Gsmads/EV-Controller/docs/images/Схема_Контроллера.png

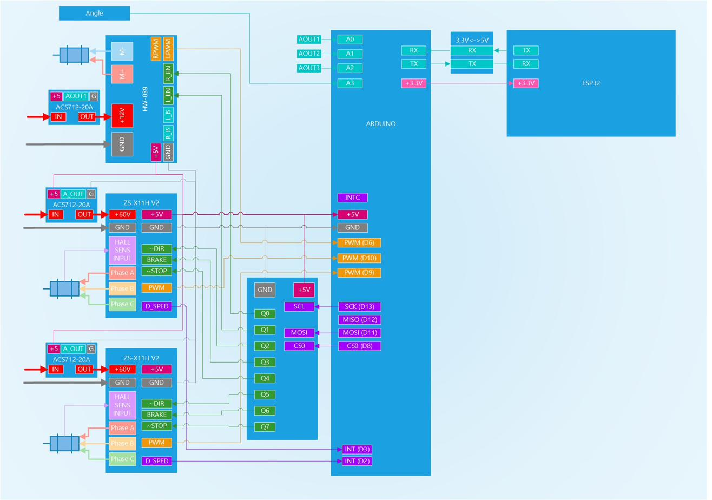
docs/images/Схема_Контроллера.png
