Gsmads/EV-Controller/docs/adr/README.md

# Архитектурные решения (ADR)

Записи решений, которые дороже отменить, чем принять. Формат и правила —
`../CONVENTIONS.md` §4. Шаблон — `0000-template.md`.

ADR не редактируются после принятия. Изменение решения оформляется новым
ADR со ссылкой «заменяет ADR-NNNN».

| № | Решение | Статус |
|---|---|---|
| [0001](0001-chetyre-sloya.md) | Четырёхслойная архитектура с изоляцией платформы | принято |
| [0002](0002-otkaz-ot-funkcij-arduino.md) | Отказ от функций Arduino, HAL на регистрах | принято |
| [0003](0003-nastrojki-v-eeprom.md) | Настройки в EEPROM, изменяемые по UART | принято |
| [0004](0004-sloistaya-model-pedalej.md) | Слоистая модель педалей с комбинатором | принято |
| [0005](0005-reestr-parametrov.md) | Реестр параметров как единый контракт | принято (ADR-0017) |
| [0006](0006-politika-poteri-svyazi.md) | Три таймаута, политика потери связи настраивается | предложено |
| [0007](0007-gibridnyj-raschet-skorosti.md) | Гибридный расчёт скорости | предложено |
| [0008](0008-bezopasnoe-sostoyanie-apparatno.md) | Безопасное состояние задаётся аппаратно | принято |
| [0009](0009-analogovye-kanaly-nastraivaemy.md) | Аналоговые каналы настраиваемы, цифровые нет | принято |
| [0010](0010-timer0-ostayotsya-pod-tik.md) | Timer0 под системный тик, ШИМ руля 976 Гц | принято |
| [0011](0011-binarnyj-protokol.md) | Бинарный протокол с CRC16 | принято |
| [0012](0012-vanilla-js-i-abstraktnyj-transport.md) | Vanilla JS с абстрактным транспортом | принято |
| [0013](0013-licenziya-gpl-v3.md) | Лицензия проекта — GPL v3 | принято |
| [0014](0014-vremennye-isklyucheniya-storozhej.md) | Сторожа границ платформы со списком временных исключений | принято |
| [0015](0015-skorost-uart-250000.md) | Скорость UART — 250000 бод | принято |
| [0016](0016-politika-perepolneniya-tx.md) | Политика при переполнении TX выбирается настройкой | принято |
| [0017](0017-izmenyaemaya-konstanta-zhivyot-v-nastrojkah.md) | Изменяемая константа живёт в настройках, а не в коде | принято |
| [0018](0018-sobstvennyj-drajver-uart.md) | Собственный драйвер UART вместо адаптации Grbl | принято |
| [0019](0019-skorost-uart-nastrojka-s-otkatom.md) | Скорость UART — настройка с испытательным периодом и откатом | принято |
| [0020](0020-domennye-imena-signalov.md) | Основной код называет сигналы, слой железа их привязывает | принято |
| [0021](0021-hranilishcha-abstragirovany.md) | Программа знает «постоянное» и «долговременное», а не PROGMEM и EEPROM | принято |

**Статусы:** предложено — решение сформулировано, но не реализовано;
принято — реализовано или обязательно к соблюдению; заменено — см. ссылку.
