Gsmads/EV-Controller/docs/adr/0014-vremennye-isklyucheniya-storozhej.md

# ADR-0014: Сторожа границ платформы вводятся со списком временных исключений

**Статус:** принято
**Дата:** 12.09.2026
**Заменяет:** —
**Заменён:** —

## Контекст

Задачи 0.2.4 и 0.2.5 (`docs/SLICE_0_PLAN.md:68-69`) требуют завести двух сторожей:
`Arduino.h` и `avr/*` не встречаются нигде, кроме `hal_atmega328p.cpp` (ADR-0001),
и функции Arduino не вызываются нигде, включая HAL (ADR-0002). Этап 0.2 идёт
до исправления дефектов намеренно: «Сначала проверки, потом исправления. Иначе
первое же исправление окажется непроверяемым» (`docs/SLICE_0_PLAN.md:60-61`).

На снимке `8f16d9c` оба правила уже нарушены, и оба нарушения — не свежие ошибки,
а унаследованный код:

**Заголовки — два файла.** `firmware/MICRO_UART.h:22` и `firmware/PRINT.h:1`
включают `Arduino.h`. Оба пришли из Grbl вместе с кодом UART. Через них Arduino Core
доходит до `firmware/app_debug.cpp:7-8` — файла слоя `app_*`, прямо названного
в запрете `docs/CONVENTIONS.md:15`.

**Функции — семь вызовов, все в `hal_atmega328p.cpp`:** `pinMode` (строки 41-43),
`digitalWrite` (49), `digitalRead` (54), `millis` (289), `delayMicroseconds` (294).

Из этого следует выбор, которого не было бы на чистом дереве: сторож, введённый
как есть, красный с первого дня — на всё время этапов 0.3 и 0.4, то есть ровно тогда,
когда по красному CI предстоит судить об исправлениях блокирующих дефектов.

Убрать нарушения сразу тоже нельзя целиком. GPIO-часть переписывается на регистры
без внешних условий, а `hal_system_millis` — нет: замена требует выбрать таймер
системного тика, а пункт C-2 `docs/HARDWARE_BRINGUP.md:483-498` не закрыт («**Решено:**
\_\_\_\_», сводка `:609` — «⬜ решение владельца»), и сам код противоречит ADR-0010
(комментарии `hal_atmega328p.cpp:12`, `:277`, `:283` называют Timer2, ADR-0010 и
`HARDWARE_BRINGUP.md:485-486` — Timer0). Кроме того, вся правка лежит в HAL,
а `docs/CONVENTIONS.md:220` относит проверку HAL на железо, которого сейчас нет:
этап 0.1 не выполнен, поле «Сделано» в `docs/HARDWARE_BRINGUP.md:230` пусто.

`docs/CONVENTIONS.md:23` допускает отступление от правил раздела 1 только с ADR.
Настоящая запись и есть это решение.

## Решение

Сторожа вводятся сейчас, со списком исключений, зафиксированным в самом стороже —
`tools/ci/check_layer_boundaries.py`.

**Исключения по заголовкам** (проверка `headers`): `firmware/MICRO_UART.h`,
`firmware/PRINT.h`. Снимаются задачей
[#31](https://github.com/Gsmads/EV-Controller/issues/31).

**Исключения по функциям** (проверка `functions`): в `firmware/hal_atmega328p.cpp`
допускаются `pinMode` — не более 3 вхождений, `digitalWrite` — 1, `digitalRead` — 1,
`millis` — 1, `delayMicroseconds` — 1. Снимаются задачей
[#32](https://github.com/Gsmads/EV-Controller/issues/32).

Исключения заданы **числом вхождений, а не файлом целиком**. Восьмой вызов в том же
файле сторож уже отвергает; список может только сокращаться. Проверено намеренным
нарушением: добавленный `millis()` в `hal_atmega328p.cpp` роняет проверку с указанием
«исключение допускает 1 вхождений, найдено больше».

Каждое исключение несёт в коде сторожа ссылку на снимающую его issue. Исключение
без такой ссылки не добавляется: у компромисса должен быть срок, а не только причина.

## Последствия

**Что становится проще.** Правило начинает действовать на весь остальной код
немедленно: любое новое нарушение в `svc_*`, `util_*`, `cfg_*`, `app_*` и в самом HAL
роняет CI. Этапы 0.3 и 0.4 идут при зелёном CI, поэтому красный на них означает
настоящую поломку, а не унаследованный фон.

**Что становится сложнее.** В проекте появляется место, где правило записано
дважды: в `CONVENTIONS.md` §1 и в списке исключений сторожа. Пока исключения живы,
утверждения `README.md:163-164`, `docs/MVP1_API.md:30` и `firmware/hal_atmega328p.cpp:9`
остаются неверными — это зафиксировано в #31 и #32, а не замолчано.

**Что мы обязаны поддерживать.** Список исключений сокращается вместе с закрытием
#31 и #32 и не растёт: новое исключение потребует нового ADR. Раздел «чего сторож
не покрывает» в шапке `check_layer_boundaries.py` обновляется вместе с самим сторожем —
этого требует `docs/SLICE_0_PLAN.md:76-77`.

**Чего решение не даёт.** Сторожа текстовые. Косвенное включение (`app_debug.cpp`
получает Arduino Core через `MICRO_UART.h`), использование платформенных имён без
включения их заголовка (`ISR`, `UDR0`, `PSTR`, `pgm_read_byte_near`), макросы `A0`…`A7`
в `cfg_board.h` и подстановка `Arduino.h` в `.ino` силами Arduino IDE не ловятся
ни одной из двух проверок. Полный перечень — в шапке сторожа.

## Отклонённые варианты

| Вариант | Почему отклонён |
|---|---|
| Переписать HAL и заголовки сейчас, ввести сторожа без исключений | Правило соблюдалось бы буквально, но `hal_system_millis` упирается в незакрытый C-2: таймер системного тика не выбран, а это решение владельца. Вся правка лежит в HAL и проверяется только на железе (`CONVENTIONS.md:220`), которого нет: этап 0.1 не выполнен. Этап «сначала проверки» превратился бы в правку прошивки вслепую |
| Ввести сторожа красными, чинить по ходу | Красный CI на всё время этапов 0.3-0.4 перестаёт быть сигналом. Ровно то, ради чего сторожа заводились, было бы потеряно: на красном фоне новое нарушение не видно |
| Отложить сторожей до конца 0.3-0.4 | Прямо противоречит порядку плана (`SLICE_0_PLAN.md:60-61`): исправления блокирующих дефектов пошли бы без проверки, которая их страхует. Первое же исправление оказалось бы непроверяемым |
| Исключить `hal_atmega328p.cpp` из проверки функций целиком | Проще в коде, но прячет будущие нарушения в единственном файле, где они наиболее вероятны: HAL и пишется вокруг работы с платформой. Счётчик вхождений даёт то же удобство, не теряя надзора |
| Отключить правило в `CONVENTIONS.md` §1.2 для HAL | Меняет само решение ADR-0002 ради удобства одного этапа. Переносимость — причина, по которой проект вообще разделён на слои; отказываться от неё из-за семи унаследованных строк несоразмерно |
| Пометить нарушения комментарием `// NOLINT` в коде | Исключение расползается по файлам прошивки и перестаёт быть видимым списком. Здесь оно собрано в одном месте, с числами и ссылками на issue |

## Проверка

Критерий приёмки этапа (`docs/SLICE_0_PLAN.md:72-74`) и проверки сверх него.
Все выполнены на снимке перед принятием решения:

| Случай | Ожидание | Факт |
|---|---|---|
| Текущее дерево, обе проверки | зелёный | зелёный, исключения перечислены в выводе |
| `#include <Arduino.h>` в `svc_ramp.cpp` | красный, назван файл и строка | `firmware/svc_ramp.cpp:10`, найдено `Arduino.h` |
| откат той же строки | зелёный | зелёный |
| `#include <avr/io.h>` в `svc_speed.cpp` | красный | `firmware/svc_speed.cpp:30`, найдено `avr/io.h` |
| `#include <avr/pgmspace.h>` в `app_protocol.cpp` | красный | `firmware/app_protocol.cpp:21` — файл не собирается тестами, десктопная сборка его не проверила бы |
| `digitalWrite(9, HIGH);` в `svc_ramp.cpp` | красный | `firmware/svc_ramp.cpp:71`, найдено `digitalWrite` |
| лишний `millis()` в `hal_atmega328p.cpp` | красный, несмотря на исключение | `:291`, «исключение допускает 1 вхождений, найдено больше» |
| то же нарушение внутри комментария | зелёный | зелёный, обе проверки |

Исключение считается снятым, когда соответствующая запись удалена из
`tools/ci/check_layer_boundaries.py` и обе проверки зелёные без неё.
