Gsmads/EV-Controller/docs/adr/0002-otkaz-ot-funkcij-arduino.md

# ADR-0002: Отказ от функций Arduino, собственный HAL на регистрах

**Статус:** принято
**Дата:** 2026-09-09

## Контекст
Первая реализация HAL внутри себя вызывала Arduino: `digitalWrite`,
`analogRead`, `millis`, `delayMicroseconds`. Формально правило «платформа
только в HAL» соблюдалось, но фактически проект оставался привязан
к Arduino Core.

Три проблемы:
1. `digitalWrite` выполняется около 50 тактов из-за поиска в таблицах
   и отключения ШИМ — для сигналов, дёргаемых в цикле 100 Гц, это расход
   без пользы.
2. `millis` завязан на таймер, который ядро настраивает по-своему,
   и это ограничивает свободу в распределении таймеров.
3. Переезд на STM32 требовал бы не замены файла, а разбирательства,
   какие ещё зависимости от ядра просочились.

## Решение
Функции Arduino не используются нигде, включая HAL. Внутри
`hal_atmega328p.cpp` реализуются собственные эквиваленты на прямой работе
с регистрами: порты, АЦП, таймеры, системный тик, внешние прерывания,
задержка микросекундного порядка.

Интерфейс HAL при этом не меняется — правка внутренняя.

## Последствия
- Прошивка перестаёт зависеть от Arduino Core, кроме тулчейна сборки.
- Время выполнения операций становится предсказуемым.
- Растёт ответственность: ошибки в работе с регистрами не поймает
  ядро, их поймает только стенд.
- Скетч по-прежнему собирается в Arduino IDE — это удобно и остаётся.

## Отклонённые варианты
| Вариант | Почему отклонён |
|---|---|
| Оставить Arduino внутри HAL | Скрытая привязка к ядру, непредсказуемое время выполнения |
| Перейти на PlatformIO с чистым avr-gcc | Полезно, но это отдельное решение про инструменты; сейчас важнее избавиться от зависимости в коде, а не сменить IDE |
| Сразу писать под STM32 HAL | Железо есть в руках именно ATmega, переезд гипотетичен |

## Проверка
Сторож в CI дополняется списком запрещённых идентификаторов Arduino.
Замер: время выполнения `hal_gpio_write` на осциллографе — ожидается
единицы тактов вместо десятков.
