Gsmads/EV-Controller/docs/adr/0010-timer0-ostayotsya-pod-tik.md

# ADR-0010: Timer0 остаётся под системный тик, ШИМ руля работает на 976 Гц

**Статус:** принято
**Дата:** 2026-09-09

## Контекст
ШИМ электроусилителя руля выведен на D6, то есть на вывод сравнения
Timer0. Этот же таймер традиционно обслуживает системный тик.

Перенастройка Timer0 ради произвольной частоты ШИМ руля сломала бы
отсчёт времени, на котором держится весь планировщик.

## Решение
На текущем этапе Timer0 сохраняет роль системного тика. ШИМ руля
работает на частоте, которую даёт стандартная конфигурация — около
976 Гц.

Решение принимается как временное и пересматривается, если на стенде
выяснится, что писк редукторного мотора руля неприемлем.

## Последствия
- Планировщик и все измерения времени остаются работоспособными.
- Мотор руля будет слышно. Для редукторного привода детского автомобиля
  976 Гц — рабочая частота, шум терпим.
- Свобода выбора частоты ШИМ руля отсутствует, пока решение не изменено.
- Разрешение ШИМ руля — 8 бит вместо 10 у моторов колёс. Для позиционного
  контура этого достаточно.

## Отклонённые варианты
| Вариант | Почему отклонён |
|---|---|
| Перенастроить Timer0 под ШИМ | Ломает системный тик, от которого зависит весь планировщик |
| Перенести тик на Timer2 заранее | Оправданно, но это отдельная работа с риском; делать её до первого запуска руля нет причин |
| Перенести ШИМ руля на другой вывод | Выводы сравнения Timer1 заняты моторами, Timer2 — не разведён на нужный вывод |

## Проверка
После сборки узла руля: измерить уровень шума на слух и осциллографом
проверить, что тик не сбивается при работе ШИМ руля.
