Gsmads/EV-Controller/docs/design/mockup.html

EV CONTROL ROOM

PORT/dev/ttyUSB0 UPTIME00:00:00 PWM7812 Hz FAULTS · 0

### Control Source

PEDALS live

UART override

### External Inputs MVP-3

Ignition

Neutral

Handbrake

Eco

Sport

Reverse

Turn L

Turn R

### Lights MVP-2

◯

HEAD OFF

◯

TAIL OFF

◉

BRAKE ON

◯

REV OFF

◯

TURN L —

◯

TURN R —

### Communication

TX rate10 / s

RX rate0 / s

CRC errors0

Latency2.4 ms

Baud9600

BATTERY

72%

24.8V

2.1A

MVP-3

000

PWM ‰

ECO

PEDALS · LIVE

CURRENT TARGET

PWM SPEED

PWM Pedals Power L/R Current Speed Steering

PWM TARGET / CURRENT 000 000

PEDAL INPUT 000 000

POWER PER WHEEL MVP-2 L R

GAS

0000/1023

BRAKE

0000/1023

LCK NEU HBR ECO NRM SPT REV PRT

RELEASE
TO PEDALS E·STOP
