Gsmads/EV-Controller/CLAUDE_CODE_START.md

# Стартовое сообщение для Claude Code

Распаковать архив, открыть папку `EV_Controller` в Claude Code,
скопировать блок ниже целиком в первое сообщение.

---

```
Привет. Начинаем работу над контроллером детского электромобиля.

СНАЧАЛА ПРОЧИТАЙ, НИЧЕГО НЕ МЕНЯЯ:
  1. CLAUDE.md                  — правила проекта, что требует моего решения
  2. docs/CONVENTIONS.md        — код, комментарии, ADR, коммиты, DoD
  3. docs/SLICE_0_PLAN.md       — план работ, которым мы займёмся
  4. docs/AUDIT.md              — что сломано и почему
  5. docs/HARDWARE_BRINGUP.md   — что уже измерено на железе, что нет
  6. docs/adr/README.md         — принятые архитектурные решения
  7. README.md                  — обзор проекта

Ключевой контекст: в машине ездит ребёнок. Код никогда не запускался
на реальном железе. Документация местами расходится с кодом — истина
всегда код, но расхождение чинится, а не обходится.

ЗАДАЧА ЭТОЙ СЕССИИ — только репозиторий. Дефекты НЕ чиним.

  1. Инициализируй git-репозиторий в текущей папке.

  2. Первый коммит — снимок как есть, без единой правки кода.
     Сообщение должно честно фиксировать состояние: код на железе
     не проверялся, известны блокирующие дефекты, см. docs/AUDIT.md

  3. Заведи issues по docs/SLICE_0_PLAN.md — по одной на задачу
     этапов 0.2–0.7. Метки как в docs/CONVENTIONS.md §5:
     blocker, safety, hw-unknown, debt, docs.
     Формулировка — наблюдаемым поведением, не «переписать модуль».
     Каждая issue содержит: что наблюдается, что ожидается, как проверить.
     Задачи со safety дополнительно — что происходит в худшем случае.

     Этап 0.1 (аппаратный) issues не требует — это моя работа с паяльником.

  4. Покажи мне:
     - дерево репозитория
     - git log
     - список заведённых issues с метками

ЧЕГО НЕ ДЕЛАТЬ В ЭТОЙ СЕССИИ:
  - не исправлять дефекты
  - не трогать firmware/
  - не переписывать документацию
  - не добавлять зависимости
  - не создавать CI (следующая сессия)

Если возникнет вопрос, ответ на который меняет структуру или поведение —
останови работу и покажи развилку таблицей «что делает / чем платим»
с твоей рекомендацией. Жди моего ответа.
```

---

## План следующих сессий

Каждая начинается с «прочитай CLAUDE.md, docs/CONVENTIONS.md и текущий
этап из docs/SLICE_0_PLAN.md», дальше — одна тема.

### Сессия 2 — этап 0.2, сторожа

> Заводим проверки до исправлений, иначе первое же исправление
> окажется непроверяемым.
>
> Задачи 0.2.3–0.2.6 из плана среза.
>
> Критерий приёмки строгий: намеренно добавленный `#include <Arduino.h>`
> в `firmware/svc_ramp.cpp` роняет CI с внятным сообщением; после отката —
> зелёный. То же для `digitalWrite` в любом файле сервисов.
>
> Сторож должен в комментарии честно писать, чего он не покрывает.

### Сессия 3 — этап 0.3, блокирующие дефекты

> Строго по одному дефекту за коммит, каждый начинается с красного теста.
>
> 0.3.1 TX-буфер, 0.3.2 сентинел 0xFF, 0.3.3 формула скорости,
> 0.3.4 аппаратный watchdog.
>
> По 0.3.1 и 0.3.4 сначала покажи развилку — там выбор политики,
> он описан в плане.

### Сессия 4 — этап 0.4, безопасность

> 0.4.1 аварийная остановка как защёлкивающееся состояние,
> 0.4.2 асимметрия watchdog газа и тормоза,
> 0.4.3 минимальный валидатор настроек,
> 0.4.4 смена режима.
>
> 0.4.1 и 0.4.2 меняют поведение безопасности: сначала развилка,
> потом ADR, потом код. ADR-0006 уже описывает целевую модель.

### Сессия 5 — этап 0.5, точность управления

> 0.5.1 фактический шаг времени вместо предполагаемого — развилка
> в плане, я склоняюсь ко второму варианту.
> 0.5.2 счётчик пропущенных дедлайнов в телеметрии.

### Сессия 6 — этап 0.6, ввод железа в строй

> Замеры делаю я, ты готовишь диагностические скетчи: подсчёт импульсов
> энкодера, развёртка АЦП по всем каналам, генератор ШИМ заданной частоты.
> Результаты вносим в docs/HARDWARE_BRINGUP.md, заводские значения
> в cfg_settings.cpp заменяем на измеренные.

### Сессия 7 — этап 0.7, документация

> Привести PROTOCOL.md и ARCHITECTURE.md в соответствие с кодом.
> Добавить в шапки версии, даты и список документов-оснований.
> Проверка: пять произвольных утверждений из документации
> подтверждаются кодом.

---

## Что делаю параллельно я

| Когда | Что |
|---|---|
| **До сессии 3** | Резисторы на D9, D10, D6 — иначе перепрошивка даёт полный газ |
| До сессии 3 | Решить уровень покоя BRAKE (HARDWARE_BRINGUP A-5) |
| До сессии 3 | Проверить загрузчик — от этого зависит включение watchdog |
| До сессии 6 | Прозвонка HC595, осциллограф на оптопарах |
| До сессии 6 | Замеры: аналоговые каналы, диапазон АЦП, импульсы на оборот |
