Gsmads/EV-Controller/docs/AUDIT.md

# Технический аудит проекта EV Controller

**Дата:** 09.09.2026
**Объём:** firmware (37 файлов), web GUI (17 файлов), тесты (71), документация
**Метод:** чтение кода, проверка формул расчётами, сквозная сверка слоёв протокола, сверка с `Методология_разработки_v1.0.md`
**Статус проверки на железе:** прошивка не запускалась на реальном контроллере ни разу

---

## 0. Вердикт

**Структура — хорошая. Реализация — не поедет.**

Разделение на слои, изоляция платформы в одном файле, настройки в EEPROM с CRC, конфигурируемый комбинатор педалей, модульный фронтенд — это правильные решения уровня senior. Они не потребуют переписывания.

Но внутри этой структуры находятся дефекты, из-за которых система в текущем виде **не заработает при первом включении**, а три из них — вопросы безопасности ребёнка. Причина одна и та же: код писался «вперёд», без единого прогона на железе и без тестов на критических модулях. Всё, что покрыто тестами (`util_math`, `cfg_settings`, `svc_ramp`), — корректно. Всё, что не покрыто (`svc_speed`, `svc_pedals`, протокол, UART), — содержит дефекты.

Это ровно то, о чём говорит методология: **«держится сборкой, а не памятью»**. Здесь оно держалось памятью — и не удержалось.

---

## 1. Блокирующие дефекты

### B-1. TX-буфер UART в 9 байт вместо 64 — телеметрия физически не пролезает

`cfg_board.h` объявляет `TX_BUFFER_SIZE 64`. Но `MICRO_UART.cpp` **не включает `cfg_board.h`** — только собственный заголовок. В этой единице трансляции срабатывает `#ifndef` по умолчанию: `TX_BUFFER_SIZE = 8`, кольцевой буфер = 9 байт.

Пакет телеметрии — 36 байт данных + 5 служебных = **41 байт**.

Хуже: из `serial_write()` **удалена проверка переполнения**, которая есть в оригинальном Grbl:

```c
void serial_write(uint8_t data) {
  uint8_t next_head = serial_tx_buffer_head + 1;
  if (next_head == TX_RING_BUFFER) { next_head = 0; }

  /* ← здесь в Grbl стоит:
       while (next_head == serial_tx_buffer_tail) { ... }
     в этом коде — пустая строка */

  serial_tx_buffer[serial_tx_buffer_head] = data;   // затирает неотправленные данные
  serial_tx_buffer_head = next_head;
}
```

**Следствие:** каждый пакет телеметрии затирает сам себя в буфере. CRC не сойдётся, веб не получит ничего. Разработчик увидит «Arduino подключён, данных нет» и будет искать проблему в Python.

**Исправление:** добавить `#include "cfg_board.h"` первой строкой `MICRO_UART.cpp` **и** вернуть проверку заполнения. Вопрос политики при переполнении — отдельное решение: блокировать (как Grbl) нельзя в цикле управления 100 Гц; правильнее отбрасывать пакет целиком и считать счётчик потерь как перечислимый исход.

**Решение владельца (ADR-0016).** Политика выбирается настройкой: отбрасывать пакет (умолчание) либо ждать. Счётчик `uart_tx_dropped` уходит в телеметрию. Довод «блокировать нельзя» относился к 9600, где пакет занимал 42,71 мс — четыре цикла управления. На 250000 (ADR-0015) тот же худший случай — 1,64 мс, то есть 16,4 % одного периода, и ожидание ограничено сверху скоростью линии.

**Состояние: исправлено.** `MICRO_UART.*` удалены (ADR-0018). Кольцевой буфер переехал в переносимый `util_ring` и покрыт десктопными тестами: запись в полное кольцо отвергается и не затирает ранее записанные байты. Кадр собирается целиком в `app_protocol.cpp` и уходит одним вызовом `hal_uart_write_buf()` — только там известна его длина. Обе политики ADR-0016 реализованы в `hal_atmega328p.cpp`.

Попутно найдено и исправлено: `TX_BUFFER_SIZE` был равен 64, то есть полезная ёмкость кольца — ровно 64 байта, а максимальный кадр протокола — 1 + 1 + 1 + 60 + 2 = **65 байт**. Самые длинные кадры отбрасывались бы всегда. Поднято до 72.

---

### B-2. Байт 0xFF в пакете уничтожает пакет

`SERIAL_NO_DATA = 0xFF` — сигнал «буфер пуст» из Grbl, где по UART шёл ASCII и 0xFF не встречался. В бинарном протоколе 0xFF — обычный байт данных.

```c
uint8_t byte = hal_uart_read();
if (byte == HAL_UART_NO_DATA) break;   // ← байт уже вынут из буфера и потерян
parser_feed(byte);
```

`serial_read()` **уже удалил байт** из кольцевого буфера, прежде чем вернуть его. Байт 0xFF молча исчезает, пакет рвётся, CRC не сходится.

Что ломается на практике:

| Команда | payload | Результат |
|---|---|---|
| `setGasVirtual(1023)` | `FF 03` | **никогда не доходит** |
| `setGasVirtual(767)` | `FF 02` | никогда не доходит |
| `setGasVirtual(511)` | `FF 01` | никогда не доходит |
| `setGasVirtual(255)` | `FF 00` | никогда не доходит |
| любая команда | CRC = `??FF` | теряется примерно 1 из 128 |

Полный газ по UART скомандовать невозможно. Остальные команды теряются случайно — самый неприятный класс отказов: «иногда работает».

**Исправление:** `hal_uart_read()` должен вернуть `int16_t` (−1 = пусто) либо читать через `hal_uart_available()` перед чтением. Сентинел внутри диапазона данных — архитектурная ошибка, а не мелочь.

**Состояние: исправлено.** `hal_uart_read()` возвращает `int16_t`, −1 означает «данных нет»; `HAL_UART_NO_DATA` удалён вместе с `MICRO_UART.*` (ADR-0018). Проверено десктопным тестом на всех 256 значениях байта: ни одно не является для буфера особенным.

---

### B-3. Расчёт скорости занижен в 3,6 раза

`svc_speed.cpp`:

```c
kmh_x10 = (avg_rpm * WHEEL_DIAMETER_MM * 188UL) / 360000UL;
```

Проверка при D = 200 мм, RPM = 300:

| | значение |
|---|---|
| Физика: `RPM·π·D·60/10⁶` | 11,31 км/ч → `kmh_x10 = 113` |
| Формула в коде | `31` → показывает 3,1 км/ч |

Правильно: `kmh_x10 = RPM · D · 1885 / 1000000`.

Отдельно стоит отметить комментарий над формулой — он содержит «проверку», которая подтверждает неверный результат:

```
(проверка: 3.1 км/ч × 200мм × π × 60 / 1000 = 3.14 км/ч ✓)
```

Это не арифметика, а совпадение с числом π. **Комментарий-самоподтверждение опаснее отсутствия комментария**: он выключает подозрение у следующего читателя. Именно поэтому методология требует эталонных фикстур, а не рассуждений в комментариях.

Дуга скорости на циферблате — центральный диагностический элемент всего дашборда (разница «скорость vs ШИМ» = нагрузка). Сейчас она врала бы втрое.

**Состояние: исправлено.** Формула выведена заново от физики: `kmh_x10 = RPM × D × 1885 / 1 000 000`, где 1885 ≈ 60 × π × 10 (ошибка коэффициента +0,0024 %). Добавлено округление к ближайшему вместо усечения: усечение занижает всегда, а систематически заниженный спидометр — не та ошибка, которую стоит иметь. Комментарий-самоподтверждение удалён, вместо него — вывод в четыре строки.

Модуль до этого не был покрыт ничем; появился `tests/test_svc_speed.c` с эталонными точками, посчитанными вручную от физики. Красный тест показывал ровно числа аудита: `exp=113 got=31`. Заодно проверен одометр — его формула оказалась верной, погрешность усечения 1 мм на полоборота (0,3 %), зафиксирована числом.

---

### B-4. Смена режима не работает, но интерфейс показывает, что работает

```c
static void handle_set_mode(...) {
    if (payload[0] >= DRIVE_MODE_COUNT) { send_nack(...); return; }
    /* TODO: интеграция с svc_drive_mode в MVP-3+ */
    send_ack(CMD_SET_MODE);     // ← ACK на невыполненную команду
}
```

`current_profile` присваивается один раз в `setup()` и больше не меняется. В телеметрии `t.drive_mode = DRIVE_MODE_ECO` захардкожен.

Родитель нажимает SPORT → кнопка подсвечивается, контроллер отвечает ACK, машина остаётся в ECO. Обратная ситуация опаснее: нажали ECO, чтобы ограничить ребёнка, — ограничение не применилось.

**Это нарушение принципа «система думает на глазах»** из методологии: интерфейс показывает не состояние системы, а собственное намерение. ACK на невыполненное действие — худший вариант: он гасит подозрение.

**Минимальное исправление до появления `svc_drive_mode`:** обновлять `current_profile` в обработчике и возвращать реальный режим в телеметрии. Либо честно отвечать `NACK(ERR_NOT_IMPLEMENTED)` — но тогда веб должен это показать.

---

---

### B-5. Прошивка не собирается: два модуля не компилируются ни одним компилятором

Обнаружено при вводе покомпонентной проверки (задача #33). До неё девять
модулей из тринадцати не видел ни один компилятор: в `tests/Makefile`
участвуют четыре файла, остальные проверялись только чтением.

Два модуля не компилируются — и это не особенность десктопной сборки,
а отказ в любой среде, включая Arduino IDE:

```
firmware/app_protocol.cpp:190:59: error: 'NULL' was not declared in this scope
firmware/cfg_board.h:41:33:       error: 'A0' was not declared in this scope
firmware/cfg_board.h:42:33:       error: 'A1' was not declared in this scope
```

`NULL` объявлен в `stddef.h`, которого `app_protocol.cpp` не включает;
`A0`/`A1` объявлены в `Arduino.h`, которого не включает `svc_pedals.cpp`.
Arduino IDE подставляет `Arduino.h` **только в `.ino`**, отдельные `.cpp`
обязаны включать его сами. Ни один из двух файлов этого не делает.

Третий отказ сборки уже был известен и записан в шапке `ci.yml`:
`EV_Controller.ino:152` вызывает `hal_uart_init(UART_BAUD_DEBUG)`, а макроса
`UART_BAUD_DEBUG` нет ни в одном заголовке репозитория.

**Следствие:** утверждение «код никогда не исполнялся на реальном железе»
точнее звучит как «код никогда не был собран». Любая оценка правок в этих
модулях до сих пор была оценкой текста, а не программы.

**Исправление.** `app_protocol.cpp` — включить `stddef.h`, правка механическая.
`svc_pedals.cpp` — решение владельца: `A0`…`A7` в `cfg_board.h` это константы
ядра Arduino, и чем их заменить, зависит от того, что принимает `hal_adc_read()` —
номер канала АЦП (0…7) или номер вывода платы (14…21). Разница молчаливая:
неверный выбор даст чтение не того входа, то есть педаль газа с чужого датчика.
Пока вопрос открыт, `svc_pedals.cpp` числится в списке известных падений
`tools/ci/check_modules_compile.sh`.

**Состояние: все три причины закрыты.** `app_protocol.cpp` — включён `stddef.h`.
`UART_BAUD_DEBUG` в `EV_Controller.ino` заменён на `UART_BAUD_DEFAULT`
из `cfg_board.h` (ADR-0015). `svc_pedals.cpp` — макросы `A0`…`A7` удалены
из `cfg_board.h` вместе с переездом карты каналов АЦП в настройки (ADR-0009).
Список известных падений `tools/ci/check_modules_compile.sh` пуст, компилируется
10 модулей из 13; три оставшихся платформенные и собираются AVR-тулчейном.

Ответ на вопрос «канал АЦП или вывод платы» был записан заранее: ADR-0009
называет эти числа индексами каналов и переносит их в настройки, потому что
соответствие сигналов входам определяется монтажом, а не схемой.

Оговорка: сам `EV_Controller.ino` десктопной проверкой не покрыт и покрыт
быть не может — Arduino IDE подставляет в скетч `Arduino.h` сама. Утверждать
«прошивка собирается» можно будет только после сборки в IDE.

## 2. Дефекты безопасности

### S-1. Аварийная остановка снимается сама через 200 мс

```c
handle_emergency_stop():
    svc_pedals_set_uart_gas(0);
    svc_pedals_set_uart_brake(1023);   // ставит uart_last_ms = now
```

и в `svc_pedals_update()` тот же watchdog применяется к обеим педалям:

```c
apply_watchdog(&gas,   now, timeout);   // 200 мс
apply_watchdog(&brake, now, timeout);   // 200 мс  ← и к тормозу тоже
```

Веб отправляет `emergencyStop()` **один раз** по нажатию. Через 200 мс `brake_uart` обнуляется. Если ребёнок держит педаль газа — машина поедет снова.

Ошибка в основе: **watchdog применён симметрично к асимметричным по безопасности величинам**. Обнуление газа при потере связи — безопасно (fail-safe). Обнуление тормоза — опасно (fail-dangerous). Один таймаут на оба.

**Исправление — два решения, оба нужны:**
1. Аварийная остановка должна **защёлкиваться** (latch) и сниматься только явной командой + подтверждением. Это отдельное состояние машины, а не «значение педали 1023».
2. Watchdog тормоза не должен обнулять тормоз. При потере связи корректное поведение — *удерживать* торможение, а не снимать.

По методологии это «необратимое/критичное действие с одной охраняемой дверью»: E-STOP — не педаль, а состояние.

---

### S-2. Аппаратный watchdog никогда не включается

ТЗ §8.3 требует: *«Watchdog Arduino: аппаратный, 8 сек»*.
`ARCHITECTURE.md` перечисляет `hal_system_wdt_reset` как задачу с приоритетом «Критический», интервал 10 мс.

В коде: `hal_system_wdt_enable()` реализован в HAL и **не вызывается ниоткуда**. `wdt_reset()` в планировщик не добавлен.

Зависание прошивки при поданном ШИМ = машина едет без управления до разряда батареи или физического E-Stop.

Отдельно: включение watchdog требует аккуратности со старыми загрузчиками Arduino Nano (после сброса по watchdog устройство может уйти в бесконечный ребут). Это надо решать вместе с выбором загрузчика, а не «дописать строчку».

**Статус: закрыто в части, не требующей железа (ADR-0022).** Код есть: задача `task_watchdog` с тактом 100 мс, включение в конце `setup()`, таймаут 8 с. Всё это под флагом `WATCHDOG_ENABLED` в `cfg_board.h`, по умолчанию `0`, — на стоковом загрузчике watchdog не включается ни при каких условиях. Сброс делает задача планировщика, а не `loop()`: зависание внутри любой задачи означает, что до сброса дело не дойдёт. Расхождение с `ARCHITECTURE.md` (задача `wdt_reset`, такт 10 мс) закрыто тем же изменением. Остаётся прошить optiboot и поставить флаг в `1` — критерий приёмки на железе описан в ADR-0022.

Найдено попутно: `hal_system_reset()` реализован через `wdt_enable(WDTO_15MS)` и вечный цикл, то есть на стоковом загрузчике выводит плату из строя точно так же. Функция не вызывается ниоткуда; в коде теперь стоит предупреждение.

---

### S-3. Настройки принимают любые значения и уходят в EEPROM

```c
uint8_t cfg_settings_set_field(uint16_t offset, const void *data, uint8_t size)
{
    if (offset + size > sizeof(settings_t)) return 1;   // единственная проверка
    memcpy(ptr + offset, data, size);
    return 0;
}
```

Проверяется только выход за границы структуры. Не проверяется ничего по смыслу:

| Запись | Последствие |
|---|---|
| `brake_rate_max = 0` | **тормоз перестаёт работать**, сохраняется в EEPROM |
| `brake_rate_min = 0` | то же при слабом нажатии |
| `max_pwm = 65535` | выход за диапазон, спасает только клэмп ниже по цепочке |
| `motor_deadzone = 200` | резкий старт с 20 % ШИМ |
| `uart_pedal_timeout_ms = 65535` | watchdog виртуальных педалей отключён |
| `gas_combinator = 4` (UART_ONLY) | физическая педаль ребёнка перестаёт действовать |

Смещения приходят из веба «как есть». Ошибка в схеме на фронтенде (сдвиг на два байта при добавлении поля в `settings_t`) тихо запишет мусор в соседнее поле и **сохранит его в EEPROM**.

Это прямое нарушение принципа **«единственный писатель»** и **«опасные способности — за шлюзом»**: у настроек нет валидатора, нет одной охраняемой двери.

**Исправление:** таблица дескрипторов полей (offset, размер, min, max, «требует остановки»), разделяемая между прошивкой и вебом. Запись только через идентификатор параметра, а не сырое смещение. Это же снимет проблему рассинхронизации схемы.

**Состояние: исправлено в прошивке.** Реестр `firmware/cfg_params.*` по ADR-0005: 43 дескриптора, 688 байт флеша (2,1 %). Запись идёт через него — поле должно существовать, размер совпадать, значение лежать в границах. Красный тест показывал ровно дефект: прежний код принимал `brake_rate_max = 0` и записывал его.

Границы взяты из устройства системы, не из вкуса: АЦП десятибитный — значит 0…1023; кривых отклика три — значит 0…2; каналов АЦП восемь; датчик ACS712-20A меряет до 20 А; темп торможения ноль означает отсутствие торможения — значит минимум единица. Где честной границы нет, стоит предел типа с пометкой `PARAM_FLAG_TYPE_MAX`: выдуманное «разумное» ограничение хуже отсутствующего, оно выглядит проверкой, не будучи ей.

**Не закрыто:** параметры с пометкой `PARAM_FLAG_TYPE_MAX` ждут замеров на железе — коэффициенты PID руля, таймауты связи, время до аварийного отключения по току. И веб по-прежнему пишет по сырому смещению: чтение реестра по UART и генерация формы — часть той же правки протокола, что и счётчики `uart_tx_dropped`/`uart_baud_reverts`.

---

### S-4. Нулевой ШИМ в режиме Fast PWM даёт импульсы

В Phase-Correct при `OCR = 0` выход постоянно в нуле — корректно. В Fast PWM при `OCR = 0` на выходе остаётся импульс шириной один такт каждый период (особенность ATmega328P). Профиль `SPORT` в дефолтах настроен на 15625 Гц; при переходе на Fast PWM «ноль» перестанет быть нулём.

Для контроллера мотора свойство «ШИМ = 0 означает выключено» должно быть гарантией, а не следствием выбранного режима. Сейчас оно не проверяется ни тестом, ни кодом.

---

### S-5. Лёгкое нажатие тормоза тормозит слабее, чем отпущенный газ

Найдено тестами `svc_ramp`, не исправлено.

`svc_ramp_update()` разводит два пути. Если `brake_value == 0`, замедление идёт со скоростью `decel_rate`. Если `brake_value > 0` — со скоростью `brake_decel_rate()`, линейно интерполированной от `brake_rate_min` до `brake_rate_max`. Обе скорости берутся из профиля, и во **всех** пяти ходовых профилях умолчаний `brake_rate_min` меньше `decel_rate`:

| Профиль | `decel_rate` | `brake_rate_min` |
|---|---|---|
| Eco | 400 | 300 |
| Normal | 600 | 400 |
| Sport | 800 | 500 |
| Reverse | 400 | 300 |
| Parent | 500 | 400 |

Численно на Eco, от 300 единиц ШИМ при контуре 100 Гц:

- газ отпущен, тормоз не нажат → 400/с = 4 ед/тик → **75 тиков, 0,75 с**;
- тормоз нажат на единицу (`brake_value = 1`) → 300 + 1200·1/1023 = 301/с → **100 тиков, 1,00 с**.

Касание тормоза удлиняет остановку на треть по сравнению с тем, чтобы не трогать его вовсе. Ребёнок нажимает педаль тормоза и едет дольше, чем если бы просто снял ногу с газа.

Причина в том, что `brake_rate_min` задумывался как «слабое торможение», но сравнивать его не с чем: путь тормоза начинается с нуля нажатия, а путь без тормоза стартует сразу с `decel_rate`.

Поведение зафиксировано тестом `test_light_brake_is_weaker_than_coasting` — тест утверждает то, что есть, а не то, что должно быть.

**Возможные решения (решает владелец, CLAUDE.md §5):**

| Вариант | Что делает | Чем платим |
|---|---|---|
| `brake_rate_min ≥ decel_rate` в дефолтах | нажатый тормоз никогда не слабее отпущенного газа | тормоз перестаёт иметь «мягкий» нижний край |
| Брать `max(decel_rate, brake_rate)` в коде | то же, но независимо от значений в EEPROM | настройка `brake_rate_min` ниже `decel_rate` молча перестаёт действовать |
| Ввести порог на нажатие | тормоз считается нажатым только с некоторого значения | добавляется ещё один параметр и ещё одна зона нечувствительности |

Рекомендация: второй вариант плюс проверка в реестре параметров — тогда обещание «тормоз не бывает слабее наката» держится кодом, а не аккуратностью дефолтов.

---

## 3. Точность управления

### T-1. Планировщик даёт систематический сдвиг, а рампа этого не знает

```c
uint32_t elapsed = now - tasks[i].last_run_ms;
if (elapsed >= tasks[i].interval_ms) {
    tasks[i].last_run_ms = now;      // ← не += interval_ms
    tasks[i].func();
}
```

`last_run_ms = now` вместо `+= interval_ms` означает: период всегда **не меньше** заданного и накапливает остаток. При интервале 10 мс и джиттере цикла реальная частота будет 90–99 Гц, а не 100.

При этом `svc_ramp` инициализируется числом `100` и считает, что вызывается ровно 100 раз в секунду:

```c
svc_ramp_init(CONTROL_FREQ_HZ);   // аккумулятор делит на 100
```

Значит `accel_rate = 200 PWM/сек` на самом деле даст 180–198 PWM/сек. Красивая целочисленная арифметика аккумулятора в `util_math` (которая протестирована и корректна) обеспечивает точность, которую система всё равно не выдерживает — потому что нижележащее допущение о постоянстве шага неверно.

~~То же касается `svc_speed_update(SPEED_FREQ_HZ)` — RPM считается из предположения, что прошло ровно 100 мс.~~ **Половина дефекта закрыта (ADR-0023):** скорость считается временем между импульсами и от частоты вызова не зависит вовсе. Параметр из сигнатуры убран, константа `SPEED_FREQ_HZ` удалена. Такт планировщика задаёт теперь только свежесть телеметрии.

Остаётся `svc_ramp`: там допущение о постоянном шаге по-прежнему живёт, и это уже вопрос безопасности — скорость нарастания ШИМ не должна зависеть от загрузки процессора.

**Два варианта решения, выбор архитектурный:**
- `last_run_ms += interval_ms` с ограничением догона — сохраняет среднюю частоту, но при перегрузке даёт пачку вызовов подряд;
- передавать в сервисы фактический `dt` — честнее, устойчивее к джиттеру, но меняет сигнатуры `svc_ramp_update` и `svc_speed_update`.

Для транспортного средства я бы выбрал второй: скорость нарастания ШИМ — параметр безопасности, он не должен зависеть от загрузки процессора.

Дополнительно: **пропуск дедлайна ничем не фиксируется**. Нет ни счётчика, ни флага. Методология: *«перечислимые исходы вместо молчаливых пустот»* — просроченный тик критической задачи это исход, у него должно быть имя и счётчик в телеметрии.

### T-4. Оборванный кадр съедает начало следующего

Найдено при написании тестов парсера, не исправлено.

`app_protocol.cpp` кадрирует поток по синхробайту и длине, но не имеет межкадрового таймаута. Если кадр оборвался — линия моргнула, мост перезапустился, — парсер остаётся в середине разбора и продолжает принимать байты как продолжение старого кадра.

Последовательность:

| Состояние парсера | Приходит | Что делает |
|---|---|---|
| жду младший байт CRC | `0xAA` — синхробайт нового кадра | принимает за младший байт CRC |
| жду старший байт CRC | длина нового кадра | принимает за старший байт CRC |
| проверка | — | CRC не сходится, сброс |

К моменту сброса голова второго кадра уже проглочена, и он теряется целиком. Проверено тестом: после оборванного кадра следующий не доходит, а доходит только третий.

**Худший случай:** на линии рядом с мощными моторами обрывы не единичны. Каждый обрыв стоит двух кадров вместо одного, а при частоте телеметрии 10 Гц это заметная доля. Для команд управления — хуже: команда «отпустить газ» может потеряться дважды подряд.

**Исправление:** межкадровый таймаут. Молчание дольше времени передачи самого длинного кадра означает конец кадра, что бы ни говорило состояние разбора. На 250000 бод кадр в 65 байт идёт 2,6 мс — порог в 10 мс даёт четырёхкратный запас и не мешает нормальному обмену.

Требует решения владельца: значение порога — параметр настроек, а сам таймаут меняет поведение приёма (`CLAUDE.md` §5).

---

### T-3. Переполнение счётчика оборотов может показать высокую скорость как низкую

Найдено при исправлении B-3, не исправлено.

`svc_speed.cpp` считает `rpm[] = pulses × freq × 60 / pulses_per_rev` и кладёт результат в `uint16_t`. При 12 импульсах на оборот и частоте 10 Гц значение `pulses = 65535` даёт 3 276 750 — это усекается до 65 486, то есть выглядит как правдоподобное большое число, а не как отказ.

Следом `kmh_x10 = avg_rpm × D × 1885 / 1 000 000` при таком `avg_rpm` и D = 200 даёт 2,47·10¹⁰ — переполнение `uint32_t`. Результат заворачивается в малое число.

**Худший случай:** помеха на линии энкодера приводит к тому, что быстро вращающееся колесо показывает низкую скорость. Родитель на телефоне видит, что машина едет медленно.

Реальные значения далеки от опасных: при 400 RPM и тике 100 мс это 8 импульсов, запас четыре порядка. Поэтому дефект не блокирующий. Но отказ здесь молчаливый, а `CONVENTIONS.md` §10 требует имени и счётчика.

**Исправление:** ограничить `rpm` сверху осмысленной величиной и считать срабатывания; величину взять из замеров на железе, а не выдумывать.

**Статус: закрыто (ADR-0023).** Счёт импульсов как способ измерения скорости удалён, вместе с ним исчез и путь переполнения через `pulses`. В новом расчёте тот же класс отказа возможен с другой стороны: фильтр дребезга пропускает период от 200 мкс, и при периоде 287 мкс точное `км/ч×100` равно 65 679 — усечение до `uint16` дало бы 143, то есть колесо на 17 422 об/мин показало бы **1,4 км/ч**. Вместо усечения стоит насыщение по пределу типа: упёршееся значение заведомо абсурдно и видно, завёрнутое — правдоподобно и невидимо. Настоящий потолок по-прежнему неизвестен и сузит границу после замеров. Проверено тестом `test_absurdly_fast_saturates_instead_of_wrapping`.

---

### T-2. Аккумулятор рампы общий для разгона, торможения и оттормаживания

`apply_step()` использует один `accum` для трёх разных скоростей. При переключении «разгон → торможение» дробный остаток от предыдущей скорости переносится в новый режим. Величина эффекта мала (< 1 единица ШИМ), но это скрытая связанность: три независимых процесса делят одно состояние.

---

### T-5. `svc_ramp_init(0)` — деление на ноль

Найдено тестами `svc_ramp`, не исправлено, сегодня недостижимо.

`util_ramp_accum_step()` делит на `ra->freq` без проверки. Сейчас `svc_ramp_init()` вызывается ровно один раз, из `EV_Controller.ino`, с `#define CONTROL_FREQ_HZ 100` — нулём частота стать не может.

По ADR-0017 изменяемые константы переезжают в настройки. В тот момент, когда частота контура станет полем `settings_t`, значение 0 станет достижимым по UART, а деление на ноль на ATmega328P не ловится — `__udivmodhi4` вернёт мусор, и рампа за один тик прыгнет на любую величину.

**Исправление:** при переносе частоты в настройки завести её в реестр `cfg_params` с нижней границей не меньше 1 и проверить `freq != 0` в `util_ramp_accum_init()`. Отдельной правки до этого переноса не требуется.

---

### T-6. Фильтр педали никогда не доходит до верхнего упора

Найдено тестами `svc_pedals`, не исправлено.

`util_ema_update()` делает шаг `filtered_fp + ((delta * alpha) >> 8)`. Сдвиг обнуляет шаг, как только `delta * alpha < 256`: при умолчании `alpha = 40` это `delta <= 6` сотых долей единицы АЦП. Фильтр замирает, не дойдя до цели.

Измеримое следствие: педаль, прижатую к верхнему упору калибровки (`pedal_gas_max = 1000`), сервис показывает как **1020 из 1023**, и в рампу при `max_pwm = 400` уходит 398, а не 400. Тот же вход с точным засевом фильтра даёт ровно 1023 — недобор даёт именно фильтр, а не калибровка или мёртвая зона.

Величина — 0,3 %, на поведение машины не влияет. Но «педаль в полу» перестаёт означать «полный ход», а это ровно тот сорт молчаливой неточности, который потом объясняет странные числа в телеметрии. Снизу эффекта нет: при движении вниз шаг округляется в минус, ноль достижим.

Зафиксировано тестом `test_ema_never_reaches_the_top`.

**Возможное исправление:** округление к ближайшему вместо усечения — `filtered_fp + ((delta * alpha + 128) >> 8)` для положительной дельты. Правка трогает фильтр педалей, поэтому решает владелец (CLAUDE.md §5).

---

### T-7. Кривая отклика из профиля не читает никто

Найдено тестами `svc_pedals`, не исправлено.

`drive_profile_t` содержит поле `pedal_curve` с документированным смыслом «переопределение кривой, `0xFF` = брать общую». Умолчания это поле заполняют: Eco и Reverse — `PEDAL_CURVE_QUADRATIC` с комментарием «спокойный отклик», Normal — `PEDAL_CURVE_LINEAR`.

Поле не читает ни один модуль. `svc_pedals_update()` профиля вообще не получает и всегда берёт глобальную `settings_t.pedal_gas_curve`. Сквозной поиск по прошивке даёт три места: объявление в структуре, присвоение в умолчаниях и дескриптор в реестре параметров — ни одного чтения.

Следствия:

- обещание «в Eco спокойный отклик» не выполняется, отклик везде одинаковый;
- веб может записать `pedal_curve` в профиль, получить `ACK` и не увидеть никакой разницы — это прямое нарушение правила «не отвечать ACK на невыполненное действие» (CLAUDE.md §7);
- поле занимает место в `settings_t` и в EEPROM, то есть уже вошло в раскладку.

Зафиксировано тестом `test_profile_pedal_curve_is_never_applied`.

**Возможные решения (решает владелец, CLAUDE.md §5):**

| Вариант | Что делает | Чем платим |
|---|---|---|
| Передавать профиль в `svc_pedals_update()` | поле начинает работать как обещано | сервис педалей получает зависимость от режима вождения |
| Разрешать `0xFF` заранее и передавать готовый номер кривой | то же, но `svc_pedals` о профилях не узнаёт | разрешение живёт в вызывающем коде, ещё одно место с логикой |
| Убрать поле из профиля | честная структура без мёртвых настроек | правка раскладки EEPROM и миграция |

Рекомендация: второй вариант. Кривую выбирает тот, кто уже знает текущий профиль, а `svc_pedals` остаётся в своём слое.

---

## 4. Полнота протокола

Сквозная проверка трёх слоёв показала расхождения:

| Команда | `app_protocol.h` | обработчик в прошивке | `server.py` | `protocol.js` |
|---|---|---|---|---|
| `SET_TELEM_RATE` | объявлена | **отсутствует** | есть в payload-builder | вызывается |
| `GET_TELEMETRY` | объявлена | **отвечает ACK, телеметрию не шлёт** | есть | есть |
| `GET_PARAM` / чтение настроек | **не существует** | — | — | — |

Первые две — мёртвые пути: JS может отправить команду, которая гарантированно вернёт NACK.

Третья важнее. **Прочитать настройки из контроллера нечем.** Следующая запланированная задача — вкладка Settings — требует «прочитать текущие значения → показать форму → записать изменённые». Первый шаг невозможен без новой команды и, вероятно, нового формата ответа (182 байта не влезают в один пакет с текущим `PROTO_MAX_PAYLOAD = 60` — нужна пагинация или чтение по полям).

Это ровно та находка, которую методология ловит **на бумаге**: раздел «Карта API: сценарии → команды и события» существует именно для того, чтобы экран, которому не хватает команды, вскрылся до написания кода.

Прочее по протоколу:
- нет номеров пакетов и сопоставления ACK с запросом — на RS485 рядом с моторами это понадобится;
- нет версии протокола в пакете — при обновлении прошивки старый веб будет молча неправильно разбирать телеметрию;
- `RSP_NACK` не имеет кода «не реализовано»;
- сохранение в EEPROM (`CMD_SAVE_SETTINGS`) не ограничено по частоте — веб может исчерпать ресурс ячеек (100 тыс. циклов).

---

## 5. Веб-часть

Структура правильная: `transport` / `protocol` / `store` / изолированные виджеты. Замена транспорта на ESP32 действительно потребует правки одного файла. Это решение окупится.

Дефекты:

**W-1. Графики пишут точку на любое изменение состояния.**
```js
store.subscribe((s) => this._push(s));   // charts.js
```
`store.appendLog()` тоже вызывает `_notify()`. Любое отладочное сообщение от контроллера добавляет лишнюю точку на все три графика. Ось времени перестаёт быть равномерной — а именно по ней предполагается сравнивать реакцию системы на нажатие педали. Нужна подписка на конкретный срез (телеметрию), а не на весь store.

**W-2. Счётчик «RX rate» считает уведомления store, а не пакеты** — по той же причине завышен.

**W-3. Нет авторизации и подтверждения происхождения команд.** Сейчас сервер слушает `localhost` — приемлемо. Но `--ws-host 0.0.0.0` открывает управление транспортным средством в сеть без единой проверки. Для ESP32 (ТЗ §3.3 требует пароль и защиту от несанкционированного запуска) это придётся проектировать заново. Лучше заложить границу доверия сейчас, чем встраивать её в готовый интерфейс.

**W-4. `ev_control.py` использует протокол v1** (`CMD_SET_SPEED`), которого в прошивке больше нет. Утилита нерабочая, но лежит в репозитории и упоминается в README как рабочая.

---

## 6. Сверка с методологией

Документ «Методология разработки v1.0» — сильный и применимый здесь почти целиком. Ниже — где проект ему соответствует и где нет.

| Принцип | Состояние |
|---|---|
| **Ядро отделено от интерфейса** | ✅ Соблюдён. Прошивка не знает про веб, веб — про Serial. |
| **Единственный писатель** | ❌ Нарушен для настроек: писать может любой пакет по сырому смещению, без валидатора. |
| **Расширяемость через контракты** | ⚠️ Частично. Слои разделены, но контракт «настройки» описан только структурой C, без схемы, разделяемой с клиентом. |
| **Опасные способности — за шлюзом** | ❌ Нет шлюза ни у настроек, ни у команд движения. |
| **Перечислимые исходы вместо молчаливых пустот** | ❌ Пропуск дедлайна, переполнение TX, потерянный байт 0xFF, невыполненная смена режима — всё молча. |
| **Осмысленные состояния вместо заглушек** | ❌ `drive_mode` захардкожен, `faults` всегда 0, токи всегда 0 — заглушки выдаются за данные. |
| **Система думает на глазах** | ❌ Интерфейс показывает намерение, а не состояние (режим, E-STOP). |
| **Держится сборкой, а не памятью** | ❌ CI нет. Правило «в сервисах нет Arduino.h» соблюдается (проверил), но ничем не закреплено. |
| **Property-тесты инвариантов там, где цена ошибки — данные/безопасность** | ❌ Протестировано ровно то, что и так корректно. Комбинатор педалей — модуль, решающий, поедет ли машина, — не покрыт ни одним тестом. |
| **Эталонные фикстуры** | ❌ Формула скорости не имеет ни одной проверочной точки; ошибка в 3,6 раза жила в комментарии-«проверке». |
| **ADR-культура** | ❌ Решений принято много (комбинатор педалей, слоистая модель, 4 слоя, бинарный протокол, vanilla JS), ни одно не записано как ADR с отклонёнными альтернативами. |
| **Definition of Done наблюдаемым поведением** | ❌ «Готово» означало «код написан». Ни один MVP не имеет критерия приёмки, который можно показать. |
| **Доверие ступенями (read-only → планы → действия с откатом)** | ❌ Пропущено. Первая же версия веб-интерфейса умеет двигать машину. Разумнее было начать с режима наблюдения. |

Самое ценное, что даёт методология этому проекту, — **порядок фаз**. Здесь фактически прыгнули из ТЗ сразу в архитектуру и код, пропустив «сценарии по экранам» и «карту API». Обе пропущенные фазы вскрыли бы дефекты B-4 (режим), раздел 4 (нет чтения настроек) и S-1 (E-STOP как состояние, а не значение) **на бумаге, за час**.

---

## 7. Что в проекте сделано хорошо

Это не формальность — перечисленное ниже не надо трогать при исправлениях.

- **Изоляция платформы в одном файле** — сделана честно. Проверено: ни один сервисный модуль не включает `Arduino.h` или `avr/io.h`. Портирование на STM32 действительно сведётся к замене `hal_atmega328p.cpp`.
- **Настройки в EEPROM с magic + version + CRC16** и корректным откатом к дефолтам при повреждении. Проверено тестом с порчей байта.
- **Слоистая модель педалей с настраиваемым комбинатором** — сильное продуктовое решение. Оно точно описывает реальный сценарий («родитель подтормаживает, отпускает, ребёнок едет дальше») и делает его настраиваемым без перепрошивки. Это лучшая идея в проекте.
- **Целочисленная арифметика везде**, аккумулятор рампы с точной средней скоростью, PID с anti-windup — реализовано корректно и покрыто тестами.
- **Модульность фронтенда** с абстрактным транспортом — окупится при переходе на ESP32.
- **Документация** — подробная и структурированная. Проблема не в её отсутствии, а в том, что она местами описывает намерение как факт (watchdog в таблице задач, «не используем digitalWrite» при том, что HAL им и реализован).

---

## 8. План исправлений

### Очередь 0 — до любого включения на столе
Без этого проверять нечего.

1. ~~`MICRO_UART.cpp`: включить `cfg_board.h`, вернуть проверку переполнения TX, добавить счётчик отброшенных байт.~~ **Сделано** — драйвер переписан по ADR-0018, буфер в `util_ring`, счётчик `util_ring_dropped`.
2. ~~Убрать сентинел 0xFF: `hal_uart_read()` → `int16_t` или чтение через `available()`.~~ **Сделано** — вместе с пунктом 1.
3. ~~Исправить формулу `kmh_x10`, добавить тест с тремя эталонными точками.~~ **Сделано** — выведена от физики. По ADR-0023 способ измерения сменился на период между импульсами; та же эталонная точка (300 об/мин = 11,3 км/ч) проверяется и в новом расчёте.
4. ~~Включить аппаратный watchdog + `wdt_reset()` в планировщике (с проверкой поведения загрузчика).~~ **Сделано наполовину (ADR-0022)** — задача `task_watchdog` и включение написаны, закрыты флагом `WATCHDOG_ENABLED = 0`. Остаётся прошить optiboot и поставить `1`: на стоковом загрузчике включение выводит плату из строя.
5. ~~Довести прошивку до состояния «собирается».~~ **Сделано** — `stddef.h`
   в `app_protocol.cpp`, `UART_BAUD_DEFAULT` вместо несуществующего
   `UART_BAUD_DEBUG`, карта каналов АЦП из `cfg_board.h` в настройки
   (ADR-0009). Остаётся подтвердить сборкой в Arduino IDE: скетч десктопом
   не покрывается.

### Очередь 1 — до первого запуска с мотором
5. E-STOP как защёлкивающееся состояние, снимаемое явной командой.
6. Watchdog тормоза не обнуляет тормоз (асимметрия fail-safe).
7. ~~Валидатор настроек: таблица дескрипторов полей с диапазонами; запись по идентификатору, не по смещению.~~ **Сделано наполовину** — реестр `cfg_params` проверяет запись по смещению (ADR-0005). Запись по идентификатору требует правки протокола и делается вместе с ней.
8. Смена режима: либо реально работает, либо честный NACK и веб это показывает.

### Очередь 2 — до расширения функциональности
9. Решить вопрос `dt`: фактическое время шага в `svc_ramp` и `svc_speed`; счётчик пропущенных дедлайнов в телеметрии.
10. Команды чтения настроек + версия протокола в пакете.
11. ~~Тесты на `svc_pedals`, `svc_speed` (эталонные точки), парсер протокола (битый CRC, обрыв пакета, мусор перед SYNC, байт 0xFF в payload).~~ **Сделано** — `test_svc_pedals.c` (54), `test_svc_speed.c` (18), `test_app_protocol.c` (20), `test_svc_ramp.cpp` (39). Все пять комбинаторов педалей покрыты, плюс кривые отклика, мёртвая зона и пересчёт в ШИМ. Тесты парсера нашли дефект T-4, тесты рампы — S-5 и T-5, тесты педалей — T-6 и T-7.
12. CI-сторож: «в `svc_*`/`util_*`/`cfg_*` нет `Arduino.h`/`avr/`», сборка тестов, прогон.

### Очередь 3 — процесс
13. Завести `docs/adr/`, записать задним числом принятые решения с альтернативами.
14. Написать пропущенные документы: сценарии по экранам и карту API (§1 методологии). Это займёт день и закроет вопрос «чего ещё не хватает в протоколе».
15. Definition of Done для каждого MVP — наблюдаемым поведением.

---

## 9. Незакрытые вопросы к владельцу

1. **`ENCODER_PULSES_PER_REV` и `WHEEL_DIAMETER_MM`** — сейчас 12 и 200 мм, оба выдуманы. Пока они неизвестны, скорость и одометр не имеют смысла. Замер: прокрутить колесо ровно на оборот, посчитать импульсы. По ADR-0023 формула стала точной, но масштаб задают именно эти две константы — точность измерения их не заменяет. Просится перенести обе в настройки (ADR-0017), чтобы калибровать без перепрошивки.
2. ~~**Скорость UART** — 9600 бод.~~ **Закрыто** — ADR-0015: 250000 бод (делитель ровный, ошибка 0,0 %). По ADR-0019 станет настройкой с испытательным периодом и откатом.
3. **Отладочный текст и бинарный протокол в одном порту** — работает случайно (ASCII не содержит 0xAA). Оставляем как есть или разводим по признаку сборки?
4. ~~**Поведение при переполнении TX**~~ **Закрыто** — ADR-0016: пакет отбрасывается целиком и считается в счётчике потерь; счётчик уходит в телеметрию (ждёт ревизии протокола).
5. ~~**Загрузчик Nano** — старый или новый?~~ **Закрыто** — владелец ответил: старый, готов прошить optiboot. По ADR-0022 watchdog заведён под флаг `WATCHDOG_ENABLED = 0`; после смены загрузчика достаточно поставить `1`. Дефект **S-2** (а не B-4, как значилось здесь раньше) ждёт именно этого.
6. **Что должно происходить при потере связи с вебом** во время активного UART-газа: плавное снятие газа (сейчас) или ещё и подтормаживание?
7. **Кривая отклика из профиля не действует** (дефект T-7) — поле `pedal_curve` в `drive_profile_t` не читает никто, обещание «в Eco спокойный отклик» не выполняется. Три варианта разобраны в T-7; рекомендация — разрешать `0xFF` в вызывающем коде и передавать в `svc_pedals` готовый номер кривой.
8. **Лёгкое нажатие тормоза слабее отпущенного газа** (дефект S-5) — во всех ходовых профилях `brake_rate_min` меньше `decel_rate`. Три варианта правки с ценой каждого разобраны в S-5; рекомендация — брать `max(decel_rate, brake_rate)` в коде, чтобы обещание держалось кодом, а не аккуратностью дефолтов.
9. **Фильтр педали не доходит до верхнего упора** (дефект T-6) — педаль в полу даёт 1020 из 1023 и 398 ШИМ вместо 400. Величина 0,3 %, на поведение не влияет. Округлять к ближайшему в `util_ema_update()` или оставить как есть?

---

## 10. Итог

Проект не нужно начинать заново. Скелет выдержит и MVP-2, и MVP-3.

Но нужно принять, что **текущий код — это черновик, который никогда не исполнялся**, и относиться к нему соответственно: не «допилить фичи», а сначала довести до состояния «включается и не врёт», закрыв очереди 0 и 1.

Главный системный вывод: в проекте отсутствует механизм, который ловит расхождение между тем, что написано в документации, и тем, что делает код. Watchdog в таблице задач, но не в коде. Буфер 64 в конфиге, но 8 в сборке. Режим в интерфейсе, но не в контроллере. Скорость с формулой и «проверкой», но в 3,6 раза мимо.

Методология называет это одним предложением, и оно должно стать правилом проекта:

> **Держится сборкой, а не памятью.**
