Gsmads/EV-Controller/docs/METHODOLOGY.md

# Методология разработки: правила, выработанные на «Архивариусе»

**v1.0 — август 2026. Переносимый документ: не привязан к конкретному проекту. Происхождение — концептуальная фаза и срезы 0–2 «Архивариуса»; предназначение — следующий десктоп-проект и интернет-платформа. Кладётся в `docs/` каждого нового репозитория и служит стартовым контекстом для ИИ-ассистентов проекта.**

---

# Часть I. Фаза замысла

## 1. Комплект документов, где каждый проверяет предыдущий

Код не начинается, пока не собран комплект. Порядок не случаен — это цепочка проверок, и дыры вскрываются на бумаге, а не в коде:

1. **Концепция** — проблема, переформулировка цели, принципы, режимы работы. Принципы формулируются как критерии, по которым проверяется каждая будущая функция («нарушение — повод остановить merge»), а не как пожелания.
2. **Сценарии «по экранам»** — что человек видит и нажимает. Сценарии *проверяют концепцию*: механика, которую нельзя показать экраном, недодумана.
3. **Форматы данных** — файлы и пакеты, которыми проект говорит с миром (у «Архивариуса» — паспорт и экспортный пакет). Форматы проверяют переносимость: «тест выключенной программы» — ценность должна переживать сам продукт.
4. **Архитектура** — принципы, модули с зонами ответственности, контракты, стек с записью решения (ADR), вертикальные срезы. Не код: имена модулей и контракты обязательны, реализация — свобода исполнителя.
5. **Карта API: сценарии → команды и события** — каждый экран разложен на вызовы. Карта *проверяет полноту API*: экран, которому не хватает команды, вскрывается здесь. Раздел «Находки картирования» обязателен — каждый проектный документ отчитывается, что он вскрыл.
6. **Схема данных + нагрузки событий** — один документ: они определяют друг друга.
7. **Бриф-передача** — карточка проекта, инвентарь документов, решения в один экран, чек-лист первого сеанса, готовый стартовый промпт для ИИ-агента.

## 2. Правила ведения документов

- Каждый документ версионируется (v0.x) и начинается со строки изменений; шапка называет документы, на которые он опирается, с версиями.
- В каждом — раздел **«Принятые решения и открытые вопросы»**: решённое не перечитывается заново, открытое не теряется. При закрытии вопроса он переезжает в решения с формулировкой, а не удаляется.
- **Живые документы**: правило «изменил экран — обнови строку карты». Документы живут в `docs/` репозитория и правятся PR-ами наравне с кодом; чаты — архив, репозиторий — истина.
- Несколько сфокусированных файлов лучше одного мастер-тома: с ними удобнее работать и человеку, и модели.

## 3. Роли: владелец решает, ИИ предлагает

- Существенные решения — только владельца: смена обещания пользователю, новые зависимости, правки сторожей, контрактов и форматов. ИИ-ассистент оформляет **развилку**: варианты таблицей «что делает / цена», с рекомендацией и звёздочкой — но ждёт слова. Формула культуры: *«правка меняет обещание, данное пользователю, а такое походя не делается»*.
- Ответы владельца оформляются **документами-решениями**: вердикты по PR, ADR-проекты без номеров (номера — при слиянии), порядок применения. Документ кладётся в `docs/` — ассистент ссылается на него сам и не переспрашивает пройденные развилки.
- Отклонённые варианты записываются в ADR с причинами: следующий человек (или модель) не пройдёт этот круг заново.

# Часть II. Архитектурные принципы (переносимые)

1. **Ядро отделено от интерфейса.** Безголовый движок со стабильным API; GUI, CLI, будущие клиенты — равноправные потребители. В клиентах нет ни одного доменного решения.
2. **Единственный писатель.** У каждого критичного ресурса (данные пользователя, база) — ровно один модуль с правом записи; остальные — читатели или заказчики. Инвариант с одной охраняемой дверью проверяем; с десятью — нет.
3. **Всё длинное — возобновляемая задача** с чекпоинтами, прогрессом и переживанием перезапуска. **Чекпоинт хранит место, а не память**: восстановление — из хранилища по позиции, а не десериализация внутреннего состояния.
4. **Команды и события через шину.** Модули не импортируют друг друга; события — факты прошедшего времени; событие — единственный способ узнать, что что-то произошло. Реактивный интерфейс и наблюдаемость получаются из архитектуры, а не дописываются.
5. **Опасное — вне процесса.** Модели, распаковщики, конвертеры: изоляция памяти и сбоев, независимое обновление, лицензии вне нашего бинаря. Дочерний процесс падает — программа живёт.
6. **Опасные способности — за шлюзом.** Всё, что покидает машину (или иную границу доверия), проходит одну дверь с журналом и предпросмотром. Local-first / privacy обеспечиваются конструкцией, а не обещанием.
7. **Расширяемость через контракты.** Ядро знает интерфейсы («извлеки», «распознай»), не форматы. Плагины: декларативный манифест (идентичность, claims, permissions, схема настроек, точки вклада), ленивая активация, **вкладывают данные, а не виджеты** — интерфейс рисует вклад своими компонентами. Настройки плагина — схемой, страница настроек генерируется.
8. **Журнал — доменные данные.** Обратимость и история — часть модели, не логи. Всякое автоматическое действие видимо и откатываемо; прозрачность автоматики — условие её существования.
9. **Выводы — гипотезы, а не факты.** Всё, что произвёл ИИ или эвристика, хранится с уверенностью и основаниями («почему я так решил») и пересматривается при новых данных; пересмотры не стирают историю (цепочка supersedes). Поздний глубокий проход вправе отменить ранний быстрый.
10. **Перечислимые исходы вместо молчаливых пустот.** «Не прочитали» — это исход с именем (нет текстового слоя, защищён, не разобрать, упал, слишком большой), а не ноль байтов. Непрозрачные указатели: подсистема не выдумывает чужие абстракции («страницы» там, где их нет).
11. **Осмысленные состояния вместо заглушек.** Пустое значение либо объявляется состоянием с определённой семантикой, либо не существует. Один сбой не роняет массовый проход: пользователь просил тысячу результатов, а не сообщение об ошибке на первом битом.

# Часть III. Культура надёжности

**Главный лозунг: держится сборкой, а не памятью.** Любое правило, живущее только в голове или в тексте, однажды нарушат молча. Формы:

- **Сторожа на CI**: проверка границ ролей и зависимостей по графу; вопрос сторожа формулируется точно по обещанию («есть ли путь в обход плагина?», а не «есть ли путь?»). Сторож честно документирует, чего он не покрывает.
- **Отсутствие способности надёжнее запрета**: чего нет в сборке, нельзя сделать по ошибке. Где способность нужна одному месту — она живёт только там (dev-зависимости фикстур не попадают в поставку).
- **Ловушки записываются заранее**: если обещание держится случайностью (версии не слились), это фиксируется в ADR с правилом, какой PR имеет право её тронуть; где можно — намерение закрепляется манифестом (ограничение версии с комментарием-ссылкой).
- **Экзамен вместо доверия названию**: способности внешних компонентов (моделей, библиотек) проверяются прогоном при подключении, результат хранится в профиле.
- **Property-тесты инвариантов** там, где цена ошибки — данные пользователя, включая злые случаи (обрыв процесса посреди батча). **Эталонные фикстуры с известной разметкой** и **бенчмарк качества** для всего, где работает ИИ: смена модели — это цифра до и после, а не мнение.
- **Политика зависимостей**: PR обязан декларировать новые зависимости (зачем, лицензия, вес, альтернативы); решение — владельца; allowlist лицензий держит `cargo-deny`-класс инструмента. Пересмотр — один раз, перед открытием кода.

# Часть IV. Процесс

- **Монорепо**; роли пакетов (contract / platform / module / support / plugin / client) с проверяемыми правилами видимости; зависимости направлены только внутрь; каждый пакет собирается и тестируется отдельно.
- **ADR-культура**: одно решение — один короткий файл (контекст, решение, последствия, отклонённые варианты); разделы «Принятые решения» документов — готовые ADR-кандидаты.
- **Вертикальные срезы**: каждый срез — работающий продукт, названный продуктовой фразой («программа рассказывает, что у вас есть»). Инфраструктура, на которой стоит всё (шина, задачи, хранилище, исполнитель), пишется первой и обкатывается на безопасных срезах. **Не-цели среза перечисляются явно** — это защита от расползания.
- **План среза**: эпики → задачи с критериями приёмки, переносимые в issues один-в-один; чек-лист предпосылок от прошлых срезов (недостающее — долг с меткой, закрывается до зависимых эпиков); порядок итераций, каждая заканчивается демо; вопросы для сверки с реальностью.
- **Definition of Done** формулируется наблюдаемым поведением («задача возобновляется после перезапуска на глазах у пользователя»), а не «код написан».

# Часть V. Продуктовые принципы (переносимы шире, чем кажется)

- **Доверие зарабатывается ступенями**: сначала режим только-чтения с немедленной пользой, потом планы без действий, потом действия с откатом, и лишь затем — автономия. Ни на одном экране нет необратимого действия без явной воли.
- **Экономия внимания**: единица решения — группа, не элемент; «отложить» — легальный исход; программа не ставит человека перед стеной решений и не стыдит.
- **Информационная тишина** — ограничение дизайн-системы, а не пожелание: работа в фоне тихая, предложения копятся до сессии, исключения из тишины перечислимы.
- **Цена названа числом**: настройка, включающая дорогое (полное чтение, модальности), показывает стоимость — время, место, нагрузку. Осознанное решение вместо сюрприза.
- **Приоритеты — по данным, а не по догадке**: очередь поддержки форматов диктует отчёт слепых зон (сколько гигабайт реально не прочитано), петли обучения (правки, «это не то», отклонения) — материал правил, а не потерянные клики.
- **Система думает на глазах**: журнал действий агента, пометки пересмотров, объяснения результатов. Наблюдаемый ИИ вместо оракула.

# Часть VI. Мост к командной разработке

Для платформы на миллионы строк и независимых разработчиков всё выше остаётся в силе и *усиливается* — устная культура не масштабируется, поэтому доля правил, которые держатся сборкой, должна вырасти. Что добавится (предмет отдельного разговора, здесь — только направления): версионирование контрактов и событий как публичных API с гарантиями совместимости; владельцы модулей и RFC-процесс поверх ADR для межмодульных изменений; контрактные тесты между командами; шлюзы и сторожа как замена договорённостям «на словах»; бриф-передача — в форму онбординга. Принцип отбора любой новой практики тот же: *проверяемо ли это сборкой, и у какого решения один охраняемый вход?*

# Часть VII. Стартовый чек-лист нового проекта

1. Концепция v0.1 → итерации с владельцем до закрытия главных развилок.
2. Сценарии по экранам → находки → правки концепции.
3. Форматы данных (если проект говорит с миром файлами/пакетами).
4. Архитектура: принципы, модули, стек как ADR-1, срезы.
5. Карта API → находки → правки сценариев и архитектуры.
6. Схема данных + события.
7. Бриф-передача → репозиторий: `docs/` + `docs/adr/`, сторожа и CI с первого дня, срез 0.
8. Этот документ — в `docs/` рядом с остальными.
