Gsmads/EV-Controller/docs/SLICE_0_PLAN.md

# Срез 0: «Включается и не врёт»

**Версия:** 1.0 · 09.09.2026
**Опирается на:** `AUDIT.md` v1.0, `HARDWARE_BRINGUP.md` v1.3, `METHODOLOGY.md`, `CONVENTIONS.md`

---

## Цель среза

Довести систему до состояния, в котором **можно доверять тому, что она
показывает и делает**. Не добавить функциональность, а убрать расхождение
между заявленным и действительным.

Сейчас код никогда не исполнялся на железе, документация описывает три
разные версии системы, а четыре дефекта делают запуск невозможным.
Пока это так, любая новая функция строится на песке.

**Срез закрыт, когда:** машину можно поставить на подставку, подключить
веб-интерфейс, покрутить педаль — и всё, что видно на экране,
соответствует тому, что происходит в железе.

---

## Что НЕ входит в срез

Явно вынесено за пределы, чтобы не расползлось:

- электроусилитель руля;
- HC595, PCA9535, режимы движения с панели;
- защита по току;
- реестр параметров и вкладка настроек в вебе;
- ESP32 и всё, что на нём;
- электронный дифференциал, ABS, парктроники.

---

## Этап 0.1 — Аппаратная страховка

**Выполняется владельцем, до любой работы с кодом.**

Пока не сделано, каждый сброс контроллера подаёт на моторы команду полной
скорости, включая сброс по watchdog, который в этом же срезе включается.

| Задача | Действие |
|---|---|
| 0.1.1 | Резисторы 4,7–10 кОм с D9, D10, D6 на землю (сторона MCU) |
| 0.1.2 | Подтяжка `~STOP` к `GND_ISO` на изолированной стороне, обе стороны |
| 0.1.3 | Решить, какой уровень покоя у `BRAKE` — см. `HARDWARE_BRINGUP.md` A-5 |

**Критерий приёмки.** Осциллограф на `PWM_R_OUT`. Нажать reset на Nano.
На всём протяжении сброса и работы загрузчика уровень остаётся низким.
До правки на том же месте видно высокий уровень в течение одной-двух секунд.

**Основание:** ADR-0008, `HARDWARE_BRINGUP.md` A-4.

---

## Этап 0.2 — Репозиторий и сторожа

**Сначала проверки, потом исправления.** Иначе первое же исправление
окажется непроверяемым.

| Задача | Содержание |
|---|---|
| 0.2.1 | Инициализировать репозиторий, первый коммит — снимок как есть, без правок |
| 0.2.2 | Вторым коммитом добавить документы: `CLAUDE.md`, `docs/`, ADR |
| 0.2.3 | `.github/workflows/ci.yml`: сборка и прогон `tests/`, падение при любом failed |
| 0.2.4 | Сторож границ слоёв: `Arduino.h`, `avr/*` не встречаются вне `hal_atmega328p.cpp` |
| 0.2.5 | Сторож функций Arduino: `digitalWrite`, `analogRead`, `millis`, `delay` и прочие из списка ADR-0002 не встречаются нигде |
| 0.2.6 | Проверка, что `tests/` не содержит скомпилированных бинарников |

**Критерий приёмки.** Намеренно добавленный `#include <Arduino.h>`
в `svc_ramp.cpp` роняет сборку с внятным сообщением. После отката — зелёная.
То же для `digitalWrite` в любом файле сервисов.

Сторож должен в комментарии честно писать, чего он **не** покрывает —
например, что косвенное включение через третий заголовок он не поймает.

---

## Этап 0.3 — Блокирующие дефекты

Строго по одному дефекту на коммит. Каждый начинается с теста, который
воспроизводит проблему и краснеет.

### 0.3.1 — TX-буфер девять байт вместо шестидесяти четырёх

`MICRO_UART.cpp` не включает `cfg_board.h` и компилируется с умолчанием
`TX_BUFFER_SIZE = 8`. Пакет телеметрии — 41 байт. Из `serial_write`
удалена проверка переполнения, поэтому каждый пакет затирает сам себя.

**Развилка для владельца:** политика при переполнении.

| Вариант | Поведение | Цена |
|---|---|---|
| Блокировать до освобождения (как в Grbl) | Данные не теряются | Останавливает цикл управления на десятки миллисекунд |
| **Отбросить пакет целиком** ★ | Цикл не блокируется | Пакет теряется, но телеметрия избыточна |
| Отбросить байты | Проще | Битый пакет пройдёт как усечённый |

Рекомендация — отбрасывать пакет целиком и увеличивать счётчик потерь.
Счётчик уходит в телеметрию: у отказа должно быть имя (`CONVENTIONS.md` §10).

**Критерий приёмки.** Скетч шлёт телеметрию 10 Гц, Python-мост принимает
сто пакетов подряд без единой ошибки CRC.

### 0.3.2 — Байт 0xFF уничтожает пакет

`SERIAL_NO_DATA = 0xFF` — признак «буфер пуст», унаследованный от Grbl,
где по линии шёл текст. В бинарном протоколе 0xFF — обычные данные,
и `serial_read()` уже удалил байт из буфера, прежде чем вернуть его.

Следствие: команда `setGasVirtual(1023)` с полезной нагрузкой `FF 03`
не доходит никогда. Прочие команды теряются, когда 0xFF попадает в CRC.

Решение: `hal_uart_read()` возвращает `int16_t`, где −1 означает
отсутствие данных, либо чтение через `hal_uart_available()`.

**Критерий приёмки.** Тест разбора: пакет с байтом 0xFF в полезной
нагрузке разбирается корректно. На железе: `setGasVirtual(1023)`
приводит к ШИМ, равному максимуму профиля.

### 0.3.3 — Скорость занижена в 3,6 раза

Формула `RPM · D · 188 / 360000` вместо `RPM · D · 1885 / 1000000`.
Комментарий над ней содержит «проверку», подтверждающую неверный результат.

Одновременно: `ENCODER_PULSES_PER_REV` вводится через число пар полюсов,
чтобы исключить путаницу между «12 импульсов» и «12 пар полюсов»:

```c
#define MOTOR_POLE_PAIRS        12
#define ENCODER_PULSES_PER_REV  (3 * MOTOR_POLE_PAIRS)
```

**Критерий приёмки.** Тест с тремя эталонными точками, посчитанными
вручную. Для 300 об/мин и колеса 255 мм ожидается 14,4 км/ч.

### 0.3.4 — Аппаратный watchdog не включается

Реализован в HAL, не вызывается ниоткуда. `ARCHITECTURE.md` перечисляет
задачу сброса watchdog в таблице планировщика — в коде её нет.

Требует внимания к загрузчику: на старом загрузчике сброс по watchdog
может увести плату в бесконечный перезапуск. В начале инициализации,
до всего остального: сбросить флаг причины сброса и выключить watchdog,
затем включить заново с нужным периодом.

**Критерий приёмки.** Тестовый скетч с намеренным бесконечным циклом
в задаче: контроллер перезагружается через восемь секунд. Осциллограф
подтверждает, что ШИМ уходит в ноль и остаётся там (этап 0.1).

---

## Этап 0.4 — Дефекты безопасности

### 0.4.1 — Аварийная остановка снимается сама

`EMERGENCY_STOP` выставляет виртуальный тормоз в максимум, а watchdog
виртуальных педалей обнуляет его через 200 мс. Веб отправляет команду
однократно. Ребёнок с нажатой педалью газа поедет дальше.

Решение: аварийная остановка — **защёлкивающееся состояние**, а не
значение педали. Снимается явной командой. Watchdog на него не действует.

**Критерий приёмки.** Нажать E-STOP в вебе, закрыть вкладку, подождать
десять секунд, нажимать физическую педаль газа — ШИМ остаётся нулевым.
Снимается только явной командой снятия.

**Основание:** `AUDIT.md` S-1. Требует ADR.

### 0.4.2 — Асимметрия watchdog газа и тормоза

Один таймаут применён к величинам с противоположной логикой отказа.
Снятие газа при потере команд безопасно, снятие тормоза — нет.

Реализуется вместе с политикой из ADR-0006: различать «команда не
повторилась» и «линия мертва».

**Критерий приёмки.** Отключить сетевой кабель при нажатом виртуальном
тормозе — торможение продолжается. Отключить при нажатом виртуальном
газе — газ снимается за 200 мс.

### 0.4.3 — Настройки принимают любое значение

`cfg_settings_set_field` проверяет только выход за границы структуры.
`brake_rate_max = 0` отключает тормоз и сохраняется в EEPROM.

В рамках среза 0 достаточно **минимального валидатора**: таблица
диапазонов для полей, которые могут привести к опасному поведению.
Полный реестр параметров (ADR-0005) — задача следующего среза.

**Критерий приёмки.** Попытка записать нулевой темп торможения
возвращает `NACK`, значение в настройках не меняется.

### 0.4.4 — Смена режима не работает, но интерфейс показывает, что работает

Обработчик отвечает `ACK` и ничего не делает; профиль присваивается
однократно при старте; в телеметрии режим захардкожен.

Минимальное решение среза: обновлять действующий профиль в обработчике
и возвращать в телеметрии фактический режим. Полноценный конечный автомат
режимов с правилами переходов — срез 3.

**Критерий приёмки.** Выбрать Eco в вебе, нажать педаль до упора —
ШИМ не превышает предела Eco. Переключить на Sport — предел меняется.
Телеметрия показывает тот режим, который действует.

---

## Этап 0.5 — Точность управления

### 0.5.1 — Фактический шаг времени вместо предполагаемого

Планировщик присваивает `last_run = now` вместо `+= interval`, из-за чего
период всегда не меньше заданного и накапливает остаток. Рампа при этом
инициализируется числом 100 и считает, что вызывается ровно 100 раз
в секунду. Заявленный темп разгона 200 ШИМ/с фактически даёт 180–198.

**Развилка для владельца:**

| Вариант | Что делает | Чем платим |
|---|---|---|
| `last_run += interval` | Сохраняет среднюю частоту | При перегрузке даёт пачку вызовов подряд |
| **Передавать фактический `dt`** ★ | Темп не зависит от загрузки | Меняются сигнатуры `svc_ramp_update`, `svc_speed_update` |

Рекомендация — второй вариант. Темп нарастания ШИМ определяет, насколько
резко машина трогается под ребёнком; это параметр безопасности,
и он не должен зависеть от того, чем занят процессор.

**Критерий приёмки.** Тест: при заданном темпе 200 и шаге 10 мс за одну
секунду ШИМ вырастает ровно на 200. При искусственном джиттере шага
±3 мс результат остаётся в пределах ±2 единиц.

### 0.5.2 — Пропуск дедлайна получает имя и счётчик

Сейчас просроченный вызов критической задачи проходит молча.

Добавить счётчик пропусков на задачу и вывести суммарный в телеметрию.
`CONVENTIONS.md` §10: у любого отказа должно быть имя и счётчик.

**Критерий приёмки.** Задача, намеренно выполняющаяся 30 мс при интервале
10 мс, увеличивает счётчик, и это видно в веб-интерфейсе.

---

## Этап 0.6 — Ввод железа в строй

Замеры из `HARDWARE_BRINGUP.md`. Результаты вносятся в тот же документ.

| Задача | Замер | Что решает |
|---|---|---|
| 0.6.1 | Прозвонка HC595 (A-2) | подтверждение маппинга битов |
| 0.6.2 | Оптопары ШИМ на 8 и 16 кГц (A-3) | реализуемость профилей частоты |
| 0.6.3 | Соответствие аналоговых каналов (B-1) | калибровка педалей и токов |
| 0.6.4 | Диапазон АЦП после ОУ (B-2) | заводские значения калибровки |
| 0.6.5 | Фронт импульсов скорости (B-3) | настройка внешних прерываний |
| 0.6.6 | Импульсов на оборот, один поворот колеса (B-4) | скорость и одометр |
| 0.6.7 | Мёртвая зона моторов (B-5) | трогание с места |
| 0.6.8 | Версия загрузчика (D-1) | безопасность включения watchdog |

**Критерий приёмки этапа.** В `HARDWARE_BRINGUP.md` не осталось строк
со статусом «⬜» в приоритетах A и B. Заводские значения в `cfg_settings.cpp`
заменены на измеренные.

---

## Этап 0.7 — Синхронизация документации

Выполняется **последним**, когда протокол и поведение уже исправлены.
Раньше — значит писать дважды.

| Задача | Содержание |
|---|---|
| 0.7.1 | `PROTOCOL.md` привести к фактическому протоколу v2 |
| 0.7.2 | `ARCHITECTURE.md`: добавить слоистую модель педалей, `svc_speed`, убрать несуществующую задачу watchdog из таблицы |
| 0.7.3 | В шапку каждого документа — версия, дата, список документов-оснований с версиями |
| 0.7.4 | Сверить `MVP1_API.md` с фактическими сигнатурами |

**Критерий приёмки.** Выборочная проверка: пять произвольных утверждений
из документации подтверждаются кодом.

---

## Порядок выполнения

```
0.1 аппаратная страховка   ← владелец, до всего остального
      ↓
0.2 репозиторий и сторожа  ← до первого исправления
      ↓
0.3 блокирующие дефекты ──┐
      ↓                   │ можно параллельно
0.4 дефекты безопасности ─┘
      ↓
0.5 точность управления
      ↓
0.6 ввод железа в строй    ← требует стенда, часть можно раньше
      ↓
0.7 синхронизация документации ← последним
```

Этап 0.6 частично независим: прозвонку и осциллограф можно делать
параллельно работе с кодом. Но заводские значения калибровки правятся
после замеров, а не до.

---

## Критерий закрытия среза

Все пункты выполнены одновременно:

1. `make run` — 0 failed, тестов стало больше, чем 71.
2. CI зелёный, сторожа границ работают и проверены намеренным нарушением.
3. Ни одного «⬜» в приоритетах A и B `HARDWARE_BRINGUP.md`.
4. Машина на подставке: педаль газа вращает колёса, педаль тормоза
   останавливает, виртуальные педали из веба работают поверх физических,
   E-STOP останавливает и не снимается сам.
5. Показания в веб-интерфейсе соответствуют действительности: скорость
   совпадает с замером тахометром, режим совпадает с действующим профилем,
   счётчики отказов на нуле при нормальной работе.
6. Пять произвольных утверждений из документации подтверждаются кодом.

После этого можно браться за срез 1 — электроусилитель руля.
