Gsmads/EV-Controller/docs/adr/0022-watchdog-po-flagu.md

# ADR-0022. Аппаратный watchdog включается флагом, по умолчанию выключен

- Статус: принято
- Дата: 2026-09-13
- Решение владельца

## Контекст

Дефект S-2 аудита: `hal_system_wdt_enable()` существует в HAL, но не вызывается
ниоткуда. Аппаратный watchdog не работает. В `docs/ARCHITECTURE.md` задача
`wdt_reset` числится в таблице планировщика с тактом 10 мс — в коде её нет.

Просто включить watchdog нельзя. На стоковом загрузчике Arduino Nano это
приводит не к защите, а к выходу платы из строя:

1. watchdog срабатывает и перезагружает MCU;
2. управление получает загрузчик;
3. старый загрузчик **не выключает watchdog и не сбрасывает флаг WDRF**;
4. отсчёт продолжается с того места, где остановился, и watchdog срабатывает
   снова — до передачи управления скетчу дело не доходит;
5. плата в бесконечном цикле перезагрузок. Прошить по USB нельзя, потому что
   загрузчик не успевает принять команду. Выход — программатор по ICSP.

optiboot выключает watchdog и чистит `WDRF` в первых инструкциях, поэтому там
проблемы нет. Владелец подтвердил: загрузчик на плате старый, новый он готов
прошить, но не сейчас.

Отдельно: `hal_system_reset()` реализован тем же приёмом (`wdt_enable(WDTO_15MS)`
плюс вечный цикл) и на старом загрузчике так же выводит плату из строя. Сейчас
эта функция не вызывается ниоткуда.

## Решение

Аппаратный watchdog включается одним флагом `WATCHDOG_ENABLED` в `cfg_board.h`.
По умолчанию `0` — watchdog не включается ни при каких условиях.

При `WATCHDOG_ENABLED = 1`:

- таймаут 8 с (максимум ATmega328P);
- сброс делает **задача планировщика** `task_watchdog` с тактом 100 мс;
- `hal_system_wdt_enable()` вызывается последней строкой `setup()`, после всей
  инициализации, и сразу сопровождается первым сбросом.

Сброс делает именно задача планировщика, а не `loop()` напрямую. Смысл в
этом и состоит: если зависнет любая задача, планировщик до задачи сброса не
дойдёт, и MCU перезагрузится. Сброс в обход планировщика такой гарантии не
даёт — он продолжал бы работать, пока жив сам `loop()`.

Флаг компиляционный, а не настройка в EEPROM. Причина в цене ошибки: настройку
можно включить по UART из веба, находясь на старом загрузчике, и получить
неработающую плату без обратного хода. Компиляционный флаг требует осознанной
правки исходника и перепрошивки — а перепрошивка после смены загрузчика всё
равно неизбежна, так что удобства это не отнимает.

Такт 100 мс вместо 10 мс из `ARCHITECTURE.md`: при таймауте 8 с сброс раз в
100 мс даёт восьмидесятикратный запас. Сброс раз в 10 мс дал бы
восьмисоткратный и занял бы слот планировщика без выигрыша. Документ приведён
в соответствие.

## Критерий приёмки (проверяется на железе)

До включения:

- на стоковом загрузчике `WATCHDOG_ENABLED` равен `0`, и в прошивке нет ни
  одного вызова `wdt_enable()` на пути выполнения.

После прошивки optiboot и `WATCHDOG_ENABLED = 1`:

1. Машина едет, скорость и телеметрия идут — watchdog не мешает нормальной
   работе в течение не менее 10 минут непрерывно.
2. Во временно добавленную задачу вставляется `while (1) {}`. Наблюдаемо:
   ШИМ обнуляется, светодиод платы моргает стартом, телеметрия возобновляется.
   Время от зависания до возобновления — **не более 8 секунд** по секундомеру
   или осциллографу на выводе ШИМ.
3. Та же проверка при `WATCHDOG_ENABLED = 0` перезагрузки **не** даёт:
   машина остаётся в зависшем состоянии до снятия питания.

Пункт 2 и 3 вместе доказывают, что перезагружает именно watchdog, а не что-то
ещё.

## Последствия

- S-2 закрыт в той части, которая не требует железа: код есть, путь включения
  описан, случайное включение исключено умолчанием.
- B-4 (watchdog не включается) остаётся открытым до прошивки optiboot. Это
  теперь однострочная правка, а не задача.
- Расхождение `ARCHITECTURE.md` про задачу `wdt_reset` закрыто.
- Пока флаг равен нулю, зависание основного цикла по-прежнему ничем не
  лечится. Это осознанная цена: неработающая плата хуже зависшей, потому что
  зависшую спасает выключатель питания.

## Отклонённые варианты

**Включить watchdog безусловно.** Отклонено: на текущем загрузчике первое же
срабатывание выводит плату из строя, и восстановить её без программатора
нельзя.

**Сделать флаг настройкой в EEPROM.** Отклонено: включается по UART из веба,
в том числе по ошибке, и на старом загрузчике это необратимо. Выигрыш —
экономия одной перепрошивки, которая всё равно будет сделана при смене
загрузчика.

**Определять загрузчик из приложения и включать watchdog только на новом.**
Отклонено: надёжного способа нет. Признаки вроде «был ли WDRF сброшен» читаются
уже после того, как приложение получило управление, то есть после того, как
опасный сценарий не состоялся, — они говорят о прошлом, а не о будущем.
Получилась бы проверка, которая выглядит гарантией, не будучи ей.

**Сбрасывать watchdog в `loop()` после `app_scheduler_run()`.** Отклонено:
такой сброс продолжает работать, пока жив `loop()`, поэтому не ловит зависание
внутри задачи — то есть ровно тот случай, ради которого watchdog нужен.

**Таймаут меньше 8 с.** Отклонено на этом этапе: сначала нужно измерить на
железе, сколько реально занимает самая длинная задача (запись настроек в EEPROM
занимает до 3,3 мс на байт). Выдуманный таймаут, срабатывающий на штатной
операции, опаснее отсутствующего. Сужается после замеров.
