Gsmads/EV-Controller/docs/adr/0023-skorost-po-vremeni-mezhdu-impulsami.md

# ADR-0023. Скорость измеряется только временем между импульсами

- Статус: принято
- Дата: 2026-09-13
- Решение владельца

## Контекст

Скорость считалась подсчётом импульсов энкодера за окно планировщика:

```
об/мин = импульсов_за_окно × частота_окна × 60 / импульсов_на_оборот
```

При 12 импульсах на оборот и такте 10 Гц **один импульс равен 50 об/мин**,
то есть 1,9 км/ч при колесе 200 мм. Между 5,7 и 7,5 км/ч у такого способа нет
ни одного значения. Показать 7,4 км/ч он не может в принципе.

Владелец попросил показывать скорость с одним-двумя знаками после запятой —
«ребёнку интереснее». На счёте импульсов второй знак был бы выдумкой:
разрешение измерения в двадцать раз грубее той цифры, которую он изображает.

Обсуждался вариант оставить оба способа: счёт импульсов на низких скоростях,
период на высоких. Решение владельца: **не заводить два способа, тем более
когда один из них заведомо неточен.** Мощности ATmega328P достаточно, чтобы
измерять время точно.

## Решение

Скорость считается **только** по времени между соседними импульсами.

Обработчик прерывания на каждом фронте берёт метку `hal_system_micros()` и
запоминает разность с предыдущей меткой. Разрешение — 4 мкс (Timer0,
предделитель 64). На 400 об/мин период равен 12 500 мкс, то есть ошибка
измерения 0,03 % против 12,5 % у прежнего способа.

Формулы выведены от физики (вывод и проверочные числа — в шапке
`svc_speed.cpp`):

```
об/мин   = 60 000 000 / (период_мкс × импульсов_на_оборот)
км/ч×100 = D_мм × 1 131 000 / (период_мкс × импульсов_на_оборот)
```

Коэффициент `1 131 000 = 60 × π × 100 × 60` при точном 1 130 973,36 даёт
+0,0024 %. Километры в час считаются прямо из периода, а не из округлённых
оборотов: иначе округление происходило бы дважды и съедало ту самую десятую
долю, ради которой всё делается.

Подсчёт импульсов **остался**, но питает одометр. Пройденный путь — это
количество импульсов, умноженное на длину дуги; временем его считать нельзя.
Это не второй способ измерения скорости, а измерение другой величины.

### Что пришлось добавить вместе с периодом

**Фильтр дребезга.** При счёте импульсов лишний фронт от наводки добавлял доли
процента. При измерении периода один короткий интервал даёт выброс на порядок.
Фронт, пришедший раньше `ENCODER_MIN_PERIOD_US = 200 мкс`, не считается
импульсом вообще и увеличивает счётчик наводок. Граница выведена:
200 мкс при 12 импульсах на оборот — это 25 000 об/мин колеса, запас больше
тридцати раз к реальному потолку. Счётчик наводок доступен наверх и не
обнуляется: растущее значение означает проблему с проводкой, и это должно быть
видно (CLAUDE.md §7).

**Поправка на возраст измерения.** Если последний импульс был давно, настоящий
текущий период уже не меньше этого возраста. Поэтому в расчёт идёт
`max(измеренный период, возраст последнего импульса)`. Без поправки показание
замирало бы на последнем значении, пока колесо тормозит.

**Порог остановки.** Период длиннее `ENCODER_STOP_TIMEOUT_US = 500 мс` — это не
медленное движение, а остановка. Нижняя измеримая граница получается
`60 / (0,5 × 12) = 10 об/мин = 0,38 км/ч`. Медленнее машина честно показывает
«стоим». Тем же правилом без отдельного условия отсекается первый импульс
после простоя: его период охватывает весь простой.

**Три состояния вместо одного нуля.** `SPEED_NO_DATA` (импульсов не было с
запуска — стоящее колесо и молчащий датчик отсюда неразличимы),
`SPEED_STOPPED` (измерения были, сейчас колесо стоит), `SPEED_MOVING`.
Прежний код выдавал ноль во всех трёх случаях.

**Насыщение вместо усечения.** Это дефект T-3 в новом обличье. Фильтр
пропускает периоды от 200 мкс, и при периоде 287 мкс точное км/ч×100 равно
65 679 — в `uint16` не помещается. Усечение дало бы 143, то есть колесо на
17 422 об/мин показало бы **1,4 км/ч**. Быстрое выглядит медленным. Значение
ограничивается пределом типа: упёршееся в предел показание заведомо абсурдно и
видно, а завёрнутое — правдоподобно и невидимо. Настоящий потолок скорости
известен только после замеров на железе, выдумывать его здесь нельзя.

### Что изменилось в интерфейсе

`svc_speed_update()` больше не принимает частоту вызова. Измерение опирается на
метки времени, а не на интервал между вызовами, — от планировщика оно теперь не
зависит вовсе. Такт задаёт только свежесть телеметрии. Константа
`SPEED_FREQ_HZ` удалена: оставлять параметр, который ни на что не влияет,
значит обещать зависимость, которой нет.

Формат телеметрии не менялся: `speed_kmh_x10` как был `uint16`, так и остался.
Один знак после запятой помещается в него без правки протокола.

## Критерий приёмки

Десктопом (61 тест в `tests/test_svc_speed.c`):

- период 12 500 мкс даёт 400 об/мин и 15,1 км/ч; 25 000 — 200 и 7,5;
  6250 — 800 и 30,2. Все три посчитаны вручную от физики;
- точка, которой ловился B-3 (300 об/мин = 11,3 км/ч), даёт тот же ответ через
  период 16 667 мкс — смена способа физику не сдвинула;
- 400 и 410 об/мин различаются в показаниях (15,1 и 15,5 км/ч); прежний способ
  показывал бы их одинаково;
- показание падает по мере старения последнего импульса, а не замирает;
- на пороге 500 мс — `SPEED_STOPPED`, за такт до него — 10 об/мин и 0,4 км/ч;
- переполнение микросекундного счётчика не выглядит остановкой;
- период 287 мкс упирается в предел, а не заворачивается в 1,4 км/ч.

На железе (после подключения энкодеров):

1. Колесо прокручивается ровно на один оборот от руки — счётчик импульсов
   приращивается ровно на `ENCODER_PULSES_PER_REV`. Если нет — значение
   константы неверно, и до его уточнения скорость не имеет смысла (CLAUDE.md §8).
2. Машина катится с постоянной скоростью по размеченному участку: время
   прохождения мерного отрезка секундомером против показаний телеметрии.
   Расхождение больше 5 % означает ошибку в `ENCODER_PULSES_PER_REV` или
   `WHEEL_DIAMETER_MM`, а не в формуле.
3. Счётчик наводок за десять минут езды остаётся нулевым. Ненулевой —
   проблема проводки, и её видно до того, как она испортит показания.
4. Показания на постоянной скорости не дрожат больше чем на 0,2 км/ч. Дрожание
   означает неравномерный шаг прорезей диска — лечится усреднением по обороту
   (см. отклонённые варианты).

## Последствия

- Разрешение выросло с 1,9 км/ч до долей процента. Один знак после запятой
  теперь настоящий, а не изображаемый.
- Расчёт перестал зависеть от частоты вызова. Одним параметром и одним классом
  ошибок меньше.
- T-3 (переполнение счётчика оборотов) в прежнем виде исчез вместе со счётом
  импульсов; в новом виде закрыт насыщением.
- Появился фильтр дребезга со счётчиком — новая сущность, которой при счёте
  импульсов не требовалось. Это цена перехода, и она названа.
- `hal_system_micros()` добавлен в HAL. Реализован через Arduino `micros()`,
  то есть в списке исключений CI-сторожа стало шесть строк вместо пяти.
  Снимается вместе с остальными при отказе от ядра Arduino (задача #32).
- `ENCODER_PULSES_PER_REV` и `WHEEL_DIAMETER_MM` по-прежнему выдуманы. Точность
  измерения периода их не заменяет: формула теперь точная, но масштаб задают
  они. Пока не измерены, показания остаются непроверенными.

## Отклонённые варианты

**Оставить счёт импульсов и добавить период рядом.** Отклонено владельцем:
два способа измерения одной величины означают развилку в коде, два набора
ошибок и вопрос «какому верить» на каждой границе. Точность одного из них
заведомо недостаточна, поэтому выбор между ними не нужен.

**Усреднение по полному обороту** (кольцо из `ppr` последних меток, период
оборота как разность между импульсом N и N−ppr). Точнее: полностью снимает
ошибку неравномерного шага прорезей диска. Отклонено **на этом этапе**: стоит
64 байта ОЗУ из 2048 на два колеса, а выигрыш проявляется только если шаг
прорезей действительно неравномерен — это видно на железе за минуту (пункт 4
критерия приёмки). Вводить сейчас значит платить памятью за проблему, которой
может не быть.

**Экспоненциальное сглаживание показаний.** Отклонено на этом этапе по той же
причине: сглаживать нечего, пока не измерено дрожание. Вдобавок сглаживание
добавляет запаздывание, а коэффициент пришлось бы выдумать.

**Input Capture таймера 1.** Аппаратный захват точнее программной метки. Не
подходит: у ATmega328P один блок захвата на один вывод (ICP1/D8), а колёс два.
Вдобавок Timer1 занят ШИМ моторов.

**Отдельный таймер для меток времени (Timer2).** Отклонено: Timer0 уже
тикает ради `millis()`, и `micros()` берёт метку из него без единого лишнего
прерывания. Свой таймер с предделителем 64 дал бы то же разрешение 4 мкс ценой
977 прерываний в секунду и занятого Timer2.

**Хранить период в `uint16` (в единицах 4 мкс).** Экономит 4 байта на колесо.
Отклонено: потолок 262 мс на импульс означает нижнюю границу измерения
19 об/мин, то есть 0,72 км/ч. Порог остановки пришлось бы задирать под
ограничение типа, а не под физику.

**Выбрать потолок скорости и ограничивать им.** Отклонено: настоящий потолок
неизвестен до замеров, а выдуманный выглядел бы проверкой, не будучи ей.
Ограничение стоит по пределу типа и сузится, когда потолок измерят.
