Gsmads/EV-Controller/docs/adr/0021-hranilishcha-abstragirovany.md

# ADR-0021: Программа знает «постоянное» и «долговременное», а не PROGMEM и EEPROM

**Статус:** принято
**Дата:** 13.09.2026
**Заменяет:** —
**Уточняет:** ADR-0001, ADR-0003, ADR-0005

## Контекст

ADR-0005 требует держать таблицу дескрипторов параметров в PROGMEM: «около
12 байт на параметр, при 50 параметрах — 600 байт из 32 КБ». Альтернатива —
RAM, и она не проходит по бюджету: компактный дескриптор занимает 7 байт,
при 35 параметрах это 245 байт **из 2048**, то есть 12 % оперативной памяти
под таблицу неизменяемых констант.

Но доступ к PROGMEM — это `avr/pgmspace.h`, который по ADR-0001 разрешён
только в `hal_atmega328p.cpp`. Два принятых решения упираются друг в друга.

**Столкновение не новое.** Оно уже есть в коде: `app_debug.cpp` и
`EV_Controller.ino` используют `PSTR`, `PRINT.cpp` — `pgm_read_byte_near`,
и ни один из них не включает `avr/pgmspace.h`: имена приходили через
`Arduino.h`. Сторож границ это честно перечисляет в разделе «чего он
не покрывает»: использование платформенных имён без включения их заголовка
он поймать не может.

Владелец сформулировал правило шире, чем один случай: «хранение должно быть
абстрагировано от железа, программа просто сохраняет в долговременную память
и она не знает progmem, flash или ещё какая-то».

## Решение

Программа различает **два вида хранения по назначению**, а не по технологии.

| Назначение | Что там лежит | Интерфейс | Сегодня на ATmega328P |
|---|---|---|---|
| Постоянное | неизменяемые таблицы и строки, известные на этапе сборки | `util_rom.h` | PROGMEM |
| Долговременное | настройки, одометр — то, что переживает выключение и меняется | `hal_nvm.h` | EEPROM |

**Постоянное хранение.** `util_rom.h` даёт макрос размещения и функции чтения:

```c
UTIL_ROM static const param_desc_t params[] = { ... };
uint8_t  util_rom_read_u8(const void *addr);
uint16_t util_rom_read_u16(const void *addr);
void     util_rom_read_block(void *dst, const void *src, uint8_t len);
```

Реализация чтения — в слое железа, там же, где `pgm_read_*`. Сам макрос
`UTIL_ROM` раскрывается в атрибут компилятора на AVR и в пустоту на десктопе;
это единственное место вне HAL, где встречается платформенное условие.

**Долговременное хранение.** `hal_eeprom` переименовывается в `hal_nvm`:
имя `eeprom` называет технологию, которой на STM32F410 не будет — там
внутренняя flash с постраничным стиранием, а в проекте может появиться
и внешняя микросхема. Интерфейс от этого не меняется, меняется обещание:
«долговременная память», а не «EEPROM».

## Последствия

**Что становится проще.** ADR-0005 получает место для таблицы, не отнимая
12 % RAM. `app_debug`, `PRINT` и `EV_Controller.ino` перестают обращаться
к платформенным именам напрямую — снимается последнее исключение сторожа
границ и закрывается вторая половина задачи #31. Правило ADR-0001 становится
не только заявленным, но и соблюдаемым.

**Что становится сложнее.** Появляется `#ifdef __AVR__` вне HAL — в
`util_rom.h`. Это предикат компилятора, а не заголовок, и сторож на него
не среагирует; но платформенное условие всё же пересекает границу, и это
надо называть вслух, а не прятать. Взамен из трёх файлов уходят `PSTR`
и `pgm_read_byte_near`, то есть чистый итог — меньше платформенного кода
вне HAL, а не больше.

**Что мы обязаны поддерживать.** Порт на другую платформу реализует три
функции чтения ROM и переопределяет один макрос. Если у платформы единое
адресное пространство (STM32, ESP32), `UTIL_ROM` пуст, а чтение —
разыменование указателя; код выше не меняется вовсе.

**Чего решение не даёт.** Оно не переносит файлы платформы в отдельный
каталог. Плоская структура `firmware/` — требование Arduino IDE
(`CLAUDE.md` §4), и каталог с платформой упирается в смену системы сборки,
а не в расположение кода. Отдельный вопрос, отдельное решение.

## Отклонённые варианты

| Вариант | Почему отклонён |
|---|---|
| Таблица дескрипторов в RAM | 245 байт из 2048 под неизменяемые константы. Впереди кольца UART, реестр и стек; на 2 КБ такую трату не оправдать удобством |
| Включить `avr/pgmspace.h` в `cfg_params.cpp`, добавив исключение сторожу | Третье исключение в списке, который должен сокращаться. И оно закрепило бы платформенные имена в модуле, который платформы знать не должен |
| Оставить `PSTR` и `pgm_read_byte_near` как есть, абстрагировать только таблицу | Половина решения: правило ADR-0001 осталось бы нарушенным в трёх файлах, а сторож продолжал бы честно писать, что не ловит этого |
| Уменьшить дескриптор до 4 байт, чтобы влезть в RAM | Пришлось бы выкинуть min/max или сузить их до `uint8_t`. Диапазоны — единственное, ради чего таблица заводится; экономить надо не на них |
| Оставить имя `hal_eeprom` | Имя называет технологию. На STM32F410 это внутренняя flash, и модуль с таким именем читался бы как ошибка или требовал бы переименования тогда же, но уже задним числом |

## Проверка

1. `grep -rn "PSTR\|pgm_read" firmware/` находит совпадения только
   в `hal_atmega328p.cpp`.
2. `tools/ci/check_layer_boundaries.py all` зелёный без исключений
   по заголовкам: список ADR-0014 пуст.
3. `tools/ci/check_modules_compile.sh`: `PRINT.cpp` и `app_debug.cpp`
   компилируются на десктопе, из списка пропущенных убраны.
4. Тест: значение, размещённое через `UTIL_ROM`, читается через
   `util_rom_read_*` без искажения — на десктопе это проверяется как
   обычная память, на железе только на железе.
5. `grep -rn "hal_eeprom" firmware/ tests/` не находит ничего.
