Gsmads/EV-Controller/docs/adr/0015-skorost-uart-250000.md

# ADR-0015: Скорость UART — 250000 бод

**Статус:** принято
**Дата:** 13.09.2026
**Заменяет:** —
**Заменён:** —

## Контекст

Скорость UART числилась незакрытым вопросом: `CLAUDE.md` §8 отмечает «9600,
ТЗ §7.1 предполагает 115200 — решение владельца». В коде значение зашито
третьим местом: `firmware/MICRO_UART.h:41` объявляет `BAUD_RATE 9600`,
а `tools/gui/server.py:466` берёт 9600 умолчанием ключа `--baud`.

На 9600 линия загружена телеметрией на 42,7 %: пакет 41 байт уходит
42,71 мс при периоде 100 мс. Это не только медленно — это делает
недопустимым любой вариант поведения при переполнении буфера, кроме
отбрасывания (см. ADR-0016).

Делитель UART на 16 МГц даёт разную точность:

| Скорость | UBRR (U2X=1) | Фактическая | Ошибка | Байт | 41 байт |
|---|---|---|---|---|---|
| 9600 | 207 | 9615 | +0,16 % | 1041,7 мкс | 42,71 мс |
| 115200 | 16 | 117647 | **+2,12 %** | 86,8 мкс | 3,56 мс |
| 250000 | 7 | 250000 | **0,00 %** | 40,0 мкс | 1,64 мс |

250000 делится на 16 МГц нацело и при U2X=1 (UBRR=7), и без него (UBRR=3).
У 115200 ошибка +2,12 % с U2X и −3,55 % без. Формально 8N1 переносит
рассогласование до ~2,5 % на кадр, то есть 115200 работоспособна, но запас
съеден до нуля — а линия проходит рядом с мощными DC-моторами.
По той же причине 250000 выбрана штатной в Grbl и Marlin.

## Решение

Штатная скорость обмена контроллера — **250000 бод, 8N1**.

Значение должно быть объявлено **в одном месте** — `firmware/cfg_board.h`,
рядом с размерами буферов. Сегодня `MICRO_UART.h` объявляет его сам, потому
что не включает `cfg_board.h`; это же и есть первопричина дефекта B-1
(`docs/AUDIT.md`), и переезд константы выполняется вместе с его исправлением,
а не отдельной правкой.

`tools/gui/server.py` переводится на то же умолчание. Ключ `--baud` остаётся:
он нужен, чтобы подключиться к плате, прошитой другой версией.

**Чего это решение не определяет.** Оно задаёт значение, а не место хранения.
Переносить ли саму скорость в `settings_t` (то есть в EEPROM, с изменением
из веба) — отдельный вопрос: у него есть ловушка начальной загрузки, и он
решается в рамках ADR-0017, а не здесь.

## Последствия

**Что становится проще.** Запас по времени вырастает в 26 раз: пакет
телеметрии занимает 1,64 мс вместо 42,71, загрузка линии падает с 42,7 %
до 1,6 %. Появляется место под отладочную печать в том же UART и под
увеличение частоты телеметрии без переделки протокола.

**Что становится сложнее.** Прошивка и мост обязаны меняться вместе: плата
на 250000 и `server.py` на 9600 не увидят друг друга совсем, а симптом —
«порт открылся, данных нет» — тот же, что у дефекта B-1. Чтобы это не
диагностировали заново, `--baud` сохраняется, а рассогласование описывается
в `docs/HARDWARE_BRINGUP.md`.

**Что мы обязаны поддерживать.** Одно объявление скорости в прошивке.
Появление второго — повод для правки, а не для комментария.

**Чего решение не даёт.** Оно не проверено на железе. 250000 на длинной
линии RS485 с гальванической развязкой (ADM3491 + 6N137) требует замера:
оптопара 6N137 вносит задержку фронта, и на 250000 её вклад в 40 мкс
битовое время заметнее, чем в 1041 мкс. Пункт для `HARDWARE_BRINGUP.md`.

## Отклонённые варианты

| Вариант | Почему отклонён |
|---|---|
| 115200, как предполагает ТЗ §7.1 | Ошибка делителя +2,12 % при U2X и −3,55 % без него против 0,00 % у 250000. Работоспособно, но весь допуск 8N1 израсходован, а линия идёт рядом с силовой частью. Выигрыша взамен никакого: 3,56 мс против 1,64 мс на пакет — обе величины ничтожны против периода 100 мс |
| Оставить 9600 | Загрузка линии 42,7 %, пакет 42,71 мс. Отладочная печать и телеметрия в одном UART не помещаются; вариант «ждём» при переполнении стоил бы 67,71 мс — почти семь циклов управления |
| 500000 и выше | Делится нацело (UBRR=1 при U2X), но выигрыш против 250000 — 0,8 мс вместо 1,6 на пакет, то есть ничего при периоде 100 мс. Цена — вдвое меньший запас по джиттеру развязки, которую мы ещё не мерили. Поднять никогда не поздно |
| Скорость сразу в `settings_t` | Скорость — единственный параметр, ошибка в котором отнимает канал, через который его можно исправить. Требует отдельной защиты (безопасное умолчание, подтверждение с откатом) — это решение ADR-0017, а не побочный эффект выбора числа |
| Автоопределение скорости на стороне моста | Перебор скоростей в `server.py` спрятал бы рассогласование вместо того, чтобы его назвать. Отказ без имени — ровно то, что запрещает `CONVENTIONS.md` §10 |

## Проверка

Критерий приёмки — наблюдаемый, проверяется на железе вместе с B-1:

1. `grep -rn "9600" firmware/ tools/gui/` не находит объявлений скорости
   (вхождения в документации о прошлом состоянии допустимы и помечены).
2. Плата и `python server.py` без ключа `--baud` соединяются: мост
   принимает сто пакетов телеметрии подряд без единой ошибки CRC.
3. `server.py --baud 9600` против платы на 250000 не принимает ни одного
   валидного пакета и сообщает об этом явно, а не молчит.
4. Осциллограф на TX: битовое время 40 мкс ±1 %.
