Gsmads/EV-Controller/docs/adr/0016-politika-perepolneniya-tx.md

# ADR-0016: Политика при переполнении TX-буфера выбирается настройкой

**Статус:** принято
**Дата:** 13.09.2026
**Заменяет:** —
**Заменён:** —

## Контекст

Дефект B-1 (`docs/AUDIT.md`): из `serial_write()` удалена проверка заполнения
кольцевого буфера, которая есть в оригинальном Grbl. Там, где в Grbl стоит
`while (next_head == serial_tx_buffer_tail) { ... }`, в этом коде пустая
строка, и запись в полный буфер затирает неотправленные байты молча.
Второй половиной дефекта было то, что буфер вообще собирался размером
9 байт вместо 64 — `MICRO_UART.cpp` не включает `cfg_board.h`, где
`TX_BUFFER_SIZE 64` объявлен.

`docs/SLICE_0_PLAN.md` (задача 0.3.1) предлагал три поведения на выбор
владельца: блокировать, отбросить пакет, отбросить байты. Владелец выбрал
**два из них и возможность переключаться между ними из веба** — чтобы
сравнить на стенде, а не на бумаге.

Что изменилось с момента составления той развилки: ADR-0015 поднял скорость
до 250000. Это меняет цену блокировки на два порядка.

| | 9600 бод | 250000 бод |
|---|---|---|
| Ожидание одного байта | 1041,7 мкс | **40,0 мкс** |
| Пакет 41 байт в полностью занятое кольцо | 42,71 мс = **4,3 цикла управления** | **1,64 мс = 16,4 % периода** |
| Полное опустошение кольца (65 байт) | 67,71 мс | 2,60 мс |

На 9600 блокировка была неприемлема: цикл 100 Гц пропустил бы четыре такта,
то есть педали не опрашивались бы 43 мс. На 250000 худший случай — 16,4 %
одного периода. Ожидание при этом **ограничено сверху**: у TX нет аппаратного
управления потоком, приёмник не может притормозить передатчик, и кольцо
опустошается со скоростью линии независимо ни от чего.

## Решение

Поведение при переполнении TX задаётся настройкой `uart_tx_overflow_policy`
в `settings_t`, меняется из веба и сохраняется в EEPROM:

| Значение | Имя | Поведение |
|---|---|---|
| 0 | `TX_OVERFLOW_DROP_PACKET` | **умолчание.** Пакет не начинает записываться, если в кольце нет места под него целиком. Счётчик потерь растёт на единицу |
| 1 | `TX_OVERFLOW_BLOCK` | `serial_write` ждёт освобождения слота, как в Grbl. Счётчик потерь не растёт |

Отбрасывается **пакет целиком, а не байты**: усечённый пакет ушёл бы в линию
валидным по длине и был бы отброшен мостом по CRC — то есть отказ существовал
бы, но без имени.

**У отказа есть имя и счётчик.** Поле `uart_tx_dropped` — число отброшенных
пакетов с момента включения — входит в телеметрию и отображается вебом.
Этого требует `CONVENTIONS.md` §10: у каждого отказа имя и счётчик.
Ноль в этом поле означает «потерь не было», а не «мы не знаем».

**Отступление от правила «блокировка запрещена».** `CLAUDE.md` §3 правило 4 и
`CONVENTIONS.md` §1 правило 4 запрещают блокировку в цикле управления.
Режим 1 её вводит. Отступление от правил раздела 1 оформляется только через
ADR — настоящая запись и есть этот инструмент. Границы исключения:

- это ожидание готовности регистра UDRE, а не `delay()`: время ограничено
  скоростью линии, а не константой в коде;
- верхняя граница на вызов — одно байтовое время, 40 мкс;
- верхняя граница на пакет телеметрии — 1,64 мс при периоде 10 мс;
- умолчание — режим 0. Режим 1 включается сознательно, для сравнения.

## Последствия

**Что становится проще.** Оба поведения можно сравнить на одном стенде в один
день, переключая из веба, без перепрошивки. Это и была цель владельца.
Потеря пакета перестаёт быть невидимой: счётчик виден в телеметрии.

**Что становится сложнее.** Появляется настройка, неверное значение которой
влияет на реальное время. Поэтому режим 1 не должен становиться умолчанием
«само собой»: `cfg_settings_reset_defaults()` обязан выставлять 0, и это
проверяется тестом.

**Что мы обязаны поддерживать.**
- `SETTINGS_VERSION` поднимается 2 → 3, в `cfg_settings_migrate()` добавляется
  переход: настройки версии 2 читаются, новое поле получает умолчание 0.
  Иначе первый же запуск на плате с прошлыми настройками сбросит калибровку
  педалей — а её добывают замерами.
- Формат телеметрии растёт на поле `uart_tx_dropped`. Это изменение протокола;
  версия протокола и `docs/PROTOCOL.md` правятся тем же изменением.

**Где принимается решение об отбрасывании.** `serial_write()` работает с
отдельным байтом и границ пакета не знает — проверить «влезает ли пакет
целиком» внутри неё нельзя. Проверка свободного места делается там, где
длина пакета известна: перед началом передачи, в слое, который формирует
кадр. Байтовая функция остаётся байтовой, иначе решение об отбрасывании
принималось бы в середине уже начатого пакета — то есть тем самым
отбрасыванием байтов, которое отклонено ниже.

**Ссылки на номера строк устарели и больше не ставятся.** ADR-0014 ссылается
на `docs/CONVENTIONS.md:23`; после правки §1.1 (коммит сторожей границ) эта
строка съехала на :29. Сам ADR-0014 не редактируется — он принят. Вывод на
будущее: в ADR ссылаться на разделы, а не на строки.

**Чего решение не даёт.** Оно не отменяет вторую половину B-1: буфер обязан
собираться размером 64, то есть `MICRO_UART.cpp` обязан включить
`cfg_board.h`. Без этого политика будет применяться к кольцу в 9 байт,
куда пакет 41 байт не помещается никогда, и режим 0 отбросит все пакеты
подряд, а режим 1 заблокируется навсегда.

## Отклонённые варианты

| Вариант | Почему отклонён |
|---|---|
| Только отбрасывать пакет | Прямо противоречит просьбе владельца сравнить два поведения на стенде. Цена второго режима — одно поле настройки и ветка в `serial_write` |
| Только блокировать, как в Grbl | В Grbl по UART шёл текстовый протокол станка, а не цикл управления 100 Гц с педалями. Умолчанием блокировка быть не может: 16,4 % периода отдаются связи в худшем случае, и это при исправном канале |
| Отбрасывать лишние байты | Усечённый пакет уходит в линию валидным по длине; мост видит битый CRC и не может отличить его от помехи. Отказ без имени — `CONVENTIONS.md` §10 |
| Ожидание с таймаутом, затем отбрасывание | Разумный третий режим, но его не просили, а каждый режим — это ветка в коде, который исполняется в прерывании. Два режима отвечают на поставленный вопрос: сравнить крайности. Добавить третий после замеров дешевле, чем убрать лишний |
| Константа сборки вместо настройки | Сравнение двух поведений потребовало бы двух прошивок и перекомпиляции между замерами. Ровно то, от чего владелец уходит: настройка вместо перепрошивки |
| Счётчик потерь только в отладочной печати | Печать идёт в тот же UART и сама участвует в переполнении. Счётчик обязан быть в телеметрии, то есть в данных, а не в тексте |

## Проверка

Критерий приёмки — наблюдаемое поведение, не «добавлена настройка»:

1. **Красный тест до правки.** Тест `tests/test_micro_uart.c` с моком регистров
   UART: запись 41 байта в кольцо на 9 байт затирает начало пакета.
   Сегодня этот тест падает, потому что модуль не собирается вне Arduino IDE
   и не покрыт ничем.
2. Режим 0, кольцо заполнено: `serial_write` не пишет ни одного байта пакета,
   `uart_tx_dropped` увеличивается ровно на единицу, ранее записанные байты
   не изменились.
3. Режим 1, кольцо заполнено: запись завершается после освобождения слотов,
   ни один байт не потерян, `uart_tx_dropped` остался прежним.
4. `cfg_settings_reset_defaults()` выставляет режим 0.
5. Настройки версии 2 из EEPROM читаются после миграции: калибровка педалей
   сохранилась, новое поле равно 0.
6. На железе: мост принимает сто пакетов подряд без ошибок CRC (критерий
   приёмки 0.3.1 из `docs/SLICE_0_PLAN.md`), счётчик потерь равен нулю.
