Gsmads/EV-Controller/docs/adr/0019-skorost-uart-nastrojka-s-otkatom.md

# ADR-0019: Скорость UART — настройка с испытательным периодом и откатом

**Статус:** принято
**Дата:** 13.09.2026
**Заменяет:** —
**Заменён:** —

## Контекст

ADR-0017 ввёл правило владельца: изменяемая константа живёт в настройках,
а не в коде. Скорость UART под это правило подпадает — её подбирают опытом:
250000 на длинной линии RS485 через развязку 6N137 может не пойти, и тогда
её будут менять на площадке, а не в редакторе.

Но скорость — единственный параметр, ошибка в котором отнимает канал, через
который его можно исправить. Плата отвечает на 250000, веб спрашивает на 9600 —
и починить нечем, кроме программатора или стирания EEPROM. ADR-0017 оставил
этот вопрос открытым и запретил переносить скорость в настройки, пока у неё
нет названного пути восстановления.

Отдельно: `firmware/hal_uart.h:12` объявляет `hal_uart_init(uint32_t baud)` —
скорость в интерфейсе HAL уже параметр времени выполнения, а не константа.
Мешает только то, что вызывать его повторно сегодня некому и незачем.

## Решение

Скорость хранится в `settings_t` и меняется из веба **с испытательным
периодом**.

**Хранится кодом, а не числом.** Поле `uart_baud_code` — индекс в таблице
допустимых скоростей (9600, 19200, 38400, 57600, 115200, 250000, 500000),
а не `uint32_t`. Так значение валидно по построению: произвольное число
в поле попасть не может, диапазон проверяется реестром ADR-0005, и поле
занимает 1 байт вместо 4.

**Порядок смены.**

1. Веб присылает новый код скорости. Прошивка запоминает прежний код в RAM,
   применяет новый вызовом `hal_uart_init()` и включает испытательный период
   длительностью `uart_baud_probation_ms` (настройка, умолчание 10000,
   диапазон 2000…60000).
2. Веб закрывает порт, открывает заново на новой скорости и шлёт любой кадр.
3. **Любой принятый кадр с сошедшимся CRC подтверждает скорость.**
   Испытательный период заканчивается, значение становится обычным.
4. Если за `uart_baud_probation_ms` не пришло ни одного валидного кадра —
   прошивка возвращает прежний код, снова вызывает `hal_uart_init()` и
   увеличивает счётчик `uart_baud_reverts`.

**Сохранение в EEPROM во время испытательного периода запрещено.**
`CMD_SAVE_SETTINGS` отвечает `NACK` с кодом «идёт испытательный период».
Иначе неподтверждённая скорость пережила бы перезагрузку — то есть ровно
то, от чего защищает весь механизм.

**Счётчик отката — названный отказ.** `uart_baud_reverts` входит в телеметрию:
`CONVENTIONS.md` §10 требует, чтобы у отказа было имя и счётчик. Ненулевое
значение говорит «скорость пробовали поднять, и связь не выдержала» — это
диагностика линии, а не шум.

**Последний рубеж остаётся прежним.** Если CRC настроек в EEPROM не сошёлся,
`cfg_settings_init()` берёт умолчания, где скорость — 250000 (ADR-0015).
То есть даже испорченная EEPROM даёт предсказуемую скорость, а не случайную.

## Последствия

**Что становится проще.** Скорость подбирается на площадке за минуты, без
программатора и без перепрошивки. Неудачная попытка стоит `uart_baud_probation_ms`
секунд тишины и записи в счётчик — а не поездки за ноутбуком с ISP.

**Что становится сложнее.** Появляется состояние «идёт испытательный период»,
в котором часть команд отвечает `NACK`. Веб обязан его показывать, иначе
пользователь увидит необъяснимый отказ сохранения. И веб обязан переоткрывать
порт сам: без шага 2 подтверждения не будет никогда, и любая смена скорости
будет откатываться по таймауту.

**Что мы обязаны поддерживать.**
- Таблица допустимых скоростей — один источник. Добавление скорости в неё
  меняет смысл уже сохранённых кодов, поэтому скорости только дописываются
  в конец, существующие индексы не переставляются никогда.
- `SETTINGS_VERSION` поднимается вместе с полями `uart_baud_code`,
  `uart_baud_probation_ms` и миграцией со старой версии.
- Телеметрия растёт на `uart_baud_reverts` — это изменение протокола,
  оформляется вместе с `uart_tx_dropped` из ADR-0016 одной правкой формата,
  а не двумя.

**Чего решение не даёт.** Оно не спасает от ошибки на стороне веба: если веб
после смены скорости откроет порт на прежней, откат отработает и всё вернётся —
но пользователь увидит только «не сохранилось». Понятное сообщение об этом —
задача интерфейса, а не прошивки.

## Отклонённые варианты

| Вариант | Почему отклонён |
|---|---|
| Скорость остаётся константой сборки | Прямо противоречит правилу ADR-0017. Подбор скорости на длинной линии — ровно тот случай, ради которого правило вводилось: каждая попытка стоила бы перепрошивки |
| Поле `uint32_t` со свободным вводом | Значение 250001 приняли бы, делитель округлился бы, связь пропала бы без причины, видимой глазом. Код из таблицы делает неверное значение непредставимым |
| Подтверждение отдельной командой `CMD_CONFIRM_BAUD` | Честнее по смыслу, но добавляет команду в протокол ради того, что уже выражено: если кадр дошёл и CRC сошёлся — канал работает. Лишняя команда — лишний путь, который надо описывать и тестировать |
| Откат по отсутствию любого байта, а не валидного кадра | Помеха на линии RS485 рядом с моторами даёт байты без кадров. Подтверждение шумом — худший исход: скорость считается рабочей, а связи нет |
| Применять скорость только после перезагрузки | Убирает испытательный период, но возвращает исходную ловушку: неверное значение уже в EEPROM, и следующая загрузка уходит в тишину |
| Кнопка на плате для сброса к умолчаниям | Решает задачу, но требует свободного вывода и правки платы — а плата разведена. Останется запасным вариантом, если испытательный период окажется недостаточным |

## Проверка

1. Тест: смена кода скорости включает испытательный период; `CMD_SAVE_SETTINGS`
   в это время возвращает `NACK` с кодом «идёт испытательный период»,
   EEPROM не изменилась.
2. Тест: валидный кадр во время испытательного периода завершает его;
   после этого сохранение проходит.
3. Тест: истечение `uart_baud_probation_ms` без валидного кадра возвращает
   прежний код, `uart_baud_reverts` увеличивается на единицу.
4. Тест: байты без валидного кадра испытательный период не подтверждают.
5. Тест: код вне таблицы допустимых скоростей отвергается с `NACK`,
   настройки не изменились.
6. Тест: настройки прежней версии читаются после миграции, скорость
   получает умолчание 250000.
7. Наблюдаемо на железе: смена скорости из веба приводит к обрыву на
   доли секунды и восстановлению связи на новой скорости; смена на заведомо
   неработающую скорость приводит к возврату прежней через 10 секунд,
   и счётчик откатов в телеметрии равен единице.
