Gsmads/EV-Controller/docs/adr/0013-licenziya-gpl-v3.md

# ADR-0013: Лицензия проекта — GPL v3

**Статус:** принято
**Дата:** 10.09.2026
**Заменяет:** —
**Заменён:** —

## Контекст

Репозиторий был создан на GitHub с файлом `LICENSE`, содержащим Apache License 2.0
(коммит `adc4fc5`, до появления кода). Снимок кода лёг поверх этого файла
коммитом `8f16d9c`, лицензию никто не пересматривал.

При этом `firmware/MICRO_UART.cpp` и `firmware/MICRO_UART.h` — производные от
[Grbl](https://github.com/gnea/grbl), распространяемого под GPL v3. Это
зафиксировано в `README.md` («Лицензия и происхождение») и подтверждается кодом:
структура кольцевых буферов, имена `serial_write`/`serial_read`,
`SERIAL_NO_DATA`, обработчики `ISR(SERIAL_UDRE)`/`ISR(SERIAL_RX)` — всё это
адаптация оригинала, а не независимая реализация. Дефекты B-1 и B-2 из
`docs/AUDIT.md` — как раз следы этой адаптации: удалённая проверка переполнения
TX и сентинел 0xFF, унаследованный из текстового протокола Grbl.

GPL v3 требует, чтобы производная работа распространялась целиком под GPL v3.
Репозиторий, объявленный под Apache-2.0 и содержащий GPLv3-производные файлы,
внутренне противоречив: обещание лицензии не выполняется для части кода.

Пока репозиторий приватный, обязательства GPL не наступают — они возникают при
распространении. Но проект задуман открытым, а значит противоречие надо снять
до публикации, а не под давлением после неё.

## Решение

Весь репозиторий распространяется под **GNU General Public License v3**.
Файл `LICENSE` содержит полный текст GPL v3.

Происхождение `firmware/MICRO_UART.*` от Grbl сохраняется указанным в
`README.md`: авторство Sungeun K. Jeon и Simen Svale Skogsrud не снимается сменой
лицензии проекта.

## Последствия

**Что становится проще.**
Лицензия перестаёт противоречить содержимому: производные от Grbl файлы можно
держать в репозитории и распространять законно, не пряча происхождение.
Публиковать репозиторий можно в любой момент, отдельного решения это больше
не требует.

**Что становится сложнее.**
Любой, кто распространяет прошивку или устройство на её основе, обязан
предоставить исходный код своей версии на тех же условиях. Закрытое
коммерческое использование производных исключено. Для личного проекта, который
изначально задуман открытым, это не цена, а намерение; но решение необратимо
на практике: отозвать GPL у уже опубликованной версии нельзя, а перелицензировать
её потом можно только с согласия всех, кто внёс вклад.

**Что мы теперь обязаны поддерживать.**
Указание происхождения заимствованного кода при каждом новом заимствовании.
Новая внешняя зависимость проверяется на совместимость с GPL v3 до включения
в проект (`docs/CONVENTIONS.md` §9 — новые зависимости решает владелец).

**Что решение не меняет.**
Оно не привязывает проект к `MICRO_UART.*` навсегда. Задачи 0.3.1 и 0.3.2
(`docs/SLICE_0_PLAN.md`) в любом случае правят этот файл, и владелец допускает
его переписывание. Но переписывание — работа со своими сроками, а противоречие
в лицензии снимается одним файлом уже сейчас; одно другого не ждёт.

## Отклонённые варианты

| Вариант | Почему отклонён |
|---|---|
| Оставить Apache-2.0, переписав `MICRO_UART.*` с нуля | Требует написать свой драйвер UART до того, как лицензия перестанет противоречить коду. Работа предстоит в 0.3.1/0.3.2, но её объём и срок неизвестны, а противоречие существует уже сейчас. Кроме того, «переписал с нуля» — утверждение, которое трудно доказать для файла, начавшегося как адаптация: безопаснее снять вопрос лицензией, а переписывание вести по своим причинам (дефекты B-1, B-2), а не под давлением юридической необходимости |
| Оставить Apache-2.0 как есть | Обещание лицензии не выполняется для части кода. При открытии репозитория это ошибка, которую придётся исправлять публично и задним числом |
| MIT / BSD | Та же несовместимость с GPL v3, что и у Apache-2.0, плюс потеря явного указания на copyleft, которого требует происхождение кода |
| LGPL v3 | Смягчение имеет смысл для библиотеки, которую линкуют с закрытым кодом. Здесь распространяется прошивка целиком, отдельного «связывания» не происходит — различие не даёт ничего, кроме более сложного текста |
| Двойное лицензирование | Сложность без запроса: коммерческого интереса к проекту нет, а поддерживать два набора условий надо с первого дня |

## Проверка

- `head -2 LICENSE` печатает `GNU GENERAL PUBLIC LICENSE` и `Version 3, 29 June 2007`.
- `grep -rn "Apache" --include=LICENSE --include=*.md .` не находит ни одного
  утверждения о том, что проект лицензирован под Apache-2.0.
- Раздел «Лицензия и происхождение» в `README.md` называет GPL v3 лицензией
  проекта и сохраняет указание на Grbl и его авторов.
- GitHub на странице репозитория показывает «GPL-3.0» вместо «Apache-2.0»
  (определяется по содержимому `LICENSE` автоматически).
