Gsmads/EV-Controller/docs/adr/0008-bezopasnoe-sostoyanie-apparatno.md

# ADR-0008: Безопасное состояние по умолчанию задаётся аппаратно

**Статус:** принято
**Дата:** 2026-09-09

## Контекст
На стенде наблюдалось: при подаче питания и при перепрошивке оба колеса
раскручивались на максимальную скорость.

Причина найдена в топологии развязки. Светодиод оптопары 6N137 включён
анодом к +5 В через резистор, катодом — к выводу микроконтроллера. Ток
течёт, когда вывод выдаёт ноль. Пока вывод в высокоимпедансном состоянии —
при сбросе, во время работы загрузчика, до выполнения инициализации —
светодиод погашен, выход оптопары подтянут к высокому уровню, и драйвер
ZS-X11H воспринимает это как команду полной скорости.

На старом загрузчике окно составляет одну-две секунды при каждом сбросе,
включая сброс по watchdog, который планируется включать.

**Программно это не лечится:** инициализация выполняется после загрузчика.

## Решение
Принять правило: **любой выход, способный привести машину в движение,
имеет аппаратно заданный безопасный уровень на случай молчания
микроконтроллера.**

Конкретно сейчас:
- резисторы 4,7–10 кОм с выводов ШИМ (D9, D10, D6) на землю — при
  высокоимпедансном выводе светодиод открыт, выход оптопары в нуле,
  команда скорости нулевая;
- подтяжка `~STOP` к земле на изолированной стороне — драйвер отключён,
  когда содержимое сдвигового регистра не определено.

Правило распространяется на всё будущее: при добавлении любого нового
управляющего выхода определяется его безопасный уровень покоя и способ
его аппаратного задания.

## Последствия
- Самый опасный дефект системы закрывается тремя резисторами.
- Безопасность перестаёт зависеть от того, успела ли выполниться
  прошивка, и от версии загрузчика.
- Ограничение: `OE#` сдвигового регистра посажен на землю, поэтому его
  выходы активны всегда и подтяжки на изолированной стороне работают
  только при обесточенной стороне. Полное решение требует управления
  `OE#` от микроконтроллера через дополнительную оптопару — задача
  следующей ревизии платы.

## Отклонённые варианты
| Вариант | Почему отклонён |
|---|---|
| Инициализировать выводы раньше в прошивке | Загрузчик выполняется до любого пользовательского кода; окно не закрывается |
| Полагаться на подтяжки за сдвиговым регистром | `OE#` на земле, выходы регистра давят подтяжку; содержимое после включения не определено |
| RC-задержка на `OE#` | Не покрывает одну-две секунды старого загрузчика; медленный фронт на входе КМОП |
| Подтянуть `~STOP` к +5 В | Прямо противоположный эффект: `~STOP` активен низким уровнем, высокий разрешает драйвер |

## Проверка
Осциллограф на `PWM_R_OUT` в момент сброса контроллера: уровень должен
оставаться низким на протяжении всего сброса и работы загрузчика.
