Gsmads/EV-Controller/docs/images/1MCU.png

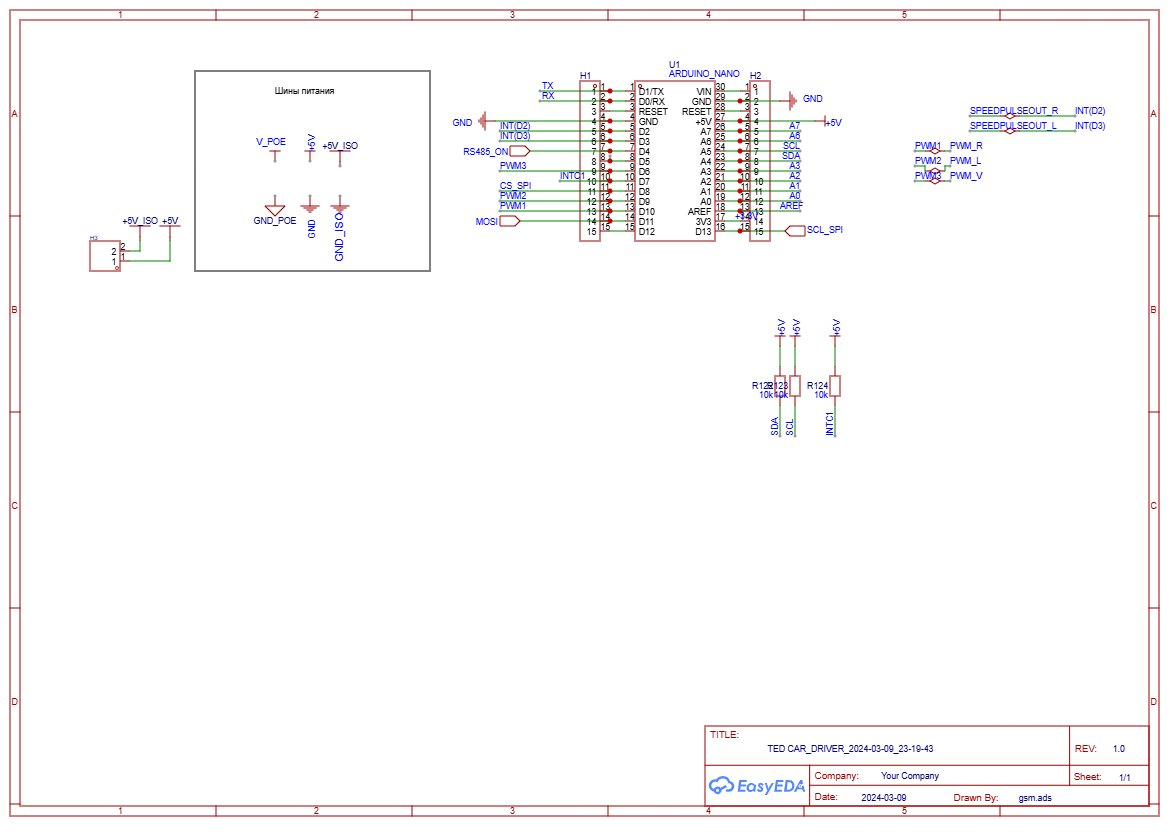
docs/images/1MCU.png
