Gsmads/EV-Controller/docs/images/2RS485_L1.png

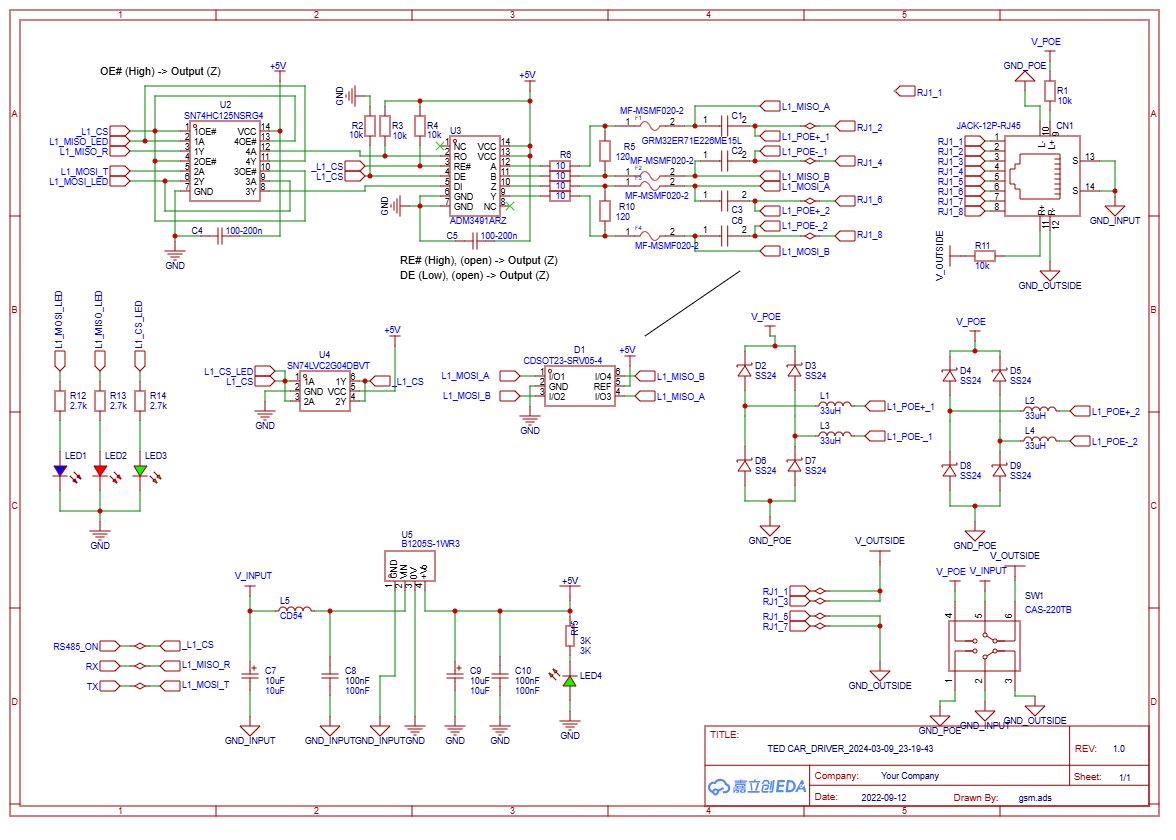
docs/images/2RS485_L1.png
