Gsmads/EV-Controller/docs/images/3Isol_IN_OUT_20260511.png

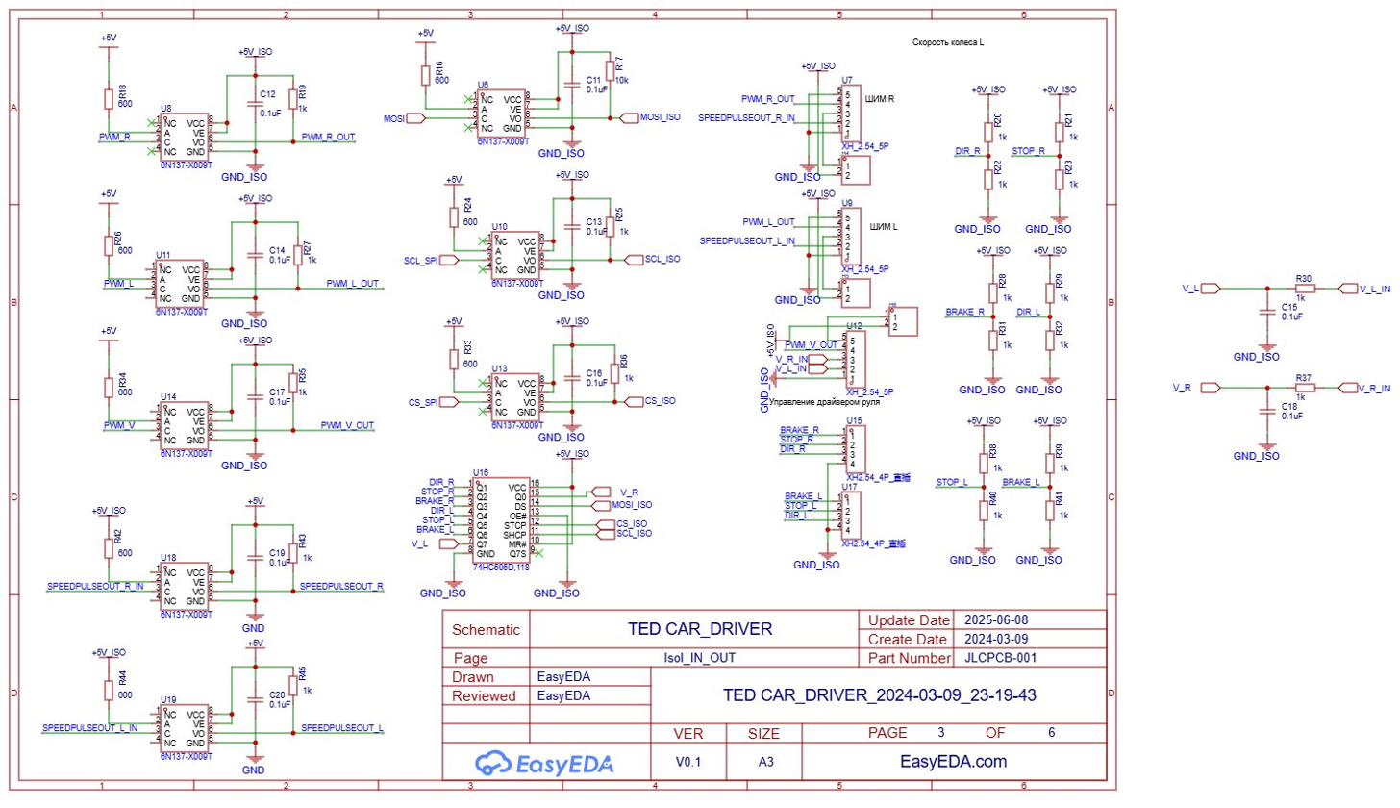
docs/images/3Isol_IN_OUT_20260511.png
