Gsmads/EV-Controller/docs/images/4Analog_input.png

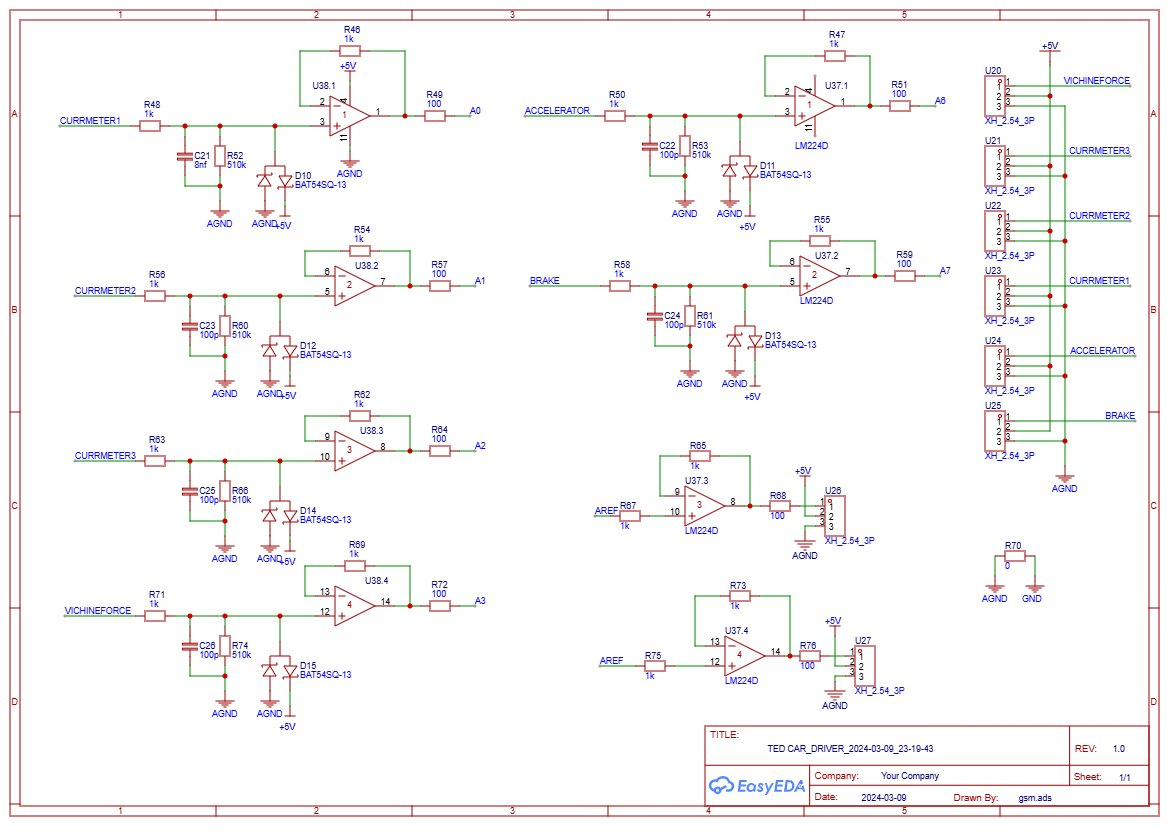
docs/images/4Analog_input.png
