Gsmads/EV-Controller/docs/images/5__Relay.png

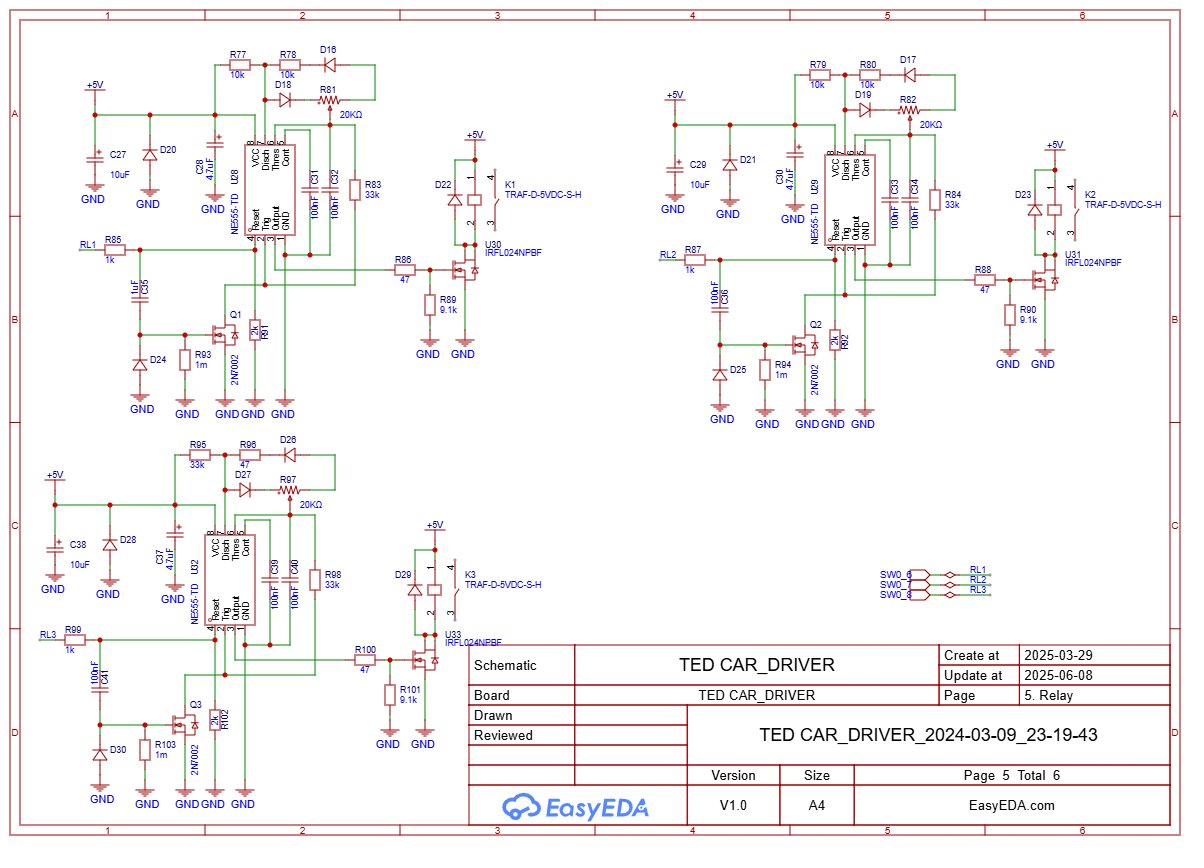
docs/images/5__Relay.png
