Gsmads/EV-Controller/docs/images/6IN_OUT.png

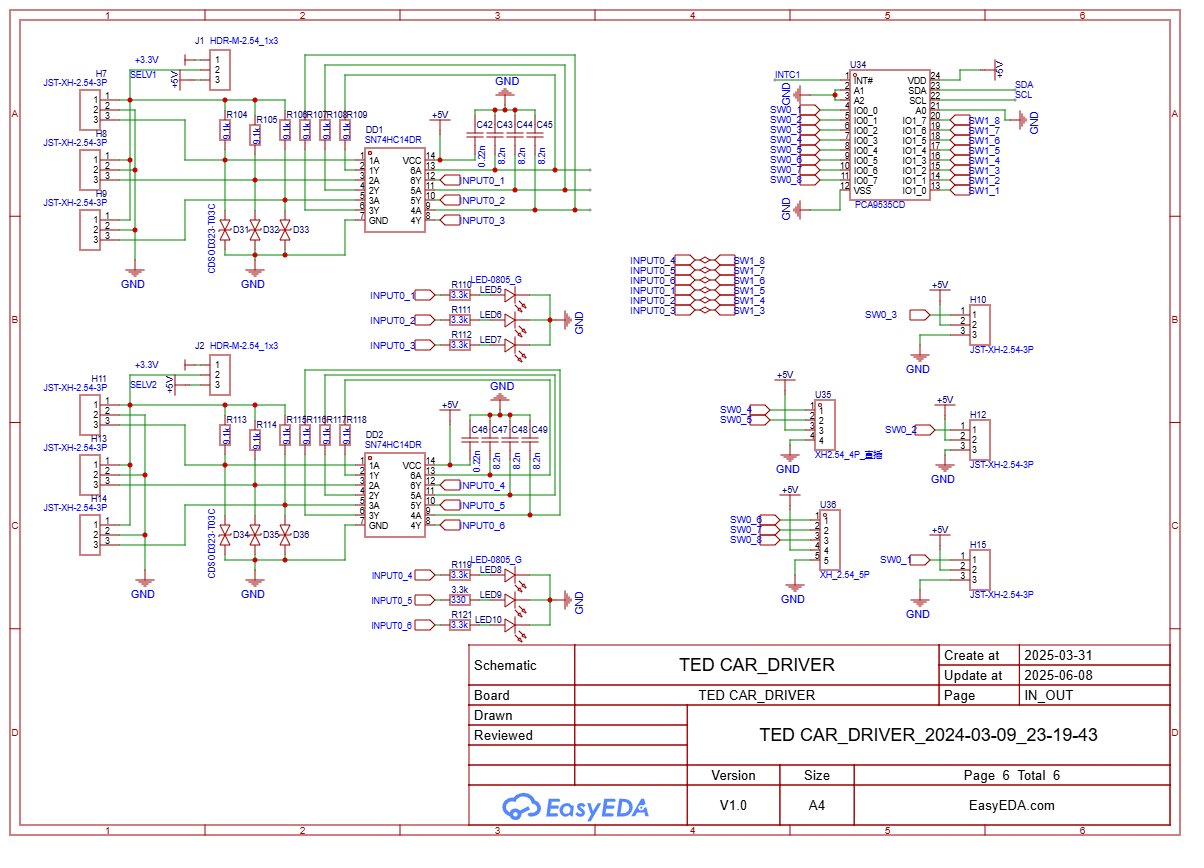
docs/images/6IN_OUT.png
