Gsmads/EV-Controller/docs/HARDWARE_BRINGUP.md

# Ввод железа в строй: что измерить до того, как писать код

**Версия:** 1.1 · 09.09.2026
**Опирается на:** `SCHEMATIC_ANALYSIS.md` v1.0, `EV_Controller_Specification.md`,
`AUDIT.md` v1.0, документация ZS-X11H (`Драйвер_BLDC.zip`), ранний код владельца 2023 г.

**Изменения v1.3:** цифровая распиновка подтверждена по схеме MCU и владельцем —
**совпадает с ТЗ**, вариант из `SCHEMATIC_ANALYSIS.md` ошибочен (новый раздел A-6);
D5 и D12 свободны, HX711 встаёт по исходному ТЗ; `OE#`=GND, `MR#`=+5V —
подтяжки на изолированной стороне работают только на обесточенной плате;
уточнена полярность `~STOP` (A-5).

**Изменения v1.2:** прочитана схема в высоком разрешении — маппинг HC595
совпадает с ТЗ (анализ ошибался); тракт ШИМ через 6N137 **не инвертирует**;
конденсаторы 0,1 мкФ — развязка питания, не нагрузка сигнала, полоса в порядке;
найдена причина самопроизвольного разгона при сбросе (новый раздел A-4);
пары полюсов 12 → 36 имп/оборот; B-2 уточнён до 614 (гарантированное значение).

**Изменения v1.1:** закрыт A-1 (реле — ШИМ-драйвер, не сторож); добавлен A-0
(паспорт ZS-X11H); переписан B-4 (формула импульсов на оборот, диаметр 255 мм);
добавлен B-4a (гибридный расчёт скорости); закрыт C-1 (ставим HX711,
A3 освобождается под положение руля); уточнён B-2 (клиппинг снизу).

---

## Зачем этот документ

Схема расходится с ТЗ по распиновке, полярности сигналов и составу датчиков.
Часть расхождений меняет код в одном файле, часть — блокирует целые MVP.

Пока эти вопросы не закрыты замером, любой написанный код — гипотеза.
Методология называет это «экзамен вместо доверия названию»: способность
компонента проверяется прогоном, а не тем, что написано в даташите или ТЗ.

Каждый пункт ниже: **что мерить → как → что это решает в коде**.
Результаты вписывать прямо сюда, в колонку «Измерено».

---

## A-6. Цифровая распиновка — ПОДТВЕРЖДЕНА

Прочитано со схемы `1-MCU.png` и подтверждено владельцем 09.09.2026.
Метки на разъёме H1 идут подряд; с учётом того, что D5 не разведён,
соответствие однозначно.

| Пин | Метка на схеме | Назначение | В `cfg_board.h` |
|---|---|---|---|
| D0 / D1 | `RX` / `TX` | UART + RS485 | ✅ |
| D2 | `SPEEDPULSEOUT_R` | INT0, скорость правого колеса | ✅ |
| D3 | `SPEEDPULSEOUT_L` | INT1, скорость левого колеса | ✅ |
| D4 | `RS485_ON` | DE/RE трансивера | ✅ |
| **D5** | — | **свободен** → HX711 `DOUT` | ✅ |
| D6 | `PWM3` → `PWM_V` | ШИМ руля (Timer0 OC0A) | ✅ |
| D7 | `INTC1` | прерывание PCA9535 | ✅ |
| D8 | `CS_SPI` | защёлка HC595 (STCP) | ✅ |
| D9 | `PWM2` → `PWM_L` | ШИМ левого мотора (Timer1 OC1A) | ✅ |
| D10 | `PWM1` → `PWM_R` | ШИМ правого мотора (Timer1 OC1B) | ✅ |
| D11 | `MOSI` | данные HC595 (DS) | ✅ |
| **D12** | — | **свободен** → HX711 `SCK` | ✅ |
| D13 | `SCL_SPI` | тактирование HC595 (SHCP) | ✅ |
| A4 / A5 | `SDA` / `SCL` | I²C, подтяжки R122/R123 10 к | ✅ |

**Вывод: `cfg_board.h` в проекте уже верен, цифровую часть менять не нужно.**
Распиновка из `SCHEMATIC_ANALYSIS.md` (D5=PWM_V, D6=INTC1, D7=CS_SPI)
**ошибочна**, использовать нельзя.

HX711 устанавливается ровно по исходному ТЗ: D5 = DOUT, D12 = SCK.
Переделка жгута не требуется.

Неизвестным остаётся только соответствие **аналоговых** каналов (B-1).

---

## Приоритет A — блокирует запуск моторов

### A-0. Паспортные данные ZS-X11H — ЗАКРЫТО документацией

Извлечено из описания драйвера (архив `Драйвер_BLDC.zip`). Эти факты больше
не нужно проверять, но нужно **соблюдать**.

| Параметр | Значение | Следствие для кода |
|---|---|---|
| Вход ШИМ | амплитуда 2,5–5 В, **50 Гц … 20 кГц** | Со стороны драйвера профили частот 4–18 кГц реализуемы. Ограничителем будет оптопара (A-3), не драйвер |
| `DIR` | активен **низким** уровнем | Замыкание на землю = задать направление |
| `STOP` | активен **низким** уровнем | Низкий = драйвер отключён, свободное вращение |
| `BRAKE` | активен **высоким** (5 В) | Высокий = замыкание обмоток |
| Питание +5 В с платы | **не более 50 мА** | Не запитывать от неё ничего постороннего |
| Максимум | 60 В / 350 Вт | Предельные, не рабочие |

**Требование безопасности прямо из документации:**

> Прямое и обратное направление не требуют задержки, а тормоз может иметь
> значительное воздействие; эти две функции невозможно использовать при
> высоком напряжении и на полной скорости. Принудительное включение может
> привести к повреждению силового транзистора и микросхемы, поэтому
> необходимо снизить уровень регулирования скорости **ниже 50 %**.

Это подтверждает и ужесточает §6.1 ТЗ. Наше правило (снизить ШИМ до нуля,
дождаться остановки колёс, выдержать паузу, только затем менять
`DIR`/`BRAKE`/`STOP`) строже паспортного — оставляем как есть. Но теперь у
требования есть паспортное основание, а не только здравый смысл: нарушение
жжёт силовой ключ драйвера.

**Выход тахометра `SC` (`D_SPED` на блок-схеме):** производитель помечает его
как «зарезервирован, техподдержка не предоставляется». Поведение проверять
эмпирически, на паспорт не опираться.

---

### A-1. Реле NE555 — ЗАКРЫТО

**Ответ владельца (09.09.2026):** NE555 работает как **ШИМ-драйвер реле для
экономии энергии**, а не как сторож. При включении на катушку подаётся полная
мощность для надёжного притягивания якоря, затем скважность снижается до
уровня удержания контактов. Классическая схема (в приложенном референсе
подстроечник помечен «Ток удержания»).

**Что это значит для прошивки:**
- сердцебиение **не нужно**;
- `drv_pca9535` просто выставляет уровень на SW0_6/7/8 и оставляет его;
- реле НЕ является страховкой от зависания MCU — при зависании с высоким
  уровнем на выходе PCA9535 питание моторов останется поданным.

**Следствие для безопасности:** аппаратной защиты от зависания в цепи реле
**нет**. Значит аппаратный watchdog ATmega (`AUDIT.md` S-2) остаётся
единственным программным рубежом, а физическая кнопка E-Stop, разрывающая
силовую цепь (ТЗ §8.1), — единственным аппаратным. Кнопка обязательна.

**Текущее состояние стенда:** питание подключено **в обход реле, вручную**.
Значит для отладки MVP-1 драйвер PCA9535 не нужен, моторы запитаны напрямую.
Цепь реле вводится отдельным этапом.

---

### A-2. Маппинг битов HC595 — ПРОЧИТАН СО СХЕМЫ

Обозначения на U16 (74HC595D,118, лист `Isol_IN_OUT`) читаются однозначно:

| Бит | Сигнал | Совпадает с ТЗ |
|---|---|---|
| Q0 | `V_R` — BTS7960 R_EN (руль вправо) | да |
| Q1 | `DIR_R` | да |
| Q2 | `STOP_R` | да |
| Q3 | `BRAKE_R` | да |
| Q4 | `DIR_L` | да |
| Q5 | `STOP_L` | да |
| Q6 | `BRAKE_L` | да |
| Q7 | `V_L` — BTS7960 L_EN (руль влево) | да |

**Маппинг из ТЗ верен. Вариант из `SCHEMATIC_ANALYSIS.md` (сдвиг на бит) —
ошибочен**, его использовать нельзя.

Прозвонку всё же выполнить: полчаса против риска перепутать тормоз
с направлением вращения. Но переписывать `cfg_board.h` под другой вариант
уже не нужно.

**Отдельно прозвонить `OE#` и `MR#` микросхемы U16** — см. A-4, от этого
зависит, работают ли подтяжки на активной плате или только на обесточенной.

**Прозвонено:** ____________________

---

### A-3. Оптопары на линиях ШИМ — РАЗОБРАНО ПО СХЕМЕ

Прежний анализ утверждал две вещи, обе оказались неверны.

**Инверсии нет.** Топология: `+5V → R18 (600 Ω) → анод 6N137`, катод — на пин
MCU. Светодиод открывается, когда MCU выдаёт НОЛЬ; выход 6N137 при
горящем светодиоде — LOW. Двойная инверсия сокращается:

```
MCU = HIGH  →  светодиод погашен  →  выход HIGH
MCU = LOW   →  светодиод горит    →  выход LOW
```

Тракт **неинвертирующий**, программная инверсия ШИМ не нужна.

**Конденсаторы 0,1 мкФ не в сигнале.** C12/C14/C17/C19/C20 включены между
`+5V_ISO` и `GND_ISO` рядом с каждым оптроном — это обязательная развязка
питания 6N137, а не нагрузка линии. Сигнальная цепь: подтяжка 1 кОм
(R19, R27, R35, R43, R45) к `+5V_ISO`.

При 1 кОм и паразитной ёмкости порядка 15 пФ фронт ≈ 30 нс. Драйвер по
паспорту принимает до 20 кГц (A-0). **Ограничения на профили частот
4–18 кГц нет ни с одной стороны.**

**Осциллографом подтвердить (не блокирующее):** скважность 50 % на 8 и 16 кГц,
посмотреть форму на `PWM_L_OUT`. Ожидается прямоугольник без завала.

**Проверено:** ____________________

---

### A-4. Самопроизвольный разгон при сбросе — НАЙДЕНА ПРИЧИНА

Владелец сообщал: при перепрошивке и при подаче питания колёса раскручивались
на максимальную скорость. Из топологии A-3 причина следует напрямую.

Когда пин D9/D10 находится в высокоимпедансном состоянии — при сбросе,
во время работы загрузчика, до выполнения `setup()` — катод светодиода висит
в воздухе, ток не течёт, светодиод погашен. Выход 6N137 подтягивается
резистором 1 кОм к `+5V_ISO` и стоит в **HIGH**.

Для ZS-X11H высокий уровень на входе регулировки скорости означает
**полную скорость**.

```
MCU в сбросе → пин Hi-Z → светодиод погашен → выход HIGH → полный газ
```

На старом загрузчике окно составляет 1–2 секунды при каждом сбросе,
включая сброс по watchdog.

**Программно не лечится.** `hal_pwm_init()` выполняется уже после загрузчика.

**Решение — аппаратное, два резистора:**
подтяжка **к земле** 4,7–10 кОм с пинов D9 и D10 (сторона MCU).
При высокоимпедансном пине катод притянут к нулю → светодиод горит →
выход LOW → драйвер видит нулевую команду.

То же для `PWM_V` — по подтверждённой распиновке это **D6**, не D5.
Топология оптопары идентична.

**Это единственный детерминированный способ.** Подтяжки на изолированной
стороне (A-5) не помогают, потому что `OE#` = GND и выходы 595 активны
всегда. Резисторы на стороне MCU не зависят ни от 595, ни от содержимого
регистра, ни от того, что успела выполнить прошивка, ни от загрузчика.

**Сделано:** D9 ______ · D10 ______ · D6 ______

---

### A-5. Подтяжки DIR / BRAKE / STOP — уровень покоя

На плате предусмотрены **парные посадочные места** по 1 кОм на каждый
сигнал: один резистор на `+5V_ISO`, второй на `GND_ISO`
(R20/R22 → DIR_R, R21/R23 → STOP_R, R28/R31 → BRAKE_R,
R29/R32 → DIR_L, R38/R40 → STOP_L, R39/R41 → BRAKE_L).
Запаивается **только один из пары** — он и задаёт уровень покоя.

**Ограничение:** выходы 74HC595 двухтактные. Пока `+5V_ISO` подано и `OE#`
активен, регистр давит своим уровнем, подтяжка 1 кОм проигрывает.
А содержимое регистра после подачи питания **не определено**.

Подтяжки действуют только когда:
- изолированная сторона обесточена, либо
- `OE#` переведён в высокий уровень (выходы в Hi-Z).

**Ответ владельца (09.09.2026): `OE#` = GND, `MR#` = +5 В.**

Значит выходы 595 активны **всегда**, в Hi-Z не уходят никогда. Уровень
на DIR/STOP/BRAKE в первые секунды после подачи питания задаёт случайное
содержимое регистра-защёлки, а не подтяжка.

Подтяжки сохраняют смысл только для случая «драйверы запитаны,
изолированная сторона ещё нет». Ставить стоит, но **проблему A-4
они не решают** — её решают только резисторы на стороне MCU.

**Полярность, чтобы не перепутать при пайке:**

| `~STOP` | Драйвер |
|---|---|
| LOW | остановлен, ключи отключены, колесо на накате |
| HIGH | **разрешён, исполняет команду ШИМ** |

Подтяжка `~STOP` к **+5 В разрешит драйвер по умолчанию** — вместе
с висящим ШИМ (A-4) это в точности наблюдавшаяся авария.
Запаивать резистор на **`GND_ISO`**.

**Что можно сделать в следующей ревизии платы:** вывести `OE#` на
управление от MCU через дополнительную оптопару и подтянуть его
к `+5V_ISO`. Тогда изолированные выходы гарантированно неактивны, пока
прошивка не задвинула в регистр осмысленное состояние. Сейчас свободных
оптопар нет, а RC-задержка на `OE#` не покроет 1–2 с старого загрузчика.

**Развилка — что запаять на BRAKE (решение владельца):**

| Вариант | Состояние покоя | Риск |
|---|---|---|
| STOP↓, BRAKE↓ | драйвер отключён, колесо на накате | на уклоне покатится |
| STOP↓, BRAKE↑ | обмотки замкнуты, колесо заблокировано | сброс **на ходу** = торможение на скорости; паспорт (A-0) прямо предупреждает о выгорании силового ключа |

Рекомендация: первый вариант. Накат безопаснее для железа, а удержание
на уклоне — задача осознанной команды BRAKE или механического ручника.
Сброс по watchdog на ходу — сценарий реальный, а не гипотетический.

**Решено:** ____________________

---

## Приоритет B — блокирует корректность данных

### B-1. Маппинг аналоговых входов

Анализ схемы прямо говорит: соответствие датчиков пинам определяется
кабельной разводкой между аналоговой платой и платой MCU, по схеме
не восстанавливается.

**Процедура:** по одному входу за раз подать известное напряжение
(потенциометр, 2,5 В) на разъёмы U20…U25, скетчем печатать все восемь
каналов АЦП, смотреть, какой шевелится.

| Сигнал на схеме | Разъём | Пин Arduino | Проверено |
|---|---|---|---|
| ACCELERATOR (газ) | U24 | | |
| BRAKE (тормоз) | U25 | | |
| CURRMETER1 | U23 | | |
| CURRMETER2 | U22 | | |
| CURRMETER3 | U21 | | |
| VICHINEFORCE (усилие руля) | U20 | | |

**Решение владельца (09.09.2026):** карта разъёмов принимается условной,
подключение выполняется по ней; при необходимости переставить провода
для удобства прокладки — соответствие переназначается из веб-интерфейса.

**Что из этого следует для архитектуры.** Переназначать из веба можно только
номера каналов АЦП: любой сигнал читается с любого входа, это просто индекс.
Функции, привязанные к аппаратуре, переставить нельзя ни из веба, ни вообще:

| Настраиваемо в рантайме | Жёстко в `cfg_board.h` |
|---|---|
| каналы АЦП: газ, тормоз, токи ×3, положение руля | ШИМ моторов — только OC1A/OC1B (D9/D10) |
| | энкодеры — только INT0/INT1 (D2/D3) |
| | I²C — только A4/A5 |
| | SPI — только D11/D13 |

Значит номера каналов АЦП переезжают из `cfg_board.h` в `settings_t`
(6 байт) и попадают в реестр параметров. Валидация обязательна:
номер канала < 8, два сигнала не на одном канале.

Правило для проекта: **аналоговые входы настраиваемые, цифровые функции — нет.**

---

### B-2. Реальный диапазон АЦП после ОУ

LM224D не rail-to-rail, питание 5 В. Расчётная передаточная функция
`V_out = 1,1·V_in − 0,5`, насыщение сверху ожидается около 3,5 В, то есть
примерно **716 из 1023**.

Про потерю **снизу** обычно забывают: при `V_in < 0,45 В` расчётный выход
отрицателен и упирается в ноль. Значит полезное окно датчика — примерно
**0,45 … 3,6 В** из диапазона 0–5 В. Для педалей это существенно: механику
надо расположить так, чтобы рабочий ход потенциометра попадал внутрь окна,
иначе часть хода будет «мёртвой» с обоих концов.

Владелец решил (09.09.2026) оставить 716 и питание 5 В. Поднимать питание ОУ
до 5,5 В смысла мало: опора АЦП всё равно AVCC = 5 В, выигрыш составит около
сотни кодов ценой отдельной шины питания. В следующей ревизии платы —
rail-to-rail ОУ (MCP6004 / LMV324).

**Процедура:**
1. Подать на вход канала газа 0 В → записать код АЦП.
2. Плавно поднять до 5 В, записать коды через каждые 0,5 В.
3. Найти точку, где код перестаёт расти (насыщение).

| V_in | 0 | 0,5 | 1,0 | 1,5 | 2,0 | 2,5 | 3,0 | 3,5 | 4,0 | 4,5 | 5,0 |
|---|---|---|---|---|---|---|---|---|---|---|---|
| ADC | | | | | | | | | | | |

**Что решает:**
- дефолты `pedal_gas_min` / `pedal_gas_max` (сейчас 10 и 1000 — недостижимы);
- пересчёт тока ACS712 в амперы;
- решение, где живёт передаточная функция ОУ (см. «Архитектурный вопрос» ниже).

---

### B-3. Полярность импульсов скорости через оптопару

Импульсы `SPEEDPULSEOUT_R/L` тоже идут через 8N137 и, вероятно, инвертированы.

**Процедура:** медленно прокрутить колесо рукой, осциллографом посмотреть
сигнал на D2/D3. Определить, активный фронт — нарастающий или спадающий.

**Что решает:** настройку `EICRA` в `hal_encoder_init()`. Сейчас стоит
нарастающий фронт для обоих каналов — это предположение, не факт.

**Измерено:** ____________________

---

### B-4. Импульсов на оборот колеса и диаметр

**Диаметр — вероятно уже известен.** В раннем коде владельца
(`01_EngineController.ino`, 2023) записано:
```c
uint8_t wDiam = 255;          // мм
float circumference = 800.7;  // мм   (π × 255 = 801,1 — сходится)
```
То есть **255 мм**, а не 200 мм, как стоит сейчас в `cfg_board.h`.
Перепроверить рулеткой по накачанному колесу под нагрузкой, но исходить из 255.

**Импульсов на оборот — теперь известна формула.** Из документации драйвера
(настройка внешнего тахометра): делитель = `пары полюсов × 3`, при 2 парах →
6. Делитель тахометра равен числу импульсов на механический оборот, значит:

```
импульсов на оборот = 3 × (число пар полюсов мотор-колеса)
```

Для мотор-колёс этого класса пар полюсов обычно 10–23, то есть ожидать надо
**30–70 импульсов на оборот**, а не 12. Число 12 в `cfg_board.h` взято с потолка.

**Процедура (всё равно проверить — SC «без техподдержки»):**
1. Пометить колесо и точку на корпусе.
2. Скетч печатает накопленные импульсы — поле `pulses` из `hal_encoder_take()`.
3. Прокрутить колесо ровно на один оборот рукой, записать прирост.
4. Повторить 3 раза — значения должны совпасть точно. Разброс означает,
   что теряются фронты (дребезг, полоса оптопары, неверный фронт в ISR).

**Измерено:** импульсов/оборот ______ · диаметр ______ мм · пар полюсов ______

---

### B-4a. Архитектурное следствие: как считать скорость

**Решено, ADR-0023.** Здесь раньше предлагался гибрид: счёт импульсов на
высокой скорости, период — на низкой, с порогом переключения в настройках.
Владелец этот вариант отклонил: два способа измерения одной величины означают
развилку в коде, два набора ошибок и вопрос «какому верить» на границе, —
тем более когда точность одного из них заведомо недостаточна.

Скорость считается **только** временем между импульсами, на всём диапазоне.
Дискретность больше не зависит от скорости: на 45 имп/оборот и 1 км/ч период
равен примерно 67 мс и меряется с разрешением 4 мкс, то есть с ошибкой
0,006 %. Прежняя оценка «1–2 импульса за окно» описывает именно тот способ,
от которого отказались.

Что из перечисленного в таблице осталось: таймаут, после которого показание
не «залипает», а становится честной остановкой. Он реализован строже —
показание падает по мере старения последнего импульса, а не держится до
самого порога (подробности в ADR-0023).

**Что здесь всё же надо проверить на железе:**

| Что | Зачем | Как |
|---|---|---|
| Равномерность шага прорезей | неравномерный шаг даёт дрожание показаний | на постоянной скорости показания не должны гулять больше чем на 0,2 км/ч |
| Счётчик наводок | фильтр дребезга отбрасывает невозможные фронты | `svc_speed_get_glitch_count()` за 10 минут езды должен остаться нулевым |
| Верхний предел | граница насыщения стоит по пределу типа, а не по физике | записать максимальные обороты, после этого границу можно сузить |

Если дрожание окажется заметным, лечится усреднением периода по полному
обороту — вариант разобран в ADR-0023 и отложен именно до этого замера.

---

### B-5. Мёртвая зона мотора

**Процедура:** колесо вывесить, подавать ШИМ от 0 с шагом 5, найти минимум,
при котором колесо начинает уверенно вращаться. Повторить для второго колеса.

**Измерено:** левое ______ · правое ______

---

## Приоритет C — блокирует MVP-2 (электроусилитель руля)

### C-1. Датчик положения руля — РЕШЕНИЕ ЕСТЬ

Конфликт был такой: ТЗ обещает на A3 положение руля, схема заводит на A3
усилие (`VICHINEFORCE`), а PID электроусилителя нуждается в **обоих** сигналах.

**Решение владельца (09.09.2026): ставим HX711.** Тензодатчик TZT на 1 кг уже
есть, установка недолгая. Тогда картина раскладывается без конфликта:

| Сигнал | Куда | Разрешение |
|---|---|---|
| **Усилие** на руле | HX711 (цифровой, `DOUT` + `SCK`) | 24 бита |
| **Положение** руля | освободившийся аналоговый канал `VICHINEFORCE` → A3 | 10 бит |

То есть в разъём U20, куда сейчас идёт аналоговый канал усилия, включается
датчик положения (Холл / потенциометр / аналоговый выход AS5600), а усилие
уходит на цифровой HX711. Жгут не переделывается, кондиционирование ОУ
достаётся датчику положения — ему оно как раз полезно.

**Свободные цифровые пины под HX711:** по схеме `D12` не используется
(MISO не нужен, HC595 только на запись) и `D8` помечен как «свободен?».
Кандидат: `D8` = DOUT, `D12` = SCK.

**Проверить до разводки:** действительно ли `D8` ни к чему не подключён на
плате MCU — в `SCHEMATIC_ANALYSIS` он со знаком вопроса. Прозвонить.

**Заметка по HX711 на 1 кг:** датчик считает до 1 кг, а усилие руля ребёнка
через рычаг может выйти за предел. Проверить механику: при упоре руля в
крайнее положение датчик не должен уходить в насыщение и тем более
испытывать перегрузку. Если выходит — либо сместить точку приложения, либо
взять датчик на 5 кг.

**Проверить:** D8 свободен ______ · предел 1 кг не превышается ______

---

### C-2. Timer0 и `millis()`

По схеме ШИМ руля переехал на **D5 = OC0B = Timer0**, а Timer0 в ядре Arduino
обслуживает `millis()`, `micros()`, `delay()`.

| Вариант | Частота ШИМ руля | Цена |
|---|---|---|
| Оставить Timer0 как есть | ~976 Гц | Слышимый писк мотора руля; `millis()` цел |
| Переконфигурировать Timer0 | любая | Свой системный тик на Timer2, `millis()` из ядра ломается |
| Перенести системный тик на Timer2 заранее | любая | Правка `hal_system`, отладка через Serial усложняется |

Для MVP-2 разумно начать с первого варианта: 976 Гц для редукторного
DC-мотора руля рабочая частота, писк терпим, а `millis()` трогать
на этом этапе рискованно.

**Решено:** ____________________

---

### C-3. Взаимоисключение полумостов BTS7960

Подтверждено владельцем: ШИМ подаётся **одновременно на оба входа**
`L_PWM` и `R_PWM`, направление задаётся раздельными сигналами `L_EN` / `R_EN`.

Отсюда жёсткое требование к драйверу: **`L_EN` и `R_EN` не должны быть
активны одновременно ни на один такт.** Одновременная активация при
поданном ШИМ на оба входа — сквозной ток через полумосты.

Реализовать в `drv_eps` как инвариант, недостижимый снаружи:
смена направления идёт только через последовательность
`оба выключены → пауза → нужный включён`. Пауза (dead-time) — параметр,
начать с 2 мс.

Проверить прогоном: на осциллографе не должно быть перекрытия
`V_L` и `V_R` ни в одном переходе.

---

## Приоритет D — до включения аппаратного watchdog

### D-1. Версия загрузчика Nano

На старых загрузчиках сброс по watchdog может увести плату в бесконечный
перезапуск: загрузчик не сбрасывает флаг `WDRF` и не выключает watchdog.

**Процедура:** в Arduino IDE выбрать «ATmega328P (Old Bootloader)» —
если прошивка заливается, загрузчик старый.

**Если старый:** либо перепрошить загрузчик на optiboot (владелец готов),
либо в начале `setup()` до всего остального:
```c
MCUSR = 0;
wdt_disable();
```

**Измерено:** ____________________

---

## Архитектурный вопрос, который закрывается этими замерами

Передаточная функция ОУ (`V_out = 1,1·V_in − 0,5`, насыщение ~716) и
инверсия оптопар — это **свойства конкретной платы**, а не бизнес-логики.

Значит им не место в `svc_pedals` и `svc_motor`. Правильный слой:

```
svc_pedals        получает нормализованные 0…1023, ничего не знает про ОУ
      ↑
drv_analog        применяет передаточную функцию платы, компенсирует насыщение
      ↑
hal_adc           отдаёт сырой код АЦП
```

То же для инверсии: флаг полярности живёт в `hal_pwm` / `drv_hc595`,
а не в вызывающем коде. Иначе однажды забудут инвертировать, и «ноль»
превратится в «полный газ».

Это уточнение к `ARCHITECTURE.md`: между HAL и сервисами нужен слой
драйверов платы, который сейчас пустой.

---

## Порядок работ с учётом железа

Найденное при аудите: **силовое питание моторов идёт через реле,
реле управляются через PCA9535, драйвера PCA9535 не существует.**
На реальной плате моторы сегодня обесточены при любом ШИМ.

Значит порядок MVP из ТЗ не совпадает с графом зависимостей:

```
MVP-1 (моторы)  ──требует──>  PCA9535 (числится в MVP-3)
                              └── и, возможно, сердцебиение реле (A-1)
```

**Развилка:**

| Вариант | Что делает | Цена |
|---|---|---|
| Перемычка на реле для стенда | Быстро, моторы под током сразу | Стенд не проверяет цепь безопасности; легко забыть снять |
| **Драйвер PCA9535 переносится в MVP-1** ★ | Стенд с самого начала повторяет боевую конфигурацию | +2–3 дня на `hal_i2c` + `drv_pca9535` |

Рекомендация — второй вариант: цепь силового питания это цепь
безопасности, и отлаживать её надо с первого дня, а не подключать
в конце. Заодно закрывается A-1.

---

## Сводка: что блокирует что

| Замер | Блокирует | Статус |
|---|---|---|
| A-0 паспорт ZS-X11H | полярности, диапазон частот | ✅ закрыт документацией |
| A-1 реле NE555 | нужна ли задача-сердцебиение | ✅ ШИМ-драйвер, сердцебиение не нужно |
| A-2 биты HC595 | направление, тормоз, стоп | ✅ прочитан со схемы, совпал с ТЗ |
| A-3 оптопары ШИМ | профили частоты | ✅ не инвертируют, полоса в порядке |
| A-4 разгон при сбросе | **безопасность на каждом сбросе** | ⛔ **запаять 3 резистора** |
| A-5 подтяжки DIR/BRAKE/STOP | уровень покоя | ⬜ решение по BRAKE за владельцем |
| A-6 цифровая распиновка | всё | ✅ подтверждена, `cfg_board.h` верен |
| B-1 аналоговые каналы | педали, токи, калибровку | ⚠️ карта условная, уточняется из веба |
| B-2 диапазон АЦП | калибровку и пересчёт тока | ⚠️ принято 614, шина 7 В позже |
| B-3 фронт энкодера | измерение скорости | ⬜ осциллограф |
| B-4 импульсы/оборот | скорость и одометр | ⬜ владелец перепроверит (ожидается 36) |
| B-5 мёртвая зона | трогание с места | ⬜ замер |
| C-1 датчик положения | MVP-2 | ✅ HX711 на D5/D12, A3 под положение |
| C-2 Timer0 vs millis | частоту ШИМ руля | ⬜ решение владельца |
| C-3 полумосты BTS7960 | безопасность драйвера руля | ⬜ реализовать инвариант |
| D-1 загрузчик | аппаратный watchdog | ⬜ проверить |

## Порядок первого выхода на стенд

Питание сейчас подключается в обход реле вручную, значит моторы можно
крутить, не написав ни строчки для PCA9535. Разумная последовательность:

1. **A-2 (прозвонка HC595)** — полчаса, без питания, ничего не сгорит.
   Без этого любой код управления моторами пишется вслепую.
2. **A-3 (оптопары ШИМ)** — определяет, реализуема ли вообще идея
   настраиваемых частот. Если полоса упирается в 1–2 кГц, менять надо
   железо, а не код.
3. **B-1 + B-2 (аналоговые входы)** — после этого можно калибровать педали.
4. **B-3 + B-4 (энкодеры)** — после этого скорость становится настоящей.
5. Только затем — первое вращение колеса под управлением прошивки,
   с вывешенными колёсами и рукой на кнопке E-Stop.

**До первого вращения обязательно закрыть** очереди 0 и 1 из `AUDIT.md`:
неисправный TX-буфер, сентинел 0xFF, аварийная остановка, снимающаяся сама
через 200 мс, и настройки, принимающие `brake_rate_max = 0`.
