Gsmads/EV-Controller/firmware/cfg_board.h

/**
 * @file cfg_board.h
 * @brief Аппаратная конфигурация платы (compile-time)
 *
 * Карта пинов Arduino Nano, назначение таймеров, адреса I2C,
 * условная компиляция модулей. При портировании — заменить этот файл.
 */
#pragma once
#include <stdint.h>

/* ==== Идентификация ==== */
#define BOARD_NAME              "TED_CAR_DRIVER_V1"
#define BOARD_MCU               "ATmega328P"
#define BOARD_CLOCK_HZ          16000000UL

/* ==== Пины: UART / RS485 ==== */
#define PIN_UART_RX             0
#define PIN_UART_TX             1
#define PIN_RS485_DE_RE         4

/* ==== Пины: энкодеры (INT0/INT1) ==== */
#define PIN_ENCODER_RIGHT       2
#define PIN_ENCODER_LEFT        3

/* ==== Пины: HX711 ==== */
#define PIN_HX711_DOUT          5
#define PIN_HX711_SCK           12

/* ==== Пины: ШИМ ==== */
#define PIN_EPS_PWM             6
#define PIN_MOTOR_LEFT_PWM      9
#define PIN_MOTOR_RIGHT_PWM     10

/* ==== Пины: PCA9535, HC595, SPI ==== */
#define PIN_PCA9535_INT         7
#define PIN_HC595_LATCH         8
#define PIN_SPI_MOSI            11
#define PIN_SPI_SCK             13

/* ==== Аналоговые входы ====
 * Здесь их больше нет. По ADR-0009 номера каналов АЦП живут в настройках
 * и меняются из веба: соответствие сигналов входам определяется тем, как
 * легли провода при монтаже, а по схеме оно не восстанавливается.
 * См. поля adc_ch_* в settings_t.
 *
 * Заодно это снимало последнюю причину, по которой прошивка не собиралась:
 * макросы A0…A7 объявлены только в Arduino.h, а cfg_board.h включают файлы
 * слоя svc_*, которым Arduino.h запрещён (ADR-0001).
 */

/** Число каналов АЦП у ATmega328P. Свойство микроконтроллера, не настройка. */
#define ADC_CHANNEL_COUNT       8

/* ==== HC595 битовые позиции ==== */
#define HC595_BIT_EPS_RIGHT     0
#define HC595_BIT_DIR_RIGHT     1
#define HC595_BIT_STOP_RIGHT    2
#define HC595_BIT_BRAKE_RIGHT   3
#define HC595_BIT_DIR_LEFT      4
#define HC595_BIT_STOP_LEFT     5
#define HC595_BIT_BRAKE_LEFT    6
#define HC595_BIT_EPS_LEFT      7

/* ==== PCA9535 ==== */
#define PCA9535_I2C_ADDR        0x20
#define PCA9535_P0_POWER_EPS    5
#define PCA9535_P0_POWER_MOT_R  6
#define PCA9535_P0_POWER_MOT_L  7

/* ==== Энкодеры и колёса ==== */
#define ENCODER_PULSES_PER_REV  12
#define WHEEL_DIAMETER_MM       200

/* Фильтр дребезга энкодера (ADR-0023).
 *
 * Фронт, пришедший раньше этого времени после предыдущего, физически
 * невозможен и считается наводкой. Граница выведена, а не выбрана:
 * 200 мкс между импульсами при 12 импульсах на оборот означают
 * 60 000 000 / (200 x 12) = 25 000 об/мин колеса. Реальный потолок
 * детского электромобиля - сотни оборотов в минуту, то есть запас
 * больше тридцати раз даже при вчетверо более частом энкодере.
 *
 * Фильтр нужен именно из-за перехода на измерение времени: при подсчёте
 * импульсов лишний фронт добавлял доли процента к скорости, а при
 * измерении периода один короткий интервал даёт выброс на порядок.
 */
#define ENCODER_MIN_PERIOD_US   200

/* Порог остановки (ADR-0023).
 *
 * Период длиннее этого не считается измерением скорости: колесо стоит.
 * 500 мс при 12 импульсах на оборот и D = 200 мм дают нижнюю границу
 * 60 / (0,5 x 12) = 10 об/мин = 0,38 км/ч. Медленнее машина честно
 * показывает "стоим", а не выдуманное маленькое число.
 */
#define ENCODER_STOP_TIMEOUT_US 500000UL

/* ==== UART: скорость ====
 * 250000 бод, ADR-0015. Делится на 16 МГц нацело: при включённом удвоителе
 * UBRR = 7, ошибка 0,00 %. У 115200 ошибка +2,12 % — работоспособно, но весь
 * допуск 8N1 израсходован, а линия идёт рядом с силовой частью.
 * Это умолчание при старте; по ADR-0019 скорость станет настройкой
 * с испытательным периодом и откатом к этому значению.
 */
#define UART_BAUD_DEFAULT       250000UL

/* ==== UART: размеры буферов ====
 * Полезная ёмкость кольца на единицу меньше объявленного размера: одна
 * ячейка не используется, иначе пустое кольцо неотличимо от полного
 * (см. util_ring.h). Отсюда требование к TX: максимальный кадр протокола —
 * 1 (sync) + 1 (len) + 1 (cmd) + 60 (PROTO_MAX_PAYLOAD) + 2 (CRC) = 65 байт,
 * поэтому 64 не хватало ровно на один байт и самые длинные кадры
 * отбрасывались бы всегда. 72 даёт запас 7 байт.
 */
#define RX_BUFFER_SIZE          64
#define TX_BUFFER_SIZE          72

/* ==== Датчики тока (ACS712-20A) ==== */
#define CURRENT_SENSOR_MV_PER_A     100
#define CURRENT_SENSOR_ZERO_MV      2500

/* ==== Аппаратный watchdog ====
 * ADR-0022. Выключен и включается одним флагом здесь.
 *
 * НЕ ВКЛЮЧАТЬ на стоковом загрузчике Arduino Nano. Старый загрузчик не
 * сбрасывает флаг WDRF и не выключает watchdog при старте. После первого
 * же срабатывания плата уходит в бесконечный цикл: watchdog перезагружает
 * MCU -> управление получает загрузчик -> watchdog снова срабатывает, не
 * дождавшись передачи управления скетчу. Код приложения при этом не
 * выполняется ни разу, перепрошить по USB невозможно, выход только
 * программатором по ICSP.
 *
 * Порядок включения:
 *   1. прошить optiboot (он выключает watchdog и чистит WDRF в первых
 *      инструкциях);
 *   2. поставить здесь 1 и перепрошить скетч;
 *   3. проверить по критерию приёмки из ADR-0022.
 *
 * Таймаут 8 с — максимум для ATmega328P. Такт сброса 100 мс даёт
 * восьмидесятикратный запас: watchdog сработает только при настоящем
 * зависании, а не при разовой длинной задаче.
 */
#define WATCHDOG_ENABLED            0
#define WATCHDOG_KICK_INTERVAL_MS   100

/* ==== Условная компиляция ==== */
/* #define BOARD_HAS_HC595      1 */    /* MVP-3+ */
/* #define BOARD_HAS_PCA9535    1 */    /* MVP-3+ */
/* #define BOARD_HAS_HX711      1 */    /* MVP-2+ */
/* #define BOARD_HAS_RS485      1 */    /* MVP-4+ */
/* #define BOARD_HAS_ENCODERS   1 */    /* MVP-2+ */
#define BOARD_DEBUG_ENABLED     1
