Gsmads/EV-Controller/tests/test_svc_pedals.c

/**
 * @file test_svc_pedals.c
 * @brief Юнит-тест педалей: слоистая модель и работа с сигналами
 *
 * Проверка ADR-0020 с десктопной стороны: сервис обращается к сигналам
 * по имени и не знает ни одного номера канала АЦП. Мок подменяет
 * hal_adc_read_signal и запоминает, что именно у него спрашивали.
 *
 * Компиляция: см. tests/Makefile
 */
#include <stdio.h>
#include <string.h>
#include "../firmware/svc_pedals.h"
#include "../firmware/hal_adc.h"
#include "../firmware/cfg_settings.h"

static int pass = 0, fail = 0;
#define ASSERT_EQ(a, b, msg) do { if ((a)==(b)) pass++; else { printf("  FAIL: %s (exp=%d got=%d)\n", msg, (int)(a), (int)(b)); fail++; } } while(0)

/* ==== Моки HAL ==== */

static uint16_t signal_value[ANALOG_SIGNAL_COUNT];
static uint16_t signal_reads[ANALOG_SIGNAL_COUNT];
static uint8_t  channel_reads;            /* обращений к hal_adc_read по номеру */
static uint32_t mock_millis_value;

uint16_t hal_adc_read_signal(analog_signal_t signal) {
    if (signal >= ANALOG_SIGNAL_COUNT) return 0;
    signal_reads[signal]++;
    return signal_value[signal];
}
uint16_t hal_adc_read(uint8_t channel) {
    (void)channel;
    channel_reads++;                      /* сервис не должен сюда попадать */
    return 0;
}
void     hal_adc_init(void) {}
void     hal_adc_bind(analog_signal_t s, uint8_t c) { (void)s; (void)c; }
uint16_t hal_adc_unbound_count(void) { return 0; }
uint16_t hal_adc_bad_channel_count(void) { return 0; }
uint32_t hal_system_millis(void) { return mock_millis_value; }

/* Мок EEPROM — cfg_settings нужен для калибровки и комбинаторов */
static uint8_t mock_eeprom[1024];
void hal_nvm_read(uint16_t addr, uint8_t *buf, uint16_t len) {
    if (addr + len <= sizeof(mock_eeprom)) memcpy(buf, mock_eeprom + addr, len);
}
void hal_nvm_write(uint16_t addr, const uint8_t *buf, uint16_t len) {
    if (addr + len <= sizeof(mock_eeprom)) memcpy(mock_eeprom + addr, buf, len);
}
uint8_t hal_nvm_read_byte(uint16_t addr) {
    return (addr < sizeof(mock_eeprom)) ? mock_eeprom[addr] : 0xFF;
}
void hal_nvm_write_byte(uint16_t addr, uint8_t d) {
    if (addr < sizeof(mock_eeprom)) mock_eeprom[addr] = d;
}

static void setup_clean(void) {
    memset(mock_eeprom, 0xFF, sizeof(mock_eeprom));
    memset(signal_value, 0, sizeof(signal_value));
    memset(signal_reads, 0, sizeof(signal_reads));
    channel_reads = 0;
    mock_millis_value = 1000;
    cfg_settings_init();
    svc_pedals_init();
}

/* ====================================================================
 *  ADR-0020: сервис называет сигналы, а не каналы
 * ==================================================================== */

void test_reads_by_signal_name(void) {
    printf("--- test_reads_by_signal_name ---\n");
    setup_clean();
    svc_pedals_update();

    ASSERT_EQ(1, signal_reads[ANALOG_PEDAL_GAS] > 0,
              "ADR-0020: газ прочитан как сигнал ANALOG_PEDAL_GAS");
    ASSERT_EQ(1, signal_reads[ANALOG_PEDAL_BRAKE] > 0,
              "ADR-0020: тормоз прочитан как сигнал ANALOG_PEDAL_BRAKE");
    ASSERT_EQ(0, channel_reads,
              "ADR-0020: сервис ни разу не обратился к каналу по номеру");
}

void test_does_not_touch_other_signals(void) {
    printf("--- test_does_not_touch_other_signals ---\n");
    setup_clean();
    svc_pedals_update();
    ASSERT_EQ(0, signal_reads[ANALOG_CURRENT_RIGHT], "ток правого мотора не трогается");
    ASSERT_EQ(0, signal_reads[ANALOG_CURRENT_LEFT],  "ток левого мотора не трогается");
    ASSERT_EQ(0, signal_reads[ANALOG_STEERING_POS],  "положение руля не трогается");
}

void test_signal_value_reaches_pedal(void) {
    printf("--- test_signal_value_reaches_pedal ---\n");
    setup_clean();
    /* Умолчания калибровки: pedal_gas_min = 10, pedal_gas_max = 1000 */
    signal_value[ANALOG_PEDAL_GAS] = 10;
    svc_pedals_update();
    ASSERT_EQ(10, svc_pedals_get_gas_raw(), "сырое значение сигнала дошло до педали");

    signal_value[ANALOG_PEDAL_GAS] = 500;
    svc_pedals_update();
    ASSERT_EQ(500, svc_pedals_get_gas_raw(), "и следующее тоже");
}

/* ====================================================================
 *  Слоистая модель: физическая педаль и виртуальная
 * ==================================================================== */

void test_physical_pedal_released(void) {
    printf("--- test_physical_pedal_released ---\n");
    setup_clean();
    signal_value[ANALOG_PEDAL_GAS] = 10;      /* минимум калибровки */
    for (int i = 0; i < 400; i++) svc_pedals_update();   /* сойтись фильтру */
    ASSERT_EQ(0, svc_pedals_get_gas(), "педаль в нижней точке — газа нет");
    ASSERT_EQ(0, svc_pedals_is_gas_active(), "признак нажатия снят");
}

void test_uart_pedal_adds_to_physical(void) {
    printf("--- test_uart_pedal_adds_to_physical ---\n");
    setup_clean();
    signal_value[ANALOG_PEDAL_GAS] = 10;      /* физическая отпущена */
    for (int i = 0; i < 400; i++) svc_pedals_update();
    ASSERT_EQ(0, svc_pedals_get_gas(), "до команды газа нет");

    svc_pedals_set_uart_gas(500);
    svc_pedals_update();
    ASSERT_EQ(500, svc_pedals_get_gas_uart(), "виртуальная педаль приняла значение");
    ASSERT_EQ(500, svc_pedals_get_gas(), "комбинатор max: газ пришёл по UART");
}

void test_uart_watchdog_releases_virtual_pedal(void) {
    printf("--- test_uart_watchdog_releases_virtual_pedal ---\n");
    setup_clean();
    signal_value[ANALOG_PEDAL_GAS] = 10;
    svc_pedals_set_uart_gas(800);
    svc_pedals_update();
    ASSERT_EQ(800, svc_pedals_get_gas_uart(), "виртуальный газ задан");

    /* Умолчание uart_pedal_timeout_ms = 200 мс */
    mock_millis_value += 1000;
    svc_pedals_update();
    ASSERT_EQ(0, svc_pedals_get_gas_uart(),
              "watchdog: команды перестали приходить — виртуальная педаль отпущена");
}

void test_release_uart(void) {
    printf("--- test_release_uart ---\n");
    setup_clean();
    svc_pedals_set_uart_gas(600);
    svc_pedals_set_uart_brake(700);
    svc_pedals_update();
    svc_pedals_release_uart();
    svc_pedals_update();
    ASSERT_EQ(0, svc_pedals_get_gas_uart(),   "явное освобождение обнуляет газ");
    ASSERT_EQ(0, svc_pedals_get_brake_uart(), "и тормоз");
}


/* ====================================================================
 *  ADR-0004: все пять комбинаторов
 *
 *  Комбинатор решает, как складываются педаль ребёнка и команда родителя.
 *  Это ядро слоистой модели, и до сих пор проверялось только умолчание.
 * ==================================================================== */

/** Довести физическую педаль до заданного сырого значения и дать фильтру сойтись. */
static void settle_physical_gas(uint16_t raw) {
    signal_value[ANALOG_PEDAL_GAS] = raw;
    for (int i = 0; i < 400; i++) svc_pedals_update();
}

static void set_gas_combinator(uint8_t mode) {
    cfg_settings_get_mutable()->gas_combinator = mode;
}

void test_combine_max(void) {
    printf("--- test_combine_max ---\n");
    setup_clean();
    set_gas_combinator(PEDAL_COMBINE_MAX);
    settle_physical_gas(1000);                 /* физическая почти в полу */
    uint16_t physical = svc_pedals_get_gas_physical();

    svc_pedals_set_uart_gas(200);
    svc_pedals_update();
    ASSERT_EQ(physical, svc_pedals_get_gas(),
              "MAX: побеждает большее — ребёнок жмёт сильнее родителя");

    svc_pedals_set_uart_gas(1023);
    svc_pedals_update();
    ASSERT_EQ(1023, svc_pedals_get_gas(), "MAX: теперь больше команда родителя");
}

void test_combine_additive_clamp(void) {
    printf("--- test_combine_additive_clamp ---\n");
    setup_clean();
    set_gas_combinator(PEDAL_COMBINE_ADDITIVE_CLAMP);
    settle_physical_gas(10);                   /* физическая отпущена */
    svc_pedals_set_uart_gas(300);
    svc_pedals_update();
    ASSERT_EQ(300, svc_pedals_get_gas(), "ADDITIVE: отпущенная педаль плюс 300 = 300");

    settle_physical_gas(1000);
    uint16_t physical = svc_pedals_get_gas_physical();
    svc_pedals_set_uart_gas(1023);
    svc_pedals_update();
    ASSERT_EQ(1023, svc_pedals_get_gas(),
              "ADDITIVE: сумма ограничена 1023, а не переполняется");
    ASSERT_EQ(1, physical + 1023 > 1023, "проверка условия: сумма действительно больше предела");
}

void test_combine_uart_priority(void) {
    printf("--- test_combine_uart_priority ---\n");
    setup_clean();
    set_gas_combinator(PEDAL_COMBINE_UART_PRIORITY);
    settle_physical_gas(1000);
    uint16_t physical = svc_pedals_get_gas_physical();

    svc_pedals_set_uart_gas(0);
    svc_pedals_update();
    ASSERT_EQ(physical, svc_pedals_get_gas(),
              "UART_PRIORITY: нулевая команда не перебивает — действует педаль");

    svc_pedals_set_uart_gas(100);
    svc_pedals_update();
    ASSERT_EQ(100, svc_pedals_get_gas(),
              "UART_PRIORITY: ненулевая команда перебивает даже большую педаль");
}

void test_combine_physical_only(void) {
    printf("--- test_combine_physical_only ---\n");
    setup_clean();
    set_gas_combinator(PEDAL_COMBINE_PHYSICAL_ONLY);
    settle_physical_gas(1000);
    uint16_t physical = svc_pedals_get_gas_physical();

    svc_pedals_set_uart_gas(1023);
    svc_pedals_update();
    ASSERT_EQ(physical, svc_pedals_get_gas(),
              "PHYSICAL_ONLY: команда по UART не действует вовсе");
    ASSERT_EQ(1023, svc_pedals_get_gas_uart(),
              "но принята и видна в телеметрии — отказ не молчаливый");
}

void test_combine_uart_only(void) {
    printf("--- test_combine_uart_only ---\n");
    setup_clean();
    set_gas_combinator(PEDAL_COMBINE_UART_ONLY);
    settle_physical_gas(1000);
    ASSERT_EQ(1, svc_pedals_get_gas_physical() > 0, "физическая педаль нажата");

    svc_pedals_set_uart_gas(0);
    svc_pedals_update();
    ASSERT_EQ(0, svc_pedals_get_gas(),
              "UART_ONLY: педаль ребёнка не действует — это режим полного перехвата");

    svc_pedals_set_uart_gas(400);
    svc_pedals_update();
    ASSERT_EQ(400, svc_pedals_get_gas(), "UART_ONLY: действует только команда");
}

void test_unknown_combinator_falls_back_to_max(void) {
    printf("--- test_unknown_combinator_falls_back_to_max ---\n");
    setup_clean();
    set_gas_combinator(200);                   /* значения не существует */
    settle_physical_gas(1000);
    uint16_t physical = svc_pedals_get_gas_physical();
    svc_pedals_set_uart_gas(100);
    svc_pedals_update();
    ASSERT_EQ(physical, svc_pedals_get_gas(),
              "неизвестный комбинатор ведёт себя как MAX — педаль ребёнка не теряется");
}

void test_brake_combinator_default_is_max(void) {
    printf("--- test_brake_combinator_default_is_max ---\n");
    setup_clean();
    ASSERT_EQ(PEDAL_COMBINE_MAX, cfg_settings_get()->brake_combinator,
              "умолчание тормоза — MAX: тормозит тот, кто жмёт сильнее");
    signal_value[ANALOG_PEDAL_BRAKE] = 1000;
    for (int i = 0; i < 400; i++) svc_pedals_update();
    uint16_t physical = svc_pedals_get_brake_physical();
    svc_pedals_set_uart_brake(10);
    svc_pedals_update();
    ASSERT_EQ(physical, svc_pedals_get_brake(),
              "слабая команда родителя не ослабляет тормоз ребёнка");
}

/* ====================================================================
 *  Кривая отклика, мёртвая зона и пересчёт в ШИМ
 *
 *  Эталонные точки посчитаны вручную по цепочке
 *  сырое -> util_map_u16(10..1000 -> 0..1023) -> мёртвая зона 20 -> кривая.
 *  Сырое 273 даёт 256 (четверть хода), сырое 516 - ровно 512.
 *
 *  Фильтр здесь намеренно выведен из игры: svc_pedals_init() засевает
 *  EMA точным значением сигнала, поэтому под проверкой остаётся
 *  арифметика кривой, а не остаток сходимости фильтра (он проверяется
 *  отдельно, test_ema_never_reaches_the_top).
 * ==================================================================== */

/** Подать на газ точное значение: засеять фильтр и сделать один шаг. */
static void apply_physical_gas(uint16_t raw) {
    signal_value[ANALOG_PEDAL_GAS] = raw;
    svc_pedals_init();
    svc_pedals_update();
}

static void set_gas_curve(uint8_t curve) {
    cfg_settings_get_mutable()->pedal_gas_curve = curve;
}

void test_curve_linear_passes_through(void) {
    printf("--- test_curve_linear_passes_through ---\n");
    setup_clean();
    set_gas_curve(PEDAL_CURVE_LINEAR);
    apply_physical_gas(273);
    ASSERT_EQ(256, svc_pedals_get_gas_physical(),
              "linear: четверть хода остаётся четвертью");
    apply_physical_gas(516);
    ASSERT_EQ(512, svc_pedals_get_gas_physical(), "linear: половина остаётся половиной");
}

void test_curve_quadratic_softens_start(void) {
    printf("--- test_curve_quadratic_softens_start ---\n");
    setup_clean();
    set_gas_curve(PEDAL_CURVE_QUADRATIC);
    apply_physical_gas(273);
    /* 256^2 / 1023 = 65536 / 1023 = 64,06 -> 64 */
    ASSERT_EQ(64, svc_pedals_get_gas_physical(),
              "quadratic: четверть хода даёт 64 из 1023, а не 256");
    apply_physical_gas(516);
    /* 512^2 / 1023 = 262144 / 1023 = 256,2 -> 256 */
    ASSERT_EQ(256, svc_pedals_get_gas_physical(),
              "quadratic: половина хода даёт четверть газа");
    apply_physical_gas(1000);
    ASSERT_EQ(1023, svc_pedals_get_gas_physical(),
              "quadratic: педаль в полу - газ в полу, кривая не отнимает потолок");
}

void test_curve_s_softens_both_ends(void) {
    printf("--- test_curve_s_softens_both_ends ---\n");
    setup_clean();
    set_gas_curve(PEDAL_CURVE_S_CURVE);
    apply_physical_gas(273);
    /* t = 256/1023 = 0,2502; 3t^2 - 2t^3 = 0,15653; x1023 = 160,1 -> 160 */
    ASSERT_EQ(160, svc_pedals_get_gas_physical(), "s-кривая: четверть хода даёт 160");
    apply_physical_gas(516);
    /* t = 1/2 - неподвижная точка: 3/4 - 1/4 = 1/2 */
    ASSERT_EQ(512, svc_pedals_get_gas_physical(),
              "s-кривая: середина хода - неподвижная точка, остаётся серединой");
}

void test_deadzone_renormalizes_the_rest_of_travel(void) {
    printf("--- test_deadzone_renormalizes_the_rest_of_travel ---\n");
    setup_clean();
    set_gas_curve(PEDAL_CURVE_LINEAR);
    /* deadzone = 20 в нормированных единицах. Сырое 30 даёт 20 - ещё зона. */
    apply_physical_gas(30);
    ASSERT_EQ(0, svc_pedals_get_gas_physical(), "внутри мёртвой зоны - ровно ноль");
    apply_physical_gas(31);
    ASSERT_EQ(1, svc_pedals_get_gas_physical(),
              "сразу за зоной отсчёт начинается с единицы");
    apply_physical_gas(1000);
    ASSERT_EQ(1023, svc_pedals_get_gas_physical(),
              "верх не потерян: остаток хода растянут обратно на весь диапазон");
}

void test_profile_pedal_curve_is_never_applied(void) {
    printf("--- test_profile_pedal_curve_is_never_applied ---\n");
    /* Дефект T-7 (docs/AUDIT.md): drive_profile_t.pedal_curve не читает
       никто. svc_pedals_update() профиля вообще не получает и всегда
       берёт глобальную settings_t.pedal_gas_curve. Умолчание Eco
       обещает "спокойный отклик" квадратичной кривой - обещание не
       выполняется. Тест фиксирует поведение как оно есть. */
    setup_clean();
    settings_t *s = cfg_settings_get_mutable();
    s->pedal_gas_curve = PEDAL_CURVE_LINEAR;
    s->profiles[DRIVE_MODE_ECO].pedal_curve = PEDAL_CURVE_QUADRATIC;

    apply_physical_gas(273);
    ASSERT_EQ(256, svc_pedals_get_gas_physical(),
              "T-7: кривая из профиля не действует - отклик остался линейным");
    ASSERT_EQ(PEDAL_CURVE_QUADRATIC, s->profiles[DRIVE_MODE_ECO].pedal_curve,
              "при этом значение в профиле лежит и выглядит настройкой");
}

void test_ema_never_reaches_the_top(void) {
    printf("--- test_ema_never_reaches_the_top ---\n");
    /* Дефект T-6 (docs/AUDIT.md): шаг фильтра равен (delta * alpha) >> 8
       и обнуляется, когда delta * alpha < 256. При alpha = 40 это
       delta <= 6 сотых долей единицы - фильтр замирает, не дойдя до
       цели. Педаль, прижатую к верхнему упору калибровки, видно как
       1020 из 1023. Величина 0,3 %, но потолок недостижим принципиально. */
    setup_clean();
    set_gas_curve(PEDAL_CURVE_LINEAR);
    settle_physical_gas(1000);
    ASSERT_EQ(1020, svc_pedals_get_gas_physical(),
              "T-6: педаль в верхнем упоре даёт 1020, а не 1023");

    /* А с точным засевом фильтра та же педаль даёт полный ход - значит
       недобор даёт именно фильтр, а не калибровка или мёртвая зона. */
    apply_physical_gas(1000);
    ASSERT_EQ(1023, svc_pedals_get_gas_physical(),
              "тот же вход без остатка фильтра даёт ровно 1023");
}

/* ====================================================================
 *  svc_pedals_get_target_pwm: то, что уходит в рампу
 * ==================================================================== */

void test_target_pwm_scales_by_max_pwm(void) {
    printf("--- test_target_pwm_scales_by_max_pwm ---\n");
    setup_clean();
    set_gas_curve(PEDAL_CURVE_LINEAR);
    apply_physical_gas(1000);
    ASSERT_EQ(400, svc_pedals_get_target_pwm(400, 30),
              "педаль в полу при max_pwm 400 даёт ровно 400");

    apply_physical_gas(516);
    /* 512 * 400 / 1023 = 204800 / 1023 = 200,19 -> 200 */
    ASSERT_EQ(200, svc_pedals_get_target_pwm(400, 30),
              "половина хода при max_pwm 400 даёт 200");
}

void test_target_pwm_brake_wins_over_gas(void) {
    printf("--- test_target_pwm_brake_wins_over_gas ---\n");
    setup_clean();
    apply_physical_gas(1000);
    ASSERT_EQ(1, svc_pedals_get_target_pwm(400, 30) > 0, "газ есть");

    signal_value[ANALOG_PEDAL_BRAKE] = 1000;
    for (int i = 0; i < 400; i++) svc_pedals_update();
    ASSERT_EQ(0, svc_pedals_get_target_pwm(400, 30),
              "ТЗ §6.2: тормоз главнее газа - цель ноль при обеих нажатых педалях");
}

void test_target_pwm_motor_deadzone_is_a_floor(void) {
    printf("--- test_target_pwm_motor_deadzone_is_a_floor ---\n");
    setup_clean();
    set_gas_curve(PEDAL_CURVE_LINEAR);
    /* Сырое 33 даёт газ 3; 3 * 400 / 1023 = 1,17 -> 1, что ниже
       motor_deadzone. На единице ШИМ мотор только гудит, поэтому первое
       же действующее нажатие поднимается до порога страгивания. */
    apply_physical_gas(33);
    ASSERT_EQ(3, svc_pedals_get_gas(), "газ 3 из 1023");
    ASSERT_EQ(30, svc_pedals_get_target_pwm(400, 30),
              "цель поднята с 1 до порога страгивания 30");

    apply_physical_gas(30);
    ASSERT_EQ(0, svc_pedals_get_gas(), "педаль в мёртвой зоне");
    ASSERT_EQ(0, svc_pedals_get_target_pwm(400, 30),
              "отпущенная педаль не поднимается до порога - ноль остаётся нулём");
}

int main(void) {
    printf("=========================================\n");
    printf("  svc_pedals Unit Tests\n");
    printf("=========================================\n\n");

    test_reads_by_signal_name();
    test_does_not_touch_other_signals();
    test_signal_value_reaches_pedal();
    test_physical_pedal_released();
    test_uart_pedal_adds_to_physical();
    test_uart_watchdog_releases_virtual_pedal();
    test_release_uart();
    test_combine_max();
    test_combine_additive_clamp();
    test_combine_uart_priority();
    test_combine_physical_only();
    test_combine_uart_only();
    test_unknown_combinator_falls_back_to_max();
    test_brake_combinator_default_is_max();
    test_curve_linear_passes_through();
    test_curve_quadratic_softens_start();
    test_curve_s_softens_both_ends();
    test_deadzone_renormalizes_the_rest_of_travel();
    test_profile_pedal_curve_is_never_applied();
    test_ema_never_reaches_the_top();
    test_target_pwm_scales_by_max_pwm();
    test_target_pwm_brake_wins_over_gas();
    test_target_pwm_motor_deadzone_is_a_floor();

    printf("\n=========================================\n");
    printf("  Results: %d passed, %d failed\n", pass, fail);
    printf("=========================================\n");
    return fail > 0 ? 1 : 0;
}
