Gsmads/EV-Controller/(commit log)

2026-09-09 Зафиксировать снимок проекта как есть, до первой правки
    Код прошивки ни разу не исполнялся на реальном железе: ни одной проверки
    на контроллере не было. Это подробный черновик, а не работающая система.
    Известны блокирующие дефекты (docs/AUDIT.md §1):
    - TX-буфер UART собирается 9 байт вместо 64, пакет телеметрии 41 байт
    затирает сам себя;
    - сентинел SERIAL_NO_DATA = 0xFF рвёт бинарный пакет, полный газ по U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
2026-09-10 docs: сменить лицензию проекта на GPL v3
    Репозиторий был создан с Apache-2.0 до появления кода, а firmware/MICRO_UART.*
    производны от Grbl (GPL v3), что зафиксировано в README. GPL v3 требует, чтобы
    производная работа распространялась целиком под GPL v3, поэтому Apache-2.0
    на таком репозитории не выполнялся для части кода.
    LICENSE заменён полным текстом GPL v3, раздел "Лицензия и происхождение"
    в README называет лицензию проекта,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
2026-09-10 ci: не пускать скомпилированные бинарники тестов в коммит
    .gitignore перечислял три имени поимённо, а tests/Makefile ведёт свой список
    в TESTS. Списки разъезжаются: четвёртый тест, добавленный по инструкции
    tests/README.md, собирается в файл, которого в .gitignore нет, и уходит
    в коммит вместе с исходником.
    Шаблон tests/test_* с обратными исключениями для .c/.cpp/.h закрывает будущие
    тесты без правки списка. Сторож tools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
2026-09-10 ci: собирать и прогонять tests/ на каждый push и pull request
    В репозитории не было ни задания CI, ни хука, ни скрипта: 71 тест прогонялся
    только по памяти автора изменения. Пункт 3 Definition of Done ("make run —
    0 failed") держался на добросовестности.
    Задание собирает и прогоняет tests/ на ubuntu-latest и падает при любом failed:
    main() каждого набора возвращает 1 при непустом счётчике ошибок, make прерывает
    рецепт на первом нену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
2026-09-12 ci: завести сторожей границ платформы со списком временных исключений
    Два правила проекта держались только памятью: "Arduino.h и avr/* не встречаются
    нигде, кроме hal_atmega328p.cpp" (ADR-0001) и "функции Arduino не используются
    нигде, включая HAL" (ADR-0002). Проверки не существовало, при том что три
    документа описывали её как действующую.
    tools/ci/check_layer_boundaries.py даёт обе проверки: headers и functions.
    Обе вырезают комментар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
2026-09-12 ci: не пускать рабочие копии агентов в историю
    Параллельная работа создаёт git-worktree в .claude/worktrees/ — второй
    чекаут этого же репозитория, включая собранные бинарники тестов.
    Каталог временный, удаляется по завершении работы; в коммит попадать
    не должен, иначе сторож 0.2.6 обходится с чёрного хода.
    Игнорируется только worktrees/, а не .claude/ целиком: если в проекте
    появятся настройки или навыки,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
2026-09-12 ci: закрыть обходы сторожей границ платформы, завести самопроверку
    Состязательная проверка сторожа, введённого коммитом 8f7f9e4, нашла 37
    подтверждённых обходов. Два из них означали, что сторож молча выключается
    и печатает успех, не посмотрев ни на что:
    * строка "/*" в коде гасила обе проверки до ближайшего */ или до конца
    файла: strip_comments не разбирал литералы;
    * отсутствие каталога firmware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
2026-09-12 ci: поднять actions/checkout до v5
    В логе каждого прогона: "Node.js 20 is deprecated. The following actions
    target Node.js 20 but are being forced to run on Node.js 24:
    actions/checkout@v4". Раннер уже подставляет Node 24 сам, то есть шаг
    и сейчас исполняется не на той среде, для которой собран.
    v5 собран под Node 24. Поведение шага не меняется: тот же checkout
    без параметров.
    Claude-Session: https://claude.ai/code/session_01MRYErnGCXiNp17yFkSbSR4
2026-09-12 ci: проверять компилятором каждый модуль firmware/
    Closes #33
    До этой проверки девять модулей из тринадцати не видел ни один компилятор:
    в tests/Makefile участвуют четыре файла, остальные проверялись чтением.
    tools/ci/check_modules_compile.sh гоняет g++ -fsyntax-only по каждому .cpp.
    Четыре модуля пропускаются поимённо с причиной: hal_atmega328p.cpp
    платформенный по ADR-0001, а MICRO_UART.cpp, PRINT.cpp и app_debug.cpp
    тянут Arduino.h и перестанут быть та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
2026-09-12 app: объявить NULL в app_protocol.cpp
    Часть дефекта B-5 docs/AUDIT.md.
    app_protocol.cpp:190 передаёт NULL в send_packet(RSP_PONG, NULL, 0), но
    включает только заголовки проекта. NULL объявлен в stddef.h, поэтому файл
    не компилируется — и не только на десктопе: Arduino IDE подставляет
    Arduino.h лишь в .ino, отдельные .cpp обязаны включать его сами.
    Сторож #33 на этом файле был красным:
    Сторож #33: модуль не компилируется — firmware/app_protocol.cpp
    firmware/app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
2026-09-13 docs: записать три решения владельца — скорость UART, политика TX, настройки
    ADR-0015: скорость обмена — 250000 бод, 8N1.
    Делится на 16 МГц нацело: UBRR=7 при U2X, ошибка 0,00%. У 115200 ошибка
    +2,12% с U2X и -3,55% без — работоспособно, но допуск 8N1 израсходован,
    а линия идёт рядом с силовой частью. Пакет телеметрии 41 байт занимает
    1,64 мс вместо 42,71; загрузка линии падает с 42,7% до 1,6%.
    ADR-0016: политика при переполнении TX вы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
2026-09-13 docs: записать решения по UART — переписать драйвер, скорость в настройки
    ADR-0018: MICRO_UART.* удаляются, UART пишется заново по слоям.
    Причина не в лицензии, а в том, что модуль непроверяем. MICRO_UART.cpp
    обращается к UCSR0A, UBRR0H, UDR0, F_CPU и определяет ISR, не включая
    avr/io.h — их тянул Arduino.h через MICRO_UART.h:22. Проверено: замена
    Arduino.h на stdint.h немедленно даёт "error: 'F_CPU' was not declared".
    То есть это платформенный код вне hal_atmega328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
2026-09-13 util: кольцевой буфер UART как переносимый модуль
    Первый шаг ADR-0018: часть драйвера, которая не зависит от платформы,
    выносится в util_ring и покрывается десктопными тестами. Регистры, ISR
    и делитель скорости остаются в hal_atmega328p.cpp и переезжают следующим
    изменением; MICRO_UART пока на месте и ещё используется.
    Тест был красным по-настоящему: до этого коммита
    "fatal error: ../firmware/util_ring.h: No such file or directory".
    Сейч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
    [test_util_ring.c, util_ring.cpp, util_ring.h]
2026-09-13 hal: переписать драйвер UART, удалить MICRO_UART
    Closes #31 частично: MICRO_UART.h больше нет, исключение сторожа для него
    снято. PRINT.h остаётся — он использует pgm_read_byte_near из avr/pgmspace.h,
    это отдельная работа.
    Реализация решения ADR-0018. MICRO_UART.cpp обращался к UCSR0A, UBRR0H,
    UDR0, F_CPU и определял ISR, не включая avr/io.h: их тянул Arduino.h через
    MICRO_UART.h. То есть платформенный код жил вне hal_atmega328p.cpp вопреки
    ADR-0001, и собрать его на деск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
2026-09-13 cfg: завести параметры UART в настройки, добавить миграцию v2 в v3
    Исполнение ADR-0016 и ADR-0019, начало исполнения правила ADR-0017.
    Три новых поля settings_t, дописаны в конец намеренно — так блок версии 2
    остаётся префиксом блока версии 3, и миграция сводится к чтению префикса:
    uart_baud_code код скорости, а не число. Произвольное значение
    в настройки попасть не может, делитель никогда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
2026-09-13 cfg: перенести карту каналов АЦП в настройки, убрать угадывание нумерации
    Исполнение ADR-0009, принятого ещё 09.09. Закрывает последнюю причину,
    по которой прошивка не компилировалась (B-5): макросы A0…A7 объявлены
    только в Arduino.h, а cfg_board.h включают файлы слоя svc_*, которым
    Arduino.h запрещён по ADR-0001.
    Вопрос "канал АЦП или вывод платы" решать было не нужно — ADR-0009 уже
    называет эти числа индексами кана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
2026-09-13 svc: вывести формулу скорости заново, она занижала в 3,65 раза
    Дефект B-3 docs/AUDIT.md. В коде стояло
    kmh_x10 = avg_rpm * WHEEL_DIAMETER_MM * 188UL / 360000UL;
    При D = 200 мм и 300 RPM это давало 31 вместо 113: машина, едущая
    11,3 км/ч, показывала 3,1. Дуга скорости на циферблате — центральный
    диагностический элемент дашборда, разница "скорость против ШИМ" читается
    как нагрузка; она врала бы втрое.
    Формула выведена заново от физи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
2026-09-13 docs: записать два архитектурных решения владельца
    ADR-0020: основной код называет сигналы, слой железа их привязывает.
    Реализация ADR-0009 вышла буквальной: svc_pedals читал из настроек номер
    канала АЦП и передавал его в hal_adc_read. Номер канала существует только
    потому, что внизу ATmega328P; на STM32 нумерация другая, на внешнем АЦП
    по SPI третья. Теперь наверх уходит имя сигнала (ANALOG_PEDAL_GAS),
    а таблица привяз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
2026-09-13 hal: основной код называет сигналы, слой железа их привязывает
    Реализация ADR-0020. Реализация ADR-0009 вышла буквальной: svc_pedals
    читал из настроек номер канала АЦП и передавал его в hal_adc_read.
    Номер канала существует только потому, что внизу ATmega328P — на STM32
    нумерация другая, на внешнем АЦП по SPI третья.
    Теперь hal_adc.h объявляет перечень сигналов системы (ANALOG_PEDAL_GAS,
    ANALOG_PEDAL_BRAKE, ANALOG_CURRENT_RIGHT, ANALOG_CURRENT_LEFT,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
2026-09-13 util: абстрагировать постоянное хранение, переименовать hal_eeprom в hal_nvm
    Closes #31
    Реализация ADR-0021. Программа теперь различает два хранилища по
    назначению, а не по технологии:
    постоянное util_rom — таблицы и строки, известные при сборке.
    На ATmega328P это PROGMEM.
    долговременное hal_nvm — настройки и одометр: меняются и переживают
    выключение. На ATmega328P это EEPROM.
    Имя hal_ee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
2026-09-13 cfg: завести реестр параметров, закрыть запись настроек на одну дверь
    Дефект S-3 docs/AUDIT.md, реализация ADR-0005. cfg_settings_set_field
    проверяла только выход за границы структуры:
    if (offset + size > sizeof(settings_t)) return 1;
    memcpy(ptr + offset, data, size);
    Поэтому brake_rate_max = 0 отключал тормоз и сохранялся в EEPROM.
    Красный тест показал это дословно:
    FAIL: S-3: brake_rate_max = 0 отвергнут (exp=5 got=0)
    FAIL: S-3: настройки не изменились (exp=1500 got=0)
    В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
    [cfg_params.cpp, cfg_params.h, cfg_settings.cpp, test_cfg_params.c]
2026-09-13 tests: покрыть парсер протокола, найден дефект T-4
    Пункт 11 очереди 2 docs/AUDIT.md. Парсер — единственная дверь, через
    которую в контроллер попадают команды извне, и он не был покрыт ничем.
    20 тестов на то, что случается на настоящей линии RS485 рядом с моторами:
    мусор перед синхробайтом, несошедшийся CRC, оборванный кадр, длина 0
    и длина сверх допустимой, два кадра подряд.
    Проверена связка с реестр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
2026-09-13 tests: покрыть все пять комбинаторов педалей
    До сих пор из ADR-0004 проверялось только умолчание MAX. Комбинатор -
    это то, как складываются педаль ребёнка и команда родителя, и четыре
    из пяти режимов не имели ни одного теста.
    Добавлено семь тестов (svc_pedals: 17 -> 32):
    - MAX берёт больший из двух входов в обе стороны;
    - ADDITIVE_CLAMP складывает и упирается в потолок 1023, а не
    переполняется (проверено и само у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
2026-09-13 tests: покрыть рампу, найдены дефекты S-5 и T-5
    Рампа - последнее звено перед мотором, и из десяти её тестов ни один
    не проверял ни аккумулятор дробных шагов, ни интерполяцию скорости
    торможения, ни профиль Failsafe. Добавлено девять тестов
    (svc_ramp: 10 -> 39):
    - аккумулятор: 50 PWM/с при 100 Гц - полшага за тик, рампа обязана
    тронуться на втором тике, а не стоять; 250 PWM/с даёт ровно 250 за
    секунду без накопле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
    [test_svc_ramp.cpp]
2026-09-13 tests: покрыть кривые отклика и пересчёт в ШИМ, найдены T-6 и T-7
    svc_pedals_get_target_pwm() - то, что уходит в рампу, - не был покрыт
    ни одним тестом, как и три кривые отклика через сервис. Добавлено
    одиннадцать тестов (svc_pedals: 32 -> 54).
    Эталонные точки посчитаны вручную по цепочке
    сырое -> util_map_u16(10..1000 -> 0..1023) -> мёртвая зона 20 -> кривая:
    - сырое 273 даёт четверть хода (256); на ней linear возвращает 256,
    quadratic 64 = 256^2/1023, s-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
2026-09-13 wdt: завести аппаратный watchdog под флаг, по умолчанию выключен
    Дефект S-2: hal_system_wdt_enable() существовал в HAL и не вызывался
    ниоткуда, а ARCHITECTURE.md числил задачу wdt_reset, которой в коде не
    было. Просто включить watchdog нельзя: стоковый загрузчик Nano не
    сбрасывает WDRF и не выключает watchdog при старте, поэтому после
    первого срабатывания плата уходит в цикл перезагрузок внутри
    загрузчика - код приложения не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
2026-09-13 speed: считать скорость только временем между импульсами
    Решение владельца: отказаться от всех способов измерения скорости,
    кроме времени между импульсами. Двух способов не заводить, тем более
    когда один заведомо неточен. ADR-0023.
    Прежний способ считал импульсы за окно 100 мс. При 12 импульсах на
    оборот один импульс - это 50 об/мин, то есть 1,9 км/ч: между 5,7 и 7,5
    у такого способа нет ни одного з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
